ToddHoug/cadzilla/tools/altairsim/README.md

# tools/altairsim — CADzilla's 8080/CP/M build-and-run environment

Every `software/<toolchain>/<project>` in this repo is a program meant to run under CP/M
2.2. It is one of these:
- 8080 assembly built inside CP/M by `ASM.COM` or `M80`;
- 8080, 8085 or Z80 assembly or C, built on the host by z88dk
  (`tools/z88dk/README.md`).

 Before it ever touches real S100/Altair hardware,
it's built and exercised on [altairsim](https://github.com/) (installed
locally at `~/altairsim`), driven by an AI assistant through altairsim's
built-in MCP server. This directory holds everything that workflow needs.

## Naming convention

**Files that pass through the CP/M toolchain are UPPERCASE on both the
host and the CP/M side** — everything under `software/<toolchain>/<project>/src/` and
`software/<toolchain>/<project>/build/` (`HELLO.ASM`, `HELLO.COM`, `HELLO.HEX`,
`HELLO.PRN`, ...), and every `ASM`/`LOAD`/run/`W` argument typed at the
CP/M console. The same name is used consistently everywhere — no renaming
between host and CP/M. Directory names (`software/asm/hello/`, `src/`,
`build/`, `work/`) still follow this repo's normal lowercase convention
(`CLAUDE.md`); only the files themselves are uppercase.

This also sidesteps a real gotcha explained below: CP/M uppercases
everything you type at its console anyway, so a mixed-case CP/M-side name
could never be created from the command line in the first place.

## Layout

- `pristine/` — the read-only master copy of the CP/M machine definition
  (`cadzilla.toml`) and the disk image templates (`CPM22SYS.DSK`,
  `EMPTY.DSK` — see "Disk images" below). **Never edit or boot these directly** — always work
  against a copy in a project's own `work/` (below). CP/M writes to a
  mounted disk in place, so booting or `CONFIG LOAD`-ing
  `pristine/cadzilla.toml`, or `MOUNT`-ing a pristine `.DSK`, writes
  whatever you build straight into the master image (this has happened:
  HELLO project files ended up in the pristine CP/M disk). As a guard the
  pristine files are kept **read-only on the host** (`sync_pristine.sh`
  re-applies `chmod a-w` on every run, since git doesn't track write
  permission), and altairsim then mounts them `WRITE-PROTECTED`. If CP/M
  ever reports a write-protect error, the wrong disk is mounted — fix
  the path, never the permissions. `git status tools/altairsim/pristine`
  should always be clean after a session. `cadzilla.toml` is a
  delta on altairsim's own `machines/cadzilla.toml` — the real board with
  its console, front panel, flat-out CPU, host bridge, an empty disk
  controller and 56K of RAM — adding what CP/M needs to boot: 62K of
  RAM (0000-F7FF) and the DBL boot PROM at FF00, this project's disks in drives 0 and 1, the
  `RUN FF00` startup and the console's Backspace mapping — plus the
  monitor resolution (cad0 `mode = "1024x768"`), stated explicitly rather
  than inherited from the base (see "Display resolution"). See the comments
  in the file itself for the full reasoning. `CPM22SYS.DSK` (drive 0) is an 8MB virtual hard disk
  carrying CP/M 2.2 for 62K of RAM (0000-F7FF; see "62K CP/M" below) and its tools (`ASM.COM`,
  `LOAD.COM`, `DDT.COM`, Microsoft's `M80`/`L80`/`LIB80`/`CREF80.COM`,
  DRI's `RMAC`/`LINK`/`LIB`/`XREF.COM` (see "The DRI RMAC/LINK
  toolchain"), the
  host-bridge `R`/`W`/`HDIR.COM`, and more disk tools than the old 8"
  floppy image had room for); `EMPTY.DSK` is an empty 8MB volume, the
  template for a project's scratch disk and czgfx's build disk. `cadzilla-real.toml` is the
  real-time variant — a delta on the `cadzilla.toml` beside it that sets a
  2 MHz CPU and cad0 `draw_rate = "real"` (see "Running in real time").
- `scripts/sync_pristine.sh [--machine-only] <dest-dir>` — copies the
  pristine machine and the disks into any destination directory, creating
  it if needed: `CPM22SYS.DSK` as is, and `EMPTY.DSK` as `SCRATCH.DSK`. Used to set up a new project's own `work/`, and to recover a
  work directory that's ended up in a bad state. `--machine-only` copies
  just the machine files (`cadzilla.toml`, `cadzilla-real.toml`) and leaves the destination's disks alone — use it to
  pick up a change to the pristine machine definition in every existing
  `software/*/*/work/` without losing what's been built there. Either way,
  if the directory above `<dest-dir>` has a `machine.toml` (the project's
  tracked overlay, `software/<toolchain>/<project>/machine.toml`), it is appended to
  the copied `cadzilla.toml` — see "Display resolution". It makes the
  copies writable, keeps pristine read-only, and refuses to target
  `pristine/` itself.
- `scripts/attach_libdisk.sh [--writable] <work-dir>` — gives a work
  machine the czgfx library as drive 1 (CP/M `B:`), read-only:
  - it copies the czgfx release the project pins in
    `software/<toolchain>/<project>/czgfx.version` into `work/` as
    `CZGFXLIB-<version>.DSK`, and mounts it;
  - it removes copies of releases no longer pinned, and the now-unmounted
    `SCRATCH.DSK`, but only if they are unchanged.

  `--writable` is for czgfx's own `work/` alone: it mounts the build disk
  `software/m80/czgfx/libdisk/CZGFXLIB.DSK` writable, creating it from
  `pristine/EMPTY.DSK` if needed. See "The M80/L80 toolchain" below. Re-run
  it after
  `sync_pristine.sh --machine-only`, which puts the pristine drive 1 back.
- `upstream/` — a local, gitignored cache of the upstream archives and disk
  images that third-party tools on the pristine disk were taken from. Only
  its `README.md` (provenance, SHA-256s, licence) is tracked.
  `scripts/fetch_upstream.sh` (re)creates it:
  - it downloads `yazecpm3.zip` and z80pack's `Z80PACK-CPM3-2.DSK`;
  - it checks every download against a pinned SHA-256;
  - it extracts the DRI tools, uppercased, into `upstream/DRI/`, ready for
    `R`.
- `scripts/check_dsk.py <image.DSK>...` — checks every sector of a CP/M
  disk image for a valid stop byte and checksum; exit status 1 on any bad
  sector. Run it on a project's disks after a session. A bad sector means
  the disk was unmounted while the BIOS was still flushing (see "Ending a
  session").
- `scripts/crlf.sh <file>...` — gives text files CP/M's CR/LF line
  endings in place (idempotent). Run it on every `.ASM`/`.MAC`/`.INC`/`.SUB`
  before `R`: files written on this host are LF-only, and an LF-only
  source assembles to nothing without an error.
- `scripts/cpmsession.py build <project>` — the CP/M side of a build, run
  headlessly, with no assistant and no typing. It is what `tools/build.sh`
  runs; see "Building without an assistant" below.
- `DRIVING-WITH-AI.md` — altairsim's own guide for driving it via MCP
  (kept here for reference; canonical copy lives in `~/altairsim/docs/`).

**Every `software/<toolchain>/<project>/` also has its own `work/`** — a project's
private, gitignored copy of the pristine machine + disk(s), created once
(by the `new-cadzilla-project` skill, or by hand with `sync_pristine.sh`)
and then persisting across sessions for that project alone. Because each
project's disk is its own, switching between projects never means
resetting anything — you just point the server at a different project's
`work/cadzilla.toml`.

## Disk images

Disk images are named for what they hold, not where they came from. The
names are host-side only (CP/M never sees them) and UPPERCASE, as the
other files that pass through CP/M are.

| Image | Where | Holds | Mounted as |
|---|---|---|---|
| `CPM22SYS.DSK` | `pristine/` | the template: CP/M 2.2 (62K) and the dev tools | never — it is only copied |
| `EMPTY.DSK` | `pristine/` | the template: an empty 8MB volume | never — it is only copied |
| `CPM22SYS.DSK` | `software/<toolchain>/<project>/work/` | the project's own copy of the system disk: CP/M, the tools, and everything built there | drive 0, `A:` |
| `SCRATCH.DSK` | `software/<toolchain>/<project>/work/` | a copy of `EMPTY.DSK`, for scratch | drive 1, `B:`, in the DRI `ASM` projects |
| `CZGFXLIB.DSK` | `software/m80/czgfx/libdisk/` | the czgfx library as last built: `CZGFX.INC`, `CZGFX.REL`, `CZLINK.SUB` | drive 1, `B:`, writable, in czgfx's own `work/` only |
| `CZGFXLIB-<version>.DSK` | `software/m80/czgfx/releases/` | a czgfx release, snapshot of the build disk (tracked, never changed) | never — it is only copied |
| `CZGFXLIB-<version>.DSK` | `software/<toolchain>/<project>/work/` | the project's own copy of the czgfx release it pins in `czgfx.version` | drive 1, `B:`, read-only, in the M80 projects |
| `CZBDEMO.DSK` | `software/m80/czbasic/demodisk/` | the bootable CZBASIC demo disk | drive 0 of its own machine |
| `CADZILLA.DSK` | `demodisk/` | every program but the hello examples, on a copy of `CPM22SYS.DSK`; made by `tools/demodisk.py` (gitignored) | drive 0 of its own machine |

`sync_pristine.sh` makes the `work/` copies of the templates. `attach_libdisk.sh`
swaps an M80 project's `SCRATCH.DSK` for its own copy of its pinned czgfx
release. A `work/` is therefore self-contained: nothing it mounts lies
outside it.

### 62K CP/M

The pristine system disk was a 56K CP/M until 2026-10-08. It is now a **62K
CP/M 2.2**:
- **Memory map:** CCP at C600H, BDOS at CE06H, BIOS from DC00H to F7FFH.
  The TPA runs from 0100H to CDFFH, 6 KB more than before.
- **The reason:** GSX graphics. GDOS loads its device driver below itself,
  out of the program's TPA. With the CADzilla driver (`software/rmac/ddcz`, 11.5
  KB) that left too little for DR Graph or DEMOGRAF.
- **How it was built:** with the disk's own tools, on a copy, never in
  place:
  - `MOVCPM8M 62 *`, then `SYSGEN` (source: RETURN to skip, destination:
    `A`);
  - 60 sectors of the two system tracks changed, and nothing else;
  - booted on a 62K machine, it passed ASM/LOAD, RMAC/LINK, a warm boot,
    DEMOGRAF and DR Graph.
- **The machine:** pristine `cadzilla.toml` now gives mem0 62K of RAM
  (0000-F7FF), below the DBL boot PROM at FF00.

What it means for each disk:
- **Older disks still work:** a `work/` disk synced before 2026-10-08 is
  still the 56K system, and boots on either machine.
- **A 62K disk does not boot on a 56K machine.** A `work/` that holds a
  62K disk needs the 62K `cadzilla.toml`, which `sync_pristine.sh` gives
  it.
- **To move a project to 62K,** re-sync its `work/` with
  `sync_pristine.sh software/<toolchain>/<name>/work`. That discards what was built
  there.
- **Real hardware** needs 62K of RAM below the boot PROM for this disk.

## Building without an assistant

`tools/setup.sh` sets up a fresh clone: it checks the dependencies, then
builds every project. A project's own `build.sh`, e.g.
`software/asm/hello/build.sh`, rebuilds just that project. Both run
`tools/build.sh <project>`, which does three things:

1. **The machine and disks.**
   - If `work/` is missing, `sync_pristine.sh` creates it.
   - If `work/` exists, its disks are kept. Only the machine files are
     refreshed (`--machine-only`), and only when `machine.toml` or
     pristine's machine is newer.
   - `attach_libdisk.sh` gives a project that pins czgfx its release as
     `B:`, and gives czgfx itself its writable build disk.
   - `--clean` re-syncs `work/` from pristine first, discarding everything
     on its disks.
2. **The host build** (z88dk and zcc): `tools/z88dk/z88build.sh` or
   `zccbuild.sh`.
3. **The CP/M side**: `scripts/cpmsession.py` starts
   `altairsim work/cadzilla.toml --mcp` and talks to it over JSON-RPC on
   stdio, as a program rather than an assistant.
   - It runs the same steps as the skills: boot, `R *.*` from `src/`, then
     `ASM`/`LOAD`, `M80` + `SUBMIT B:CZLINK`, or `SUBMIT <NAME>`.
   - It `W`s the outputs into `build/`, waits for `idle`, unmounts both
     drives and runs `check_dsk.py`.
   - A z88dk/zcc `.COM` is only `R`'d onto `A:`.

Either way the program ends up on the project's `A:`. So
`cd software/<toolchain>/<name>/work && altairsim cadzilla.toml` boots
straight to `A0>` with it ready to run. Ctrl-E gives the monitor, `RUN`
resumes, and `QUIT` leaves. Wait at `A0>` a moment first, so the BIOS has
written its last track (see "Ending a session").

- **Outputs.** The binary outputs are:
  - asm: `<NAME>.COM`;
  - m80: `<NAME>.COM`;
  - rmac: whatever the `.SUB`'s `LINK` lines write (`.COM`, or `.PRL`
    with `[OP]`).

  The text outputs are `.HEX`/`.PRN`, or `*.PRN` and `*.SYM` for rmac.
- **`cpmbuild.conf`.** A project the default recipe doesn't fit has a
  tracked `cpmbuild.conf` beside `src/` (`name`, `submit`, `binary`, `text`,
  `put`; see `cpmsession.py`). czbasic (`SUBMIT CZBBLD`), czgfx
  (`SUBMIT CZBUILD`) and dxfview (its `dxf/` drawings go on `A:` too) have
  one.
- **Failure.** CP/M's tools return no exit status, so the transcript is
  scanned instead. A build fails on:
  - M80's `N Fatal error(s)`, L80's `?`/`%` lines and
    `Undefined Global(s)`;
  - ASM, M80 and RMAC error flags;
  - LINK's `UNDEFINED SYMBOLS`, `Unsatisfied external`, the CCP's `NAME?`,
    or a BDOS error;
  - a named output that never arrives.

  A failed build's program is `ERA`'d on `A:` and not pulled back; its
  listings are. The exit status is 1, the error lines are printed, and the
  whole session is in `build/<NAME>.LOG`. `--verbose` echoes it live.
- **One machine per disk.** `work/.lock` keeps two builds apart. Don't
  build a project whose `work/` is loaded in the MCP server at the same
  time: both would write the same image. `UNMOUNT` there first.
- **Reproducibility.** ASM, RMAC/LINK, z88dk and zcc outputs rebuild
  byte for byte. An L80 `.COM` doesn't quite: L80 writes whatever is in
  memory into `DS` (uninitialized) areas, so those bytes vary between
  builds. The code doesn't.

## One-time setup (per machine)

The `claude` CLI isn't always on `PATH` in every environment (e.g. inside
the VS Code extension's sandboxed shell, it's bundled as a native binary
instead, and the exact path changes as the extension updates versions). If
`claude --version` doesn't work, find the current bundled binary under
`~/.vscode/extensions/anthropic.claude-code-*/resources/native-binary/claude`
and symlink it onto `PATH` (re-run this if the extension updates and the
symlink goes stale):

```bash
ln -sf ~/.vscode/extensions/anthropic.claude-code-*/resources/native-binary/claude \
       ~/.local/bin/claude
```

## Starting a session

From the **repo root**:

```bash
cd /home/thoug/Projects/cadzilla
claude mcp add altairsim -- /home/thoug/altairsim/build/altairsim -m cadzilla --mcp
claude mcp list   # confirm "altairsim" is registered and reachable
```

(Migrating from an older registration that pointed at a
`tools/altairsim/work/cadzilla.toml` file? `claude mcp remove altairsim`
first, then add it as above.)

Registration uses local scope (the default) since it embeds an absolute,
machine-specific path to the altairsim binary — it's stored in your own
Claude config, not committed to the repo. A newly registered MCP server's
tools may not appear until the session/window is reloaded.

The server starts on altairsim's **built-in `cadzilla` machine** (`-m
cadzilla`): the real board with its console, front panel, host bridge and
an empty disk controller — **no disks mounted and no boot PROM**, so
nothing can be written anywhere until you choose a project. The first
real step of any session is always `CONFIG LOAD`-ing the project you're
about to work on (see "Working on a project" below). No repo file is
named in the registration, so nothing in the repo has to exist for the
server to start, and no project's disks are held open by a server that
outlives its session.

### Resuming a session — check the disk is actually mounted

Once registered, the `altairsim` MCP server is a long-lived process that
can easily outlive a single conversation — a later Claude Code session (or
even a later turn in the same one) may find the guest already booted and
sitting at a prompt from before. That's not the same as a fresh, working
machine: if the previous session ended cleanly with `UNMOUNT` (as it
should), the disk is gone from under a CP/M that's still technically
"running" and looks alive. Every disk access then fails with `Bdos Err On
A: Bad Sector`, which reads like corruption but isn't — there's simply
nothing mounted. It's also possible to find the guest sitting at PC 0 with
every register zeroed and nothing booted at all (a fresh server process
that was never driven through a boot yet) — `regs` tells the two apart.

Check first: `monitor {command: "SHOW MOUNTS"}`. On a freshly started
server every drive shows `(empty)` — that's the built-in machine, as
expected. Either way, if `dsk0:drive0` isn't your project's disk, don't
`MOUNT` a disk by hand: `CONFIG LOAD` the project's own
`work/cadzilla.toml` again (it mounts both of that project's disks,
resolved against its own `work/`) and do a clean boot, `run {from:
0xFF00, until: "A0>"}`, before touching the disk. The boot isn't
optional: a disk mounted out from under a CP/M that's already running
(rather than through its own boot-time disk detection) makes BDOS
defensively mark the drive read-only (`Bdos Err On A: R/O`) until the
next warm boot clears it.

## Working on a project — each one has its own disk

Every project's `work/` is its own persistent copy of the pristine
machine + disk(s) (see "Layout" above), so there's no shared state to
reset when switching between projects — just point the server at the
project you're working on:

```
monitor {command: "CONFIG LOAD <repo-root>/software/<toolchain>/<name>/work/cadzilla.toml"}
run {from: 0xFF00, until: "A0>"}
```

(`CONFIG LOAD` swaps the running server's machine definition without
restarting the MCP connection or needing a session reload — safe to use
any time you're at a clean prompt, between commands.) The mount-and-reboot
notes above still apply per project: `SHOW MOUNTS` before assuming a
`CONFIG LOAD` alone leaves you ready to go.

If a project doesn't have a `work/` yet (an existing project from before
per-project disks, or one someone set up by hand without it), create one
the same way the `new-cadzilla-project` skill does:

```bash
tools/altairsim/scripts/sync_pristine.sh software/<toolchain>/<name>/work
```

### Reference

Per-project machine settings and the toolchain details are in
[REFERENCE.md](REFERENCE.md); open only the section the task needs.

- Display resolution, choosing the CPU, running in real time, the `A0>` prompt
- The M80/L80 toolchain and the czgfx library
- The DRI RMAC/LINK toolchain
- GSX graphics

## The host bridge (`R`/`W`) and CP/M's automatic uppercasing

`R`/`W` genuinely do support subdirectory paths and a rename argument (e.g.
`R SUBDIR/FOO.TXT` works, and `W FOO.BIN RENAMED.BIN` really does create
`RENAMED.BIN`) — confirmed by testing directly against an **uppercase**
scratch subdirectory. The catch is CP/M itself: the CCP reads the command
line through BDOS function 10 (buffered console input), which **uppercases
every lowercase letter you type** before any program — including `R`/`W`
— ever sees it. Since this repo's directories and filenames are lowercase
by convention (per `CLAUDE.md`), any path or filename typed at the prompt
gets uppercased first and then fails a case-sensitive lookup against the
real lowercase host paths (`R software/asm/hello/src/hello.asm HELLO.ASM`
becomes `R SOFTWARE/HELLO/SRC/HELLO.ASM HELLO.ASM` internally, and
`software/` on the host doesn't match `SOFTWARE/`).

There's no way around the uppercasing from inside CP/M — instead, repoint
`hb0` at the exact directory you need with `SET hb0 HOSTDIR=<abs path>`
(a `monitor` command, entered outside CP/M's console and therefore not
subject to its uppercasing) before each `R`/`W`, and use bare filenames:

```
monitor {command: "CONFIG LOAD /home/thoug/Projects/cadzilla/software/<toolchain>/<proj>/work/cadzilla.toml"}
run {from: 0xFF00, until: "A0>"}                                  # boot CP/M

monitor {command: "SET hb0 HOSTDIR=/home/thoug/Projects/cadzilla/software/<toolchain>/<proj>/src"}
run {input: "R <NAME>.ASM\r", until: "A0>"}                       # host -> CP/M

run {input: "ASM <NAME>\r", until: "A0>", timeout_ms: 20000}      # assemble
run {input: "LOAD <NAME>\r", until: "A0>"}                        # -> .COM
run {input: "<NAME>\r", until: "A0>"}                              # run, capture output

monitor {command: "SET hb0 HOSTDIR=/home/thoug/Projects/cadzilla/software/<toolchain>/<proj>/build"}
run {input: "W <NAME>.COM\r", until: "A0>"}                       # CP/M -> host (binary)
run {input: "W <NAME>.HEX T\r", until: "A0>"}                     # (text)
run {input: "W <NAME>.PRN T\r", until: "A0>"}                     # (text)
```

Since source and build filenames are uppercase on both sides (per the
naming convention above), `R`/`W` need no rename argument at all — the
bare CP/M-side name already matches the desired host filename exactly.
(A rename argument, if you ever use one, is uppercased the same way as
everything else typed at the CP/M console — another reason to just name
things uppercase deliberately rather than fight it.)

**`W` matches an existing host file case-insensitively for overwrite.** If
a lowercase file already exists in the target directory, a `W` whose
(uppercased) name matches it case-insensitively overwrites *that* file in
place — it does not create a separate uppercase-named file alongside it.
Be aware of this if a target directory might already hold a same-named
file in a different case.

**Binary transfers are byte-exact**, verified by round-tripping a 512-byte
file covering the full `00`–`FF` byte range through `R` then `W` with no
`T` flag (identical SHA-256 before and after, including bytes `0D`, `0A`,
and `1A` that text mode treats specially). The only wrinkle is inherent to
CP/M itself, not the host bridge: files are stored in 128-byte records, so
a file whose length isn't a multiple of 128 gets padded with trailing `1A`
(`^Z`) bytes up to the next record boundary on the way in — `W`'d back out
in binary mode, it comes back padded to that same boundary, not its
original length. **Never use the `T` (text) flag on binary data** — it
trims at the *first* `1A` byte found anywhere in the file (not just
trailing padding), which will truncate genuine binary content that happens
to contain that byte value; only use `T` for real text (`.ASM`/`.HEX`/`.PRN`),
where it correctly trims the real trailing `^Z` padding.

Other notes (see `DRIVING-WITH-AI.md` for the full detail):
- Source files must use **CR/LF** line endings — `ASM.COM` silently
  produces an empty assembly on LF-only files.
- `ASM.COM` symbol names can't contain underscores (silently resolve to
  `0`) and are case-insensitive (watch for accidental collisions).
- `ASM.COM` has no `INCLUDE` directive — each `.asm` file is
  self-contained. Projects that need shared code use M80/L80 instead
  (next section).
- If output looks wrong, debug in place rather than guessing:
  `monitor {command: "BREAK <addr>"}`, `STEP`, `DISASM`, `HISTORY`,
  `regs`.

## Adding a new program

(The `new-cadzilla-project` skill automates all of this, including setting
up the project's own `work/` — this is the manual version if you're not
using it.)

1. `software/<toolchain>/<name>/{src,include,build}` — create the directory
   layout (`build/` needs a `.gitkeep`; it's gitignored otherwise), using
   this repo's normal lowercase directory-naming convention.
2. Write `software/<toolchain>/<name>/src/<NAME>.ASM` (CR/LF line endings, uppercase
   filename per the naming convention above).
3. If it draws, write `software/<toolchain>/<name>/machine.toml` pinning cad0's `mode`
   to the resolution the code programs (see "Display resolution").
4. Copy another project's `build.sh` into `software/<toolchain>/<name>/`. It
   is the same three lines everywhere.
5. Run `software/<toolchain>/<name>/build.sh`. It gives the project its own
   `work/` disk (with the overlay applied), builds the program, and pulls
   `<NAME>.COM`/`.HEX`/`.PRN` back into `build/`, already named correctly.
   To do a step by hand instead, `CONFIG LOAD` the project's
   `work/cadzilla.toml` through the MCP tools and drive the build/run/debug
   loop above, repointing `hb0` between the source directory (for `R`) and
   `build/` (for `W`).

## Ending a session

Let the guest go idle at the `A0>` prompt, then unmount, which flushes the
disk image to the host file:

```
run {}                                      # no input, no until: must say stopped: "idle"
monitor {command: "UNMOUNT dsk0:drive0"}
```

**Stopping on `A0>` is not the same as idle.** This CP/M BIOS keeps the
last track it wrote in a RAM buffer, and writes it to the disk only once
the CCP waits for console input, which happens *after* the `A0>` prompt is
printed. A `run` that stopped on `until: "A0>"` can therefore still have
that write outstanding. Unmounting then either loses it, or cuts it short
halfway through a sector, and the next boot says
`Bdos Err On A: Bad Sector`. This has happened to `software/m80/gfxdemo/work`.
So before any `UNMOUNT`, `CONFIG LOAD` or `reset`, run once with no input
and no `until`, and check that it reports `stopped: "idle"`.

Afterwards, `tools/altairsim/scripts/check_dsk.py software/<toolchain>/<name>/work/*.DSK`
should say `ok`.

(And `dsk0:drive1` too — `SCRATCH.DSK`, or an M80 project's own
`CZGFXLIB-<version>.DSK`, which is under the same `work/*.DSK`.)

**Don't force-interrupt a disk operation in flight.** `reset` or `CONFIG
LOAD` mid-`ASM`/`LOAD`/`R`/`W` (e.g. because a `run` call timed out) can
leave the in-memory disk in a half-written state — observed once as a
`.COM` file left with a directory entry showing 0 records despite `LOAD`
having reported a successful write moments earlier, which then made CCP
jump into stale leftover memory instead of the program. If a call times
out, let it keep running (call `run` again with no `input` to keep
draining) rather than resetting; if a project's working disk does end up
in a suspect state, the fix is the same sync used to set it up —
restore it from `pristine/` and rebuild rather than debugging the
corruption:

```bash
tools/altairsim/scripts/sync_pristine.sh software/<toolchain>/<name>/work
```

(This discards everything built on that project's disk since the last
sync, so treat it as a deliberate reset, not a reflex.)

Every project's `work/` is gitignored, so nothing needs to be cleaned up
in git — a fresh copy just needs `sync_pristine.sh` re-run against it.
