ToddHoug/cadzilla/docs/images/cz88gfx/cgfxdemo-05.png

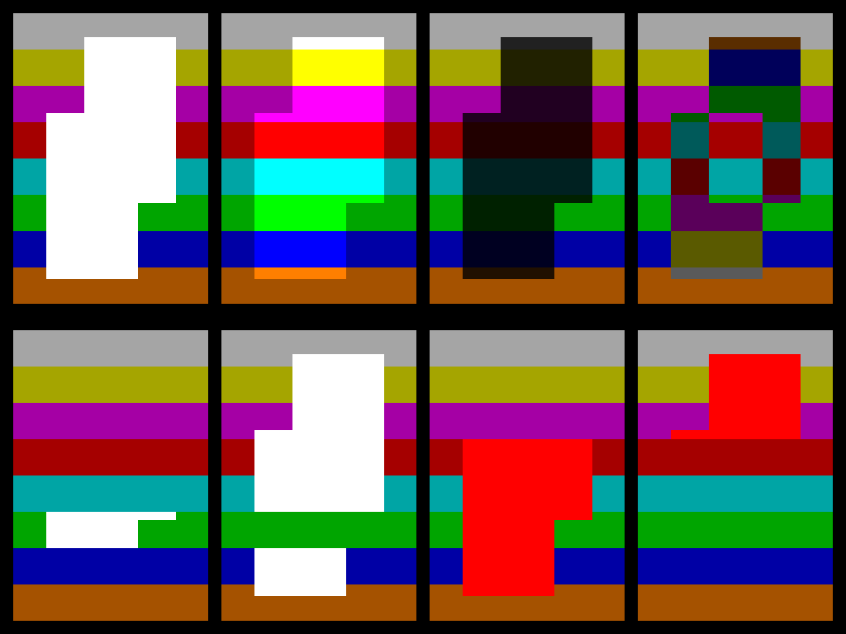
docs/images/cz88gfx/cgfxdemo-05.png
