ToddHoug/cadzilla/docs/images/cz88gfx/cgfxdemo-07.png

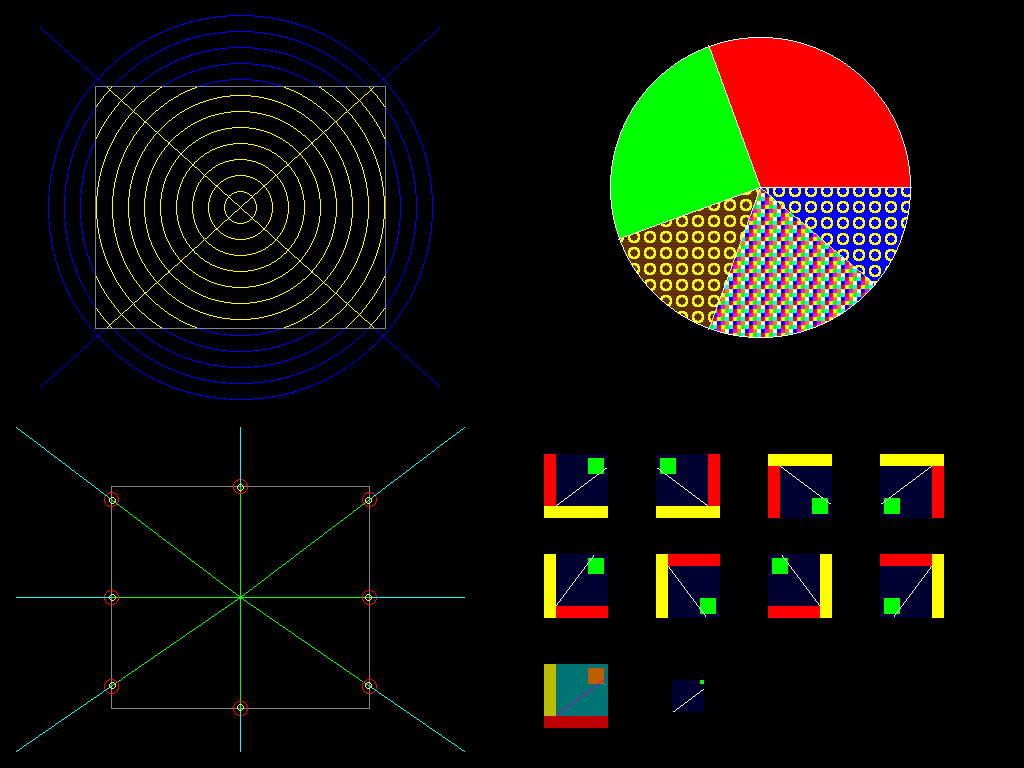
docs/images/cz88gfx/cgfxdemo-07.png
