ToddHoug/cadzilla/docs/images/cz88gfx/cgfxdemo-10.png

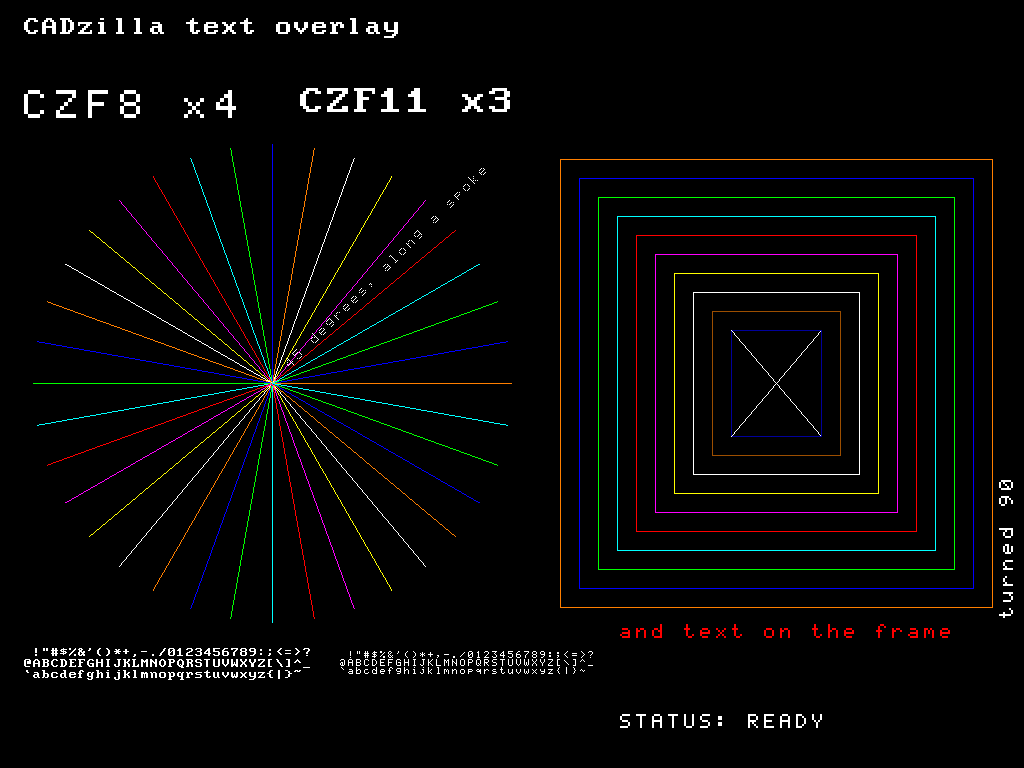
docs/images/cz88gfx/cgfxdemo-10.png
