ToddHoug/cadzilla/docs/images/czgfx/gfxdemo-01.png

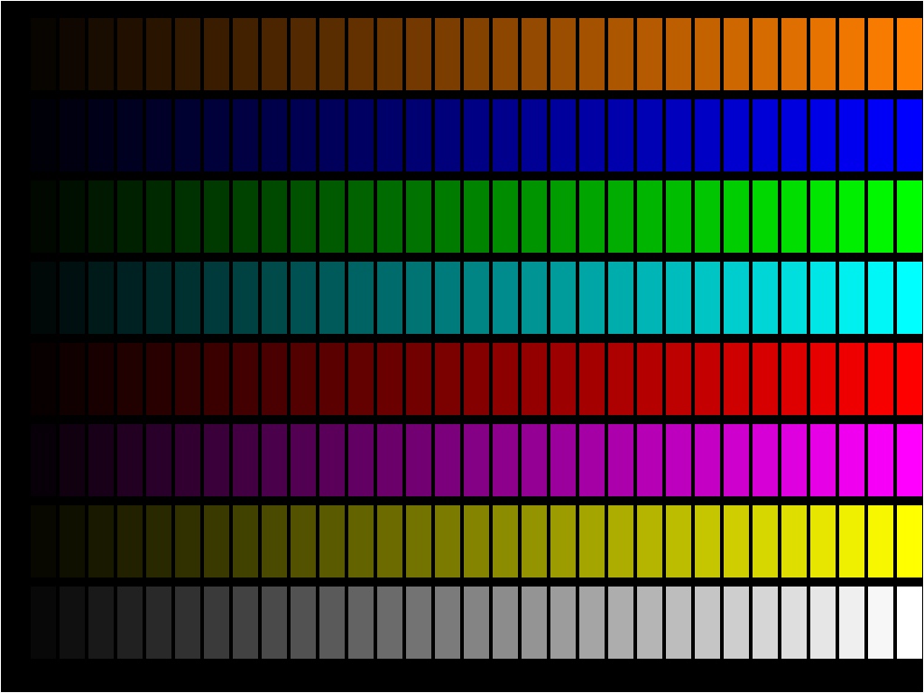
docs/images/czgfx/gfxdemo-01.png
