ToddHoug/cadzilla/docs/images/czgfx/gfxdemo-02.png

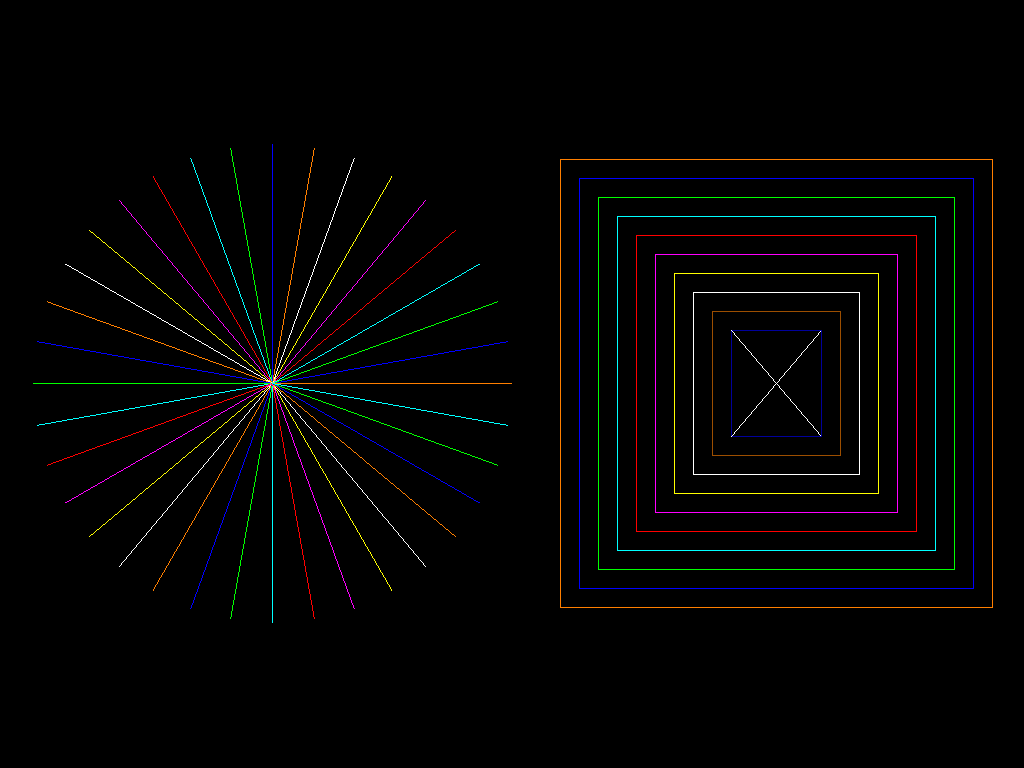
docs/images/czgfx/gfxdemo-02.png
