ToddHoug/cadzilla/docs/images/czgfx/gfxdemo-03.png

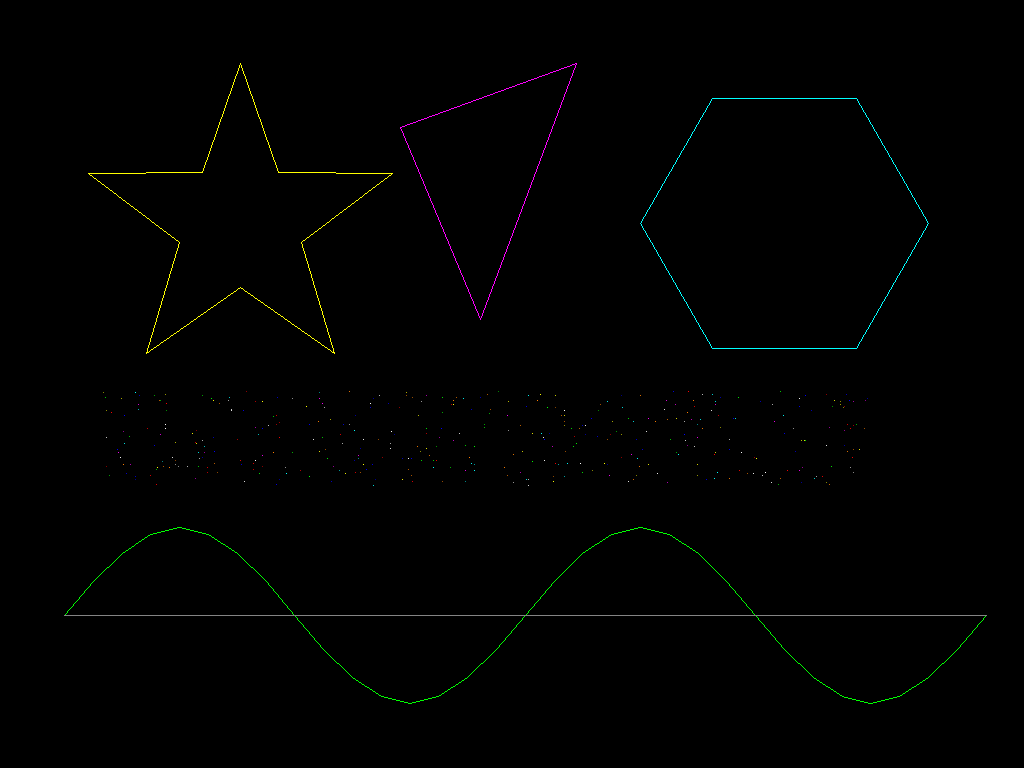
docs/images/czgfx/gfxdemo-03.png
