ToddHoug/cadzilla/docs/images/czgfx/gfxdemo-04.png

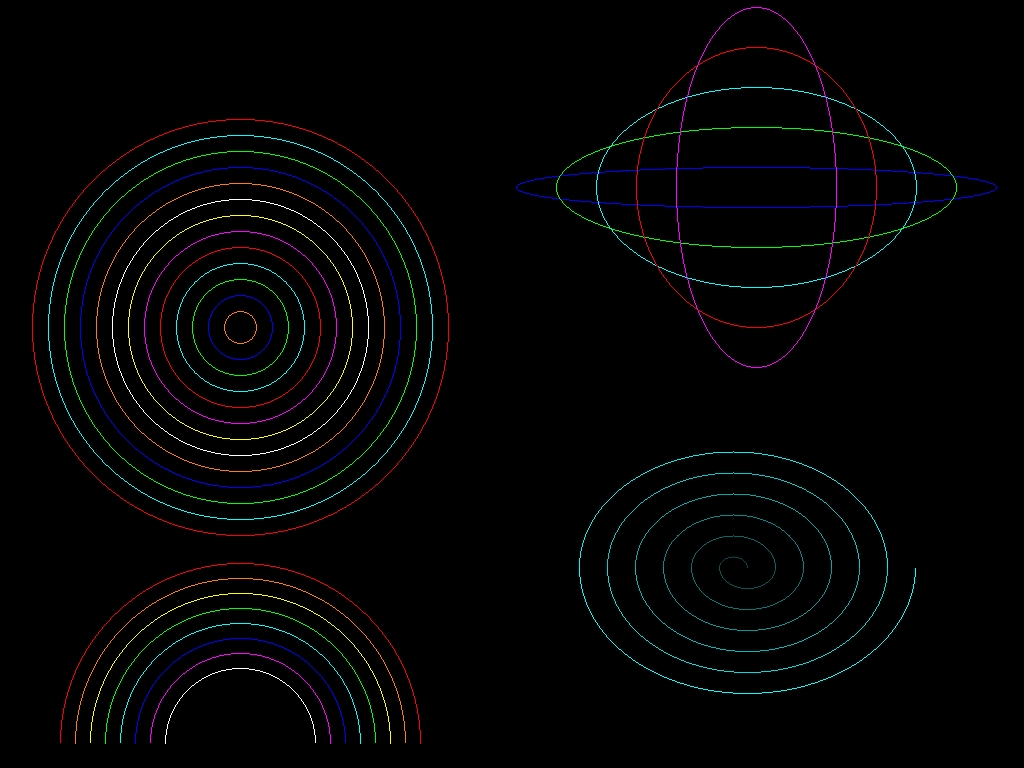
docs/images/czgfx/gfxdemo-04.png
