ToddHoug/cadzilla/docs/images/czgfx/gfxdemo-06.png

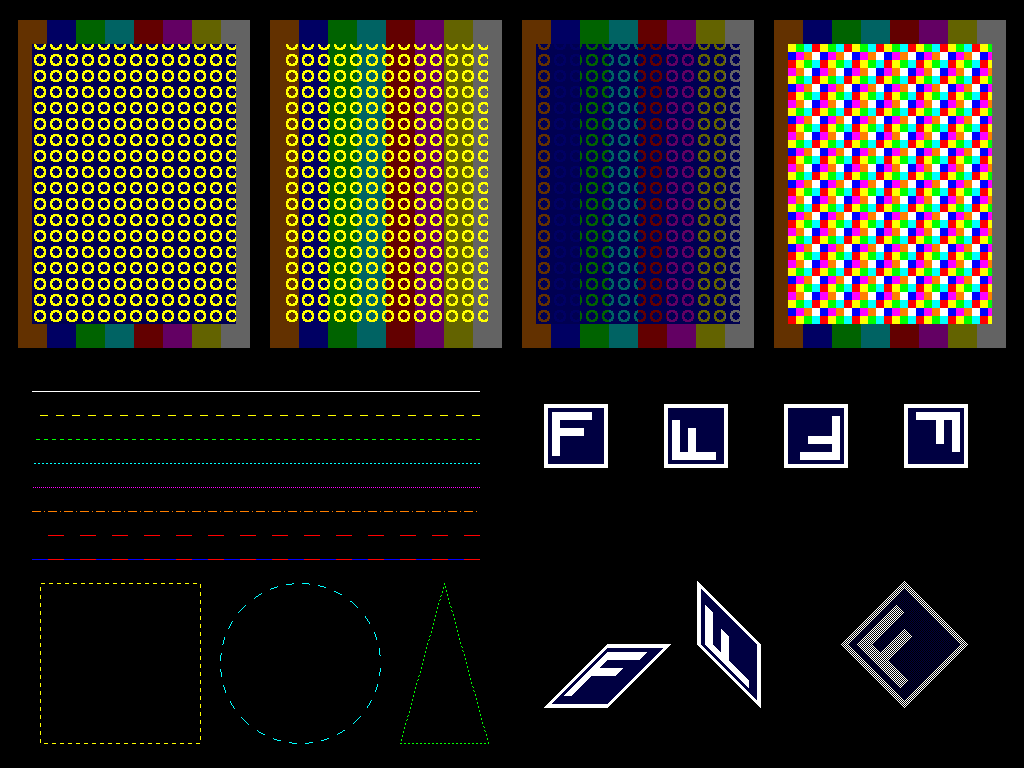
docs/images/czgfx/gfxdemo-06.png
