ToddHoug/cadzilla/docs/images/czgfx/gfxdemo-08.png

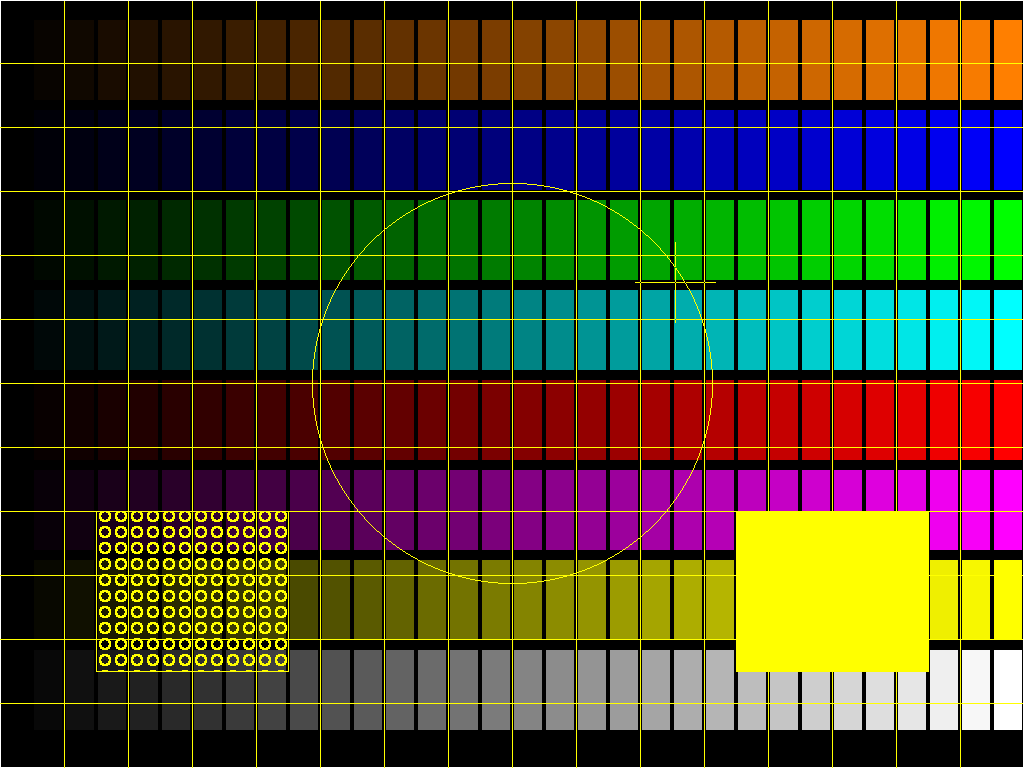
docs/images/czgfx/gfxdemo-08.png
