ToddHoug/cadzilla/schematics/cadzilla.csv

Id | Designator | Footprint | Quantity | Designation | Supplier and ref
1 | C1, C2, C3, C4, C5, C6, C7, C10, C11, C12, C13, C14, C17, C18, C19, C20, C21, C26, C27, C28, C29, C30, C33, C34, C35, C36, C37, C40, C41, C42, C43, C44, C46, C47, C48, C49, C50, C53, C54, C55, C56, C57, C59, C62, C63, C64, C65 | C_Rect_L9.1mm_W2.5mm_P7.62mm_MKT | 47 | 0.1uf
2 | C8, C9, C15, C16, C22, C23, C24, C25, C31, C32, C38, C39, C45, C51, C52, C58, C61 | C_Rect_L9.1mm_W2.5mm_P7.62mm_Small_Pads | 17 | 0.1uf
3 | C66, C67, C68 | C_0805_2012Metric_Pad1.18x1.45mm_HandSolder | 3 | 0.1uf
4 | C69, C88 | C_Rect_L9.1mm_W2.5mm_P7.62mm_MKT | 2 | 10uf
5 | C70, C71, C72, C73, C74, C75, C76, C77, C78, C79, C80, C81, C82, C83, C84, C85, C86, C87 | C_0603_1608Metric_Pad1.08x0.95mm_HandSolder | 18 | 0.1uf
6 | D1 | D_A-405_P7.62mm_Horizontal | 1 | 1.2V
7 | D2, D3, D4, D5, D6, D7, D8, D9, D10, D11 | D_0805_2012Metric_Pad1.15x1.40mm_HandSolder | 10 | 1N4148
8 | FB1 | C_Rect_L9.1mm_W2.5mm_P7.62mm_MKT | 1 | FerriteBead_Small
9 | J1 | DSUB-15-HD_Socket_Horizontal_P2.29x1.90mm_EdgePinOffset3.03mm_Housed_MountingHolesOffset4.94mm | 1 | DE15_Socket_HighDensity
10 | J2 | PinHeader_2x08_P2.54mm_Vertical | 1 | Conn_02x08_Odd_Even
11 | P1 | S100_MALE | 1 | S100_MALE
12 | R1 | R_Axial_DIN0204_L3.6mm_D1.6mm_P7.62mm_Horizontal | 1 | 10K
13 | R7 | R_Axial_DIN0204_L3.6mm_D1.6mm_P7.62mm_Horizontal | 1 | RSET
14 | R8, R9, R10 | R_Axial_DIN0204_L3.6mm_D1.6mm_P7.62mm_Horizontal | 3 | 75R
15 | R11, R12 | R_Axial_DIN0204_L3.6mm_D1.6mm_P7.62mm_Horizontal | 2 | 33R
16 | RN1 | R_Array_SIP8 | 1 | 4.7K
17 | SW1 | DIP-16_W7.62mm_Socket | 1 | SW_DIP_x08
18 | U1 | DIP-64_W22.86mm_Socket | 1 | HD63484P
19 | U2, U3, U4, U5, U6, U7, U8, U9, U10 | DIP-24_W7.62mm_Socket_Small_Pads | 9 | 74F676
20 | U11, U12, U13, U14, U15, U16, U17, U18, U19 | TSOP-II-44_10.16x18.41mm_P0.8mm | 9 | CY62136ESL
21 | U20, U21, U22, U23, U24, U25, U26, U27, U28, U29, U30, U31, U32, U33, U34, U35, U36, U37, U38, U39, U40 | DIP-20_W7.62mm_Socket | 21 | 74F245
22 | U41 | DIP-20_W7.62mm_Socket | 1 | 74LS273
23 | U42 | DIP-14_W7.62mm_Socket | 1 | 74LS04
24 | U43 | DIP-14_W7.62mm_Socket | 1 | 74LS86
25 | U44 | DIP-16_W7.62mm_Socket | 1 | 74LS85
26 | U45, U46, U48, U55, U56, U57, U58 | DIP-20_W7.62mm_Socket | 7 | GAL16V8
27 | U47 | DIP-40_W15.24mm_Socket | 1 | BT453_DIP40
28 | U49, U50 | DIP-20_W7.62mm_Socket | 2 | 74LS573
29 | U51 | DIP-20_W7.62mm_Socket | 1 | 74LS244
30 | U52, U53, U54 | DIP-24_W7.62mm_Socket | 3 | 74ALS857
31 | U59 | TO-220F-3_Horizontal_TabDown | 1 | LM1084-5.0
32 | U60 | DIP-20_W7.62mm_Socket_Small_Pads | 1 | GAL16V8
33 | Y1 | Oscillator_DIP-14 | 1 | ACO-xxxMHz
