ToddHoug/cadzilla/software/zcc/dxfview/dxf/TEST.DXF

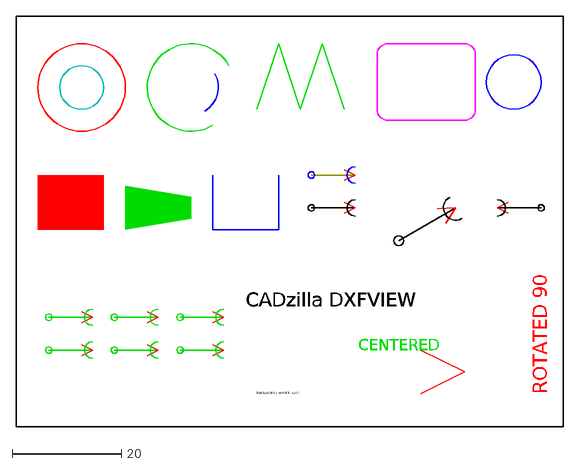
[picture p11: CAD file, 2026-10-23]
software/zcc/dxfview/dxf/TEST.DXF
CADzilla DXFVIEW
ROTATED 90
CENTERED
this text is too small to read
