ToddHoug/cadzilla/software/zcc/dxfview/dxf/COLUMBIA.DXF

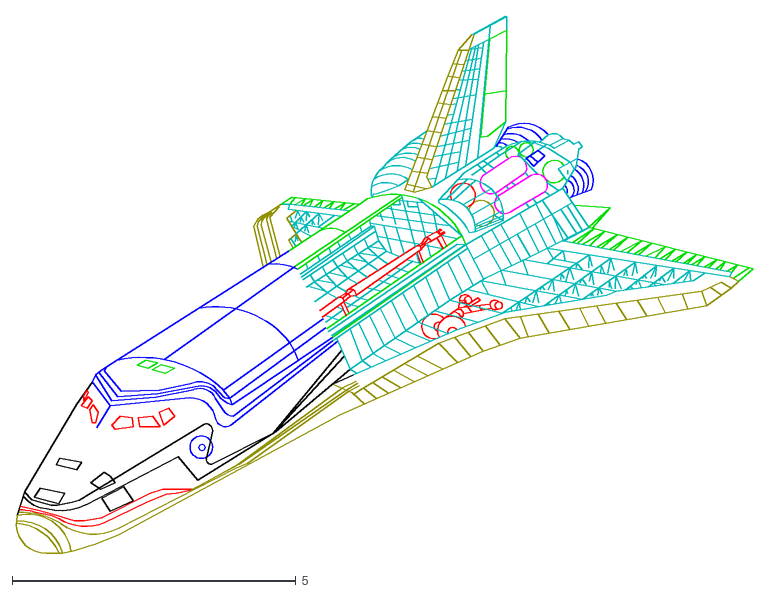
[picture p12: CAD file, 2026-10-23]
software/zcc/dxfview/dxf/COLUMBIA.DXF
13.0 x 9.47
