ToddHoug/cadzilla/software/zcc/dxfview/dxf/SHUTTLE.DXF

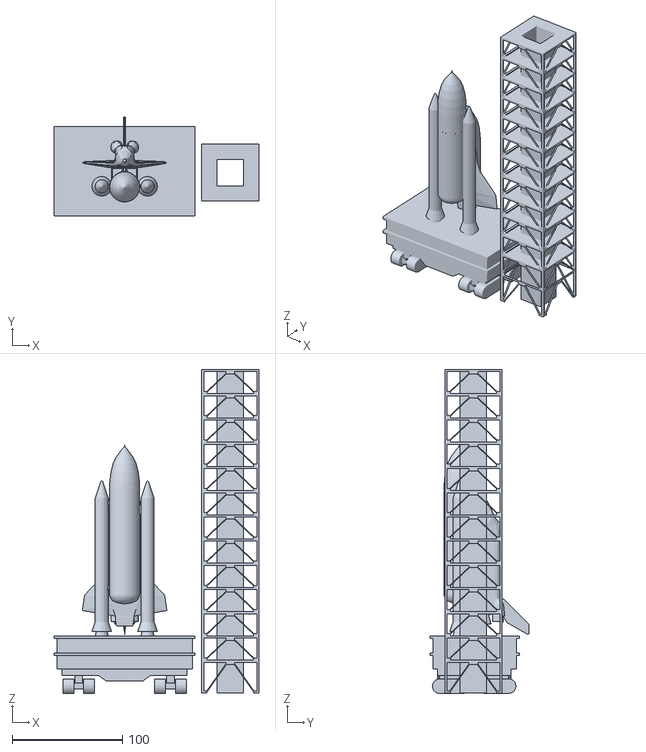
[picture p13: CAD file, 2026-10-23]
software/zcc/dxfview/dxf/SHUTTLE.DXF
186.2 x 90.0 x 294.3
