ToddHoug/cadzilla/schematics/cadzilla.kicad_pcb

## KiCad design schematics/cadzilla.kicad_pcb (2026-10-05)

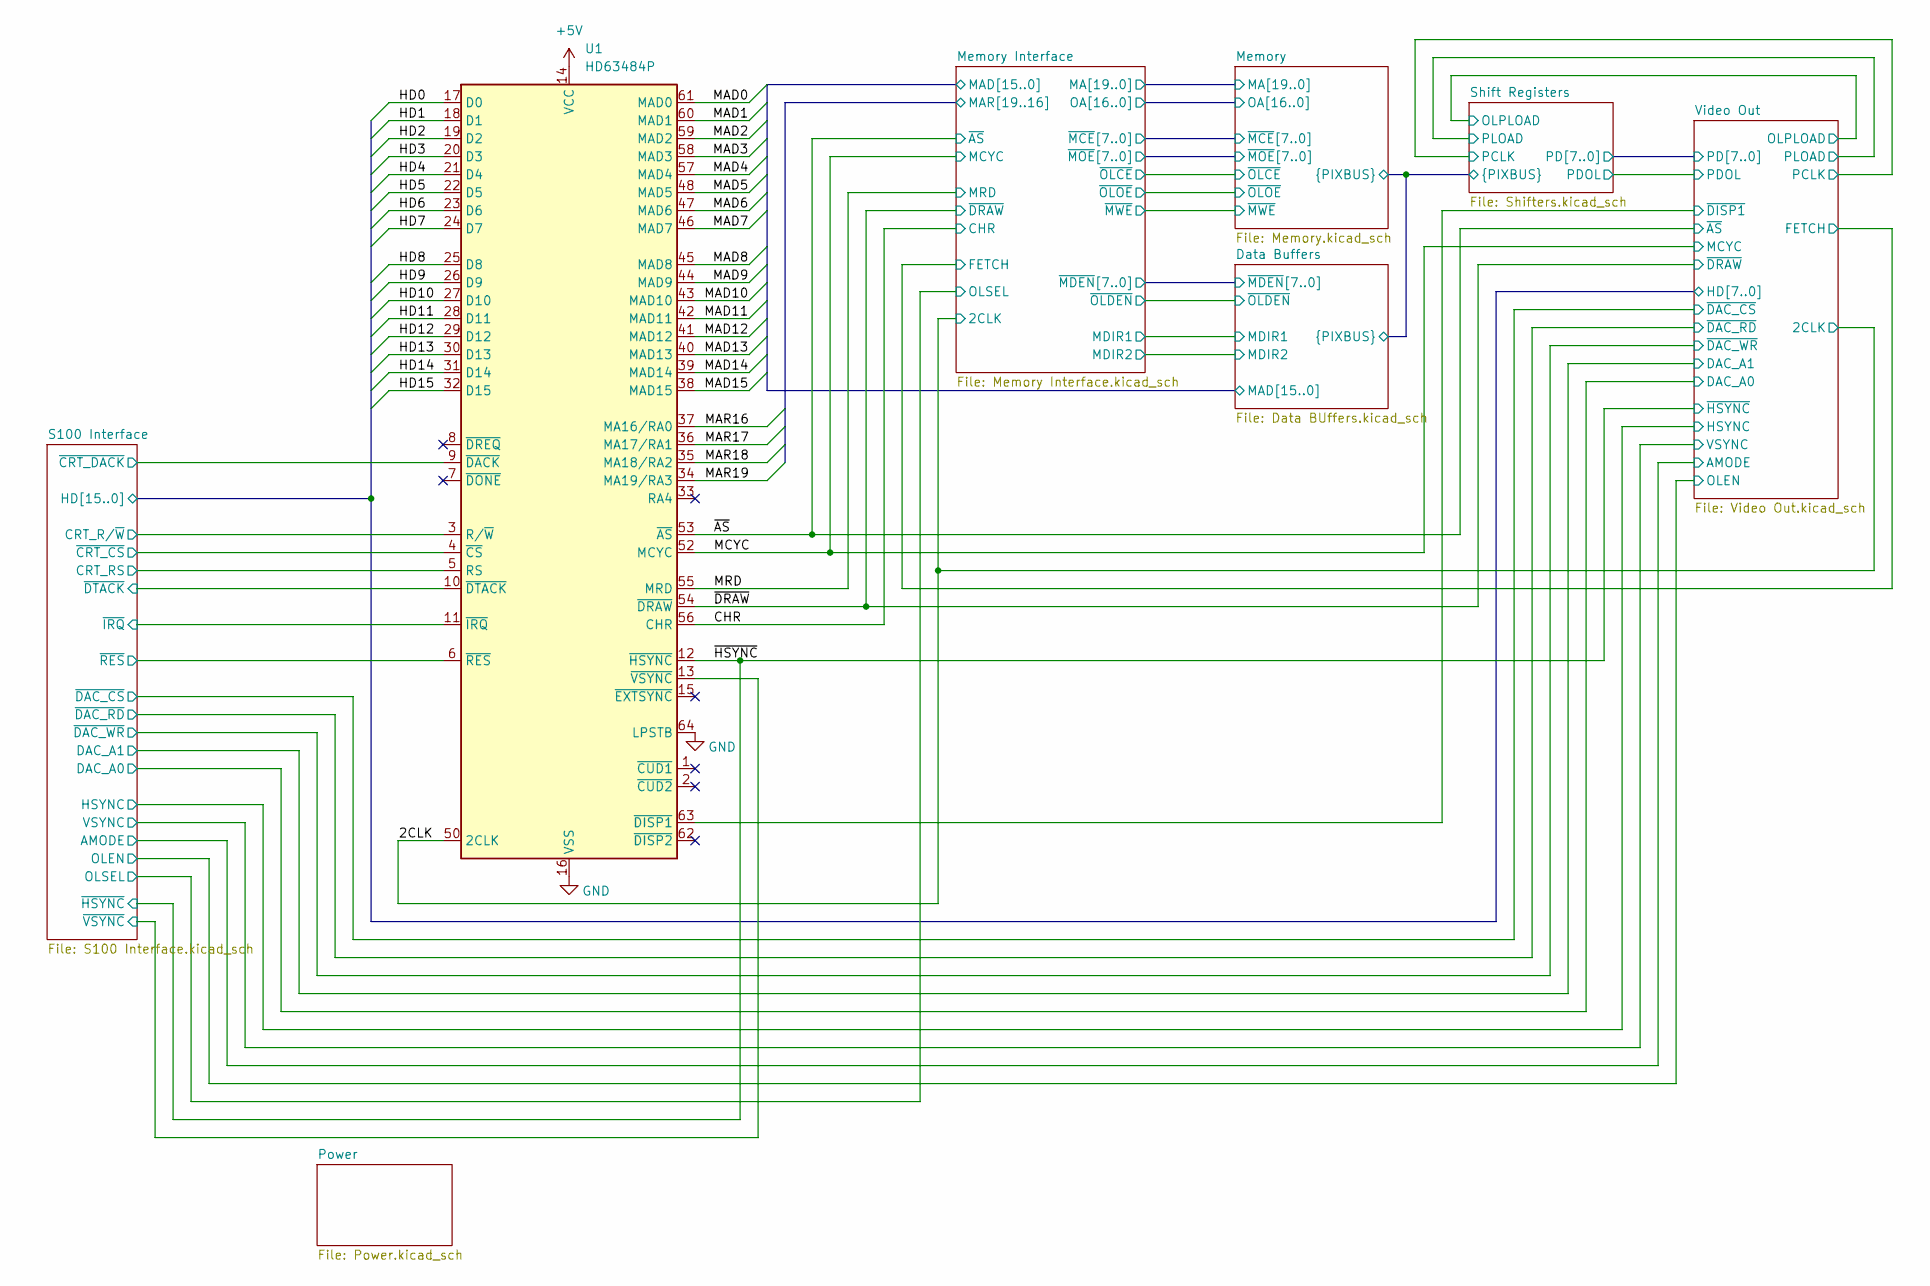
[picture p22: schematic cadzilla.kicad_sch]

Parts:
U1: HD63484P; DIP-64_W22.86mm_Socket

Connections:
+5V: U1.14 (VCC), U1.49 (VCC); also elsewhere on the board
/2CLK: U1.50 (2CLK); also elsewhere on the board
/CHR: U1.56 (CHR); also elsewhere on the board
/Data Buffers/MAD0: U1.61 (MAD0); also elsewhere on the board
/Data Buffers/MAD1: U1.60 (MAD1); also elsewhere on the board
/Data Buffers/MAD2: U1.59 (MAD2); also elsewhere on the board
/Data Buffers/MAD3: U1.58 (MAD3); also elsewhere on the board
/Data Buffers/MAD4: U1.57 (MAD4); also elsewhere on the board
/Data Buffers/MAD5: U1.48 (MAD5); also elsewhere on the board
/Data Buffers/MAD6: U1.47 (MAD6); also elsewhere on the board
/Data Buffers/MAD7: U1.46 (MAD7); also elsewhere on the board
/Data Buffers/MAD8: U1.45 (MAD8); also elsewhere on the board
/Data Buffers/MAD9: U1.44 (MAD9); also elsewhere on the board
/Data Buffers/MAD10: U1.43 (MAD10); also elsewhere on the board
/Data Buffers/MAD11: U1.42 (MAD11); also elsewhere on the board
/Data Buffers/MAD12: U1.41 (MAD12); also elsewhere on the board
/Data Buffers/MAD13: U1.40 (MAD13); also elsewhere on the board
/Data Buffers/MAD14: U1.39 (MAD14); also elsewhere on the board
/Data Buffers/MAD15: U1.38 (MAD15); also elsewhere on the board
/MCYC: U1.52 (MCYC); also elsewhere on the board
/MRD: U1.55 (MRD); also elsewhere on the board
/Memory Interface/MAR16: U1.37 (MA16/RA0); also elsewhere on the board
/Memory Interface/MAR17: U1.36 (MA17/RA1); also elsewhere on the board
/Memory Interface/MAR18: U1.35 (MA18/RA2); also elsewhere on the board
/Memory Interface/MAR19: U1.34 (MA19/RA3); also elsewhere on the board
/S100 Interface/CRT_RS: U1.5 (RS); also elsewhere on the board
/S100 Interface/CRT_R/~W: U1.3 (R/~W); also elsewhere on the board
/S100 Interface/HD0: U1.17 (D0); also elsewhere on the board
/S100 Interface/HD1: U1.18 (D1); also elsewhere on the board
/S100 Interface/HD2: U1.19 (D2); also elsewhere on the board
/S100 Interface/HD3: U1.20 (D3); also elsewhere on the board
/S100 Interface/HD4: U1.21 (D4); also elsewhere on the board
/S100 Interface/HD5: U1.22 (D5); also elsewhere on the board
/S100 Interface/HD6: U1.23 (D6); also elsewhere on the board
/S100 Interface/HD7: U1.24 (D7); also elsewhere on the board
/S100 Interface/HD8: U1.25 (D8); also elsewhere on the board
/S100 Interface/HD9: U1.26 (D9); also elsewhere on the board
/S100 Interface/HD10: U1.27 (D10); also elsewhere on the board
/S100 Interface/HD11: U1.28 (D11); also elsewhere on the board
/S100 Interface/HD12: U1.29 (D12); also elsewhere on the board
/S100 Interface/HD13: U1.30 (D13); also elsewhere on the board
/S100 Interface/HD14: U1.31 (D14); also elsewhere on the board
/S100 Interface/HD15: U1.32 (D15); also elsewhere on the board
/S100 Interface/~CRT_CS: U1.4 (~CS); also elsewhere on the board
/S100 Interface/~CRT_DACK: U1.9 (~DACK); also elsewhere on the board
/S100 Interface/~DTACK: U1.10 (~DTACK); also elsewhere on the board
/S100 Interface/~IRQ: U1.11 (~IRQ); also elsewhere on the board
/S100 Interface/~RES: U1.6 (~RES); also elsewhere on the board
/S100 Interface/~VSYNC: U1.13 (~VSYNC); also elsewhere on the board
/Video Out/~DISP1: U1.63 (~DISP1); also elsewhere on the board
/~AS: U1.53 (~AS); also elsewhere on the board
/~DRAW: U1.54 (~DRAW); also elsewhere on the board
/~HSYNC: U1.12 (~HSYNC); also elsewhere on the board
GND: U1.16 (VSS), U1.51 (VSS), U1.64 (LPSTB); also elsewhere on the board

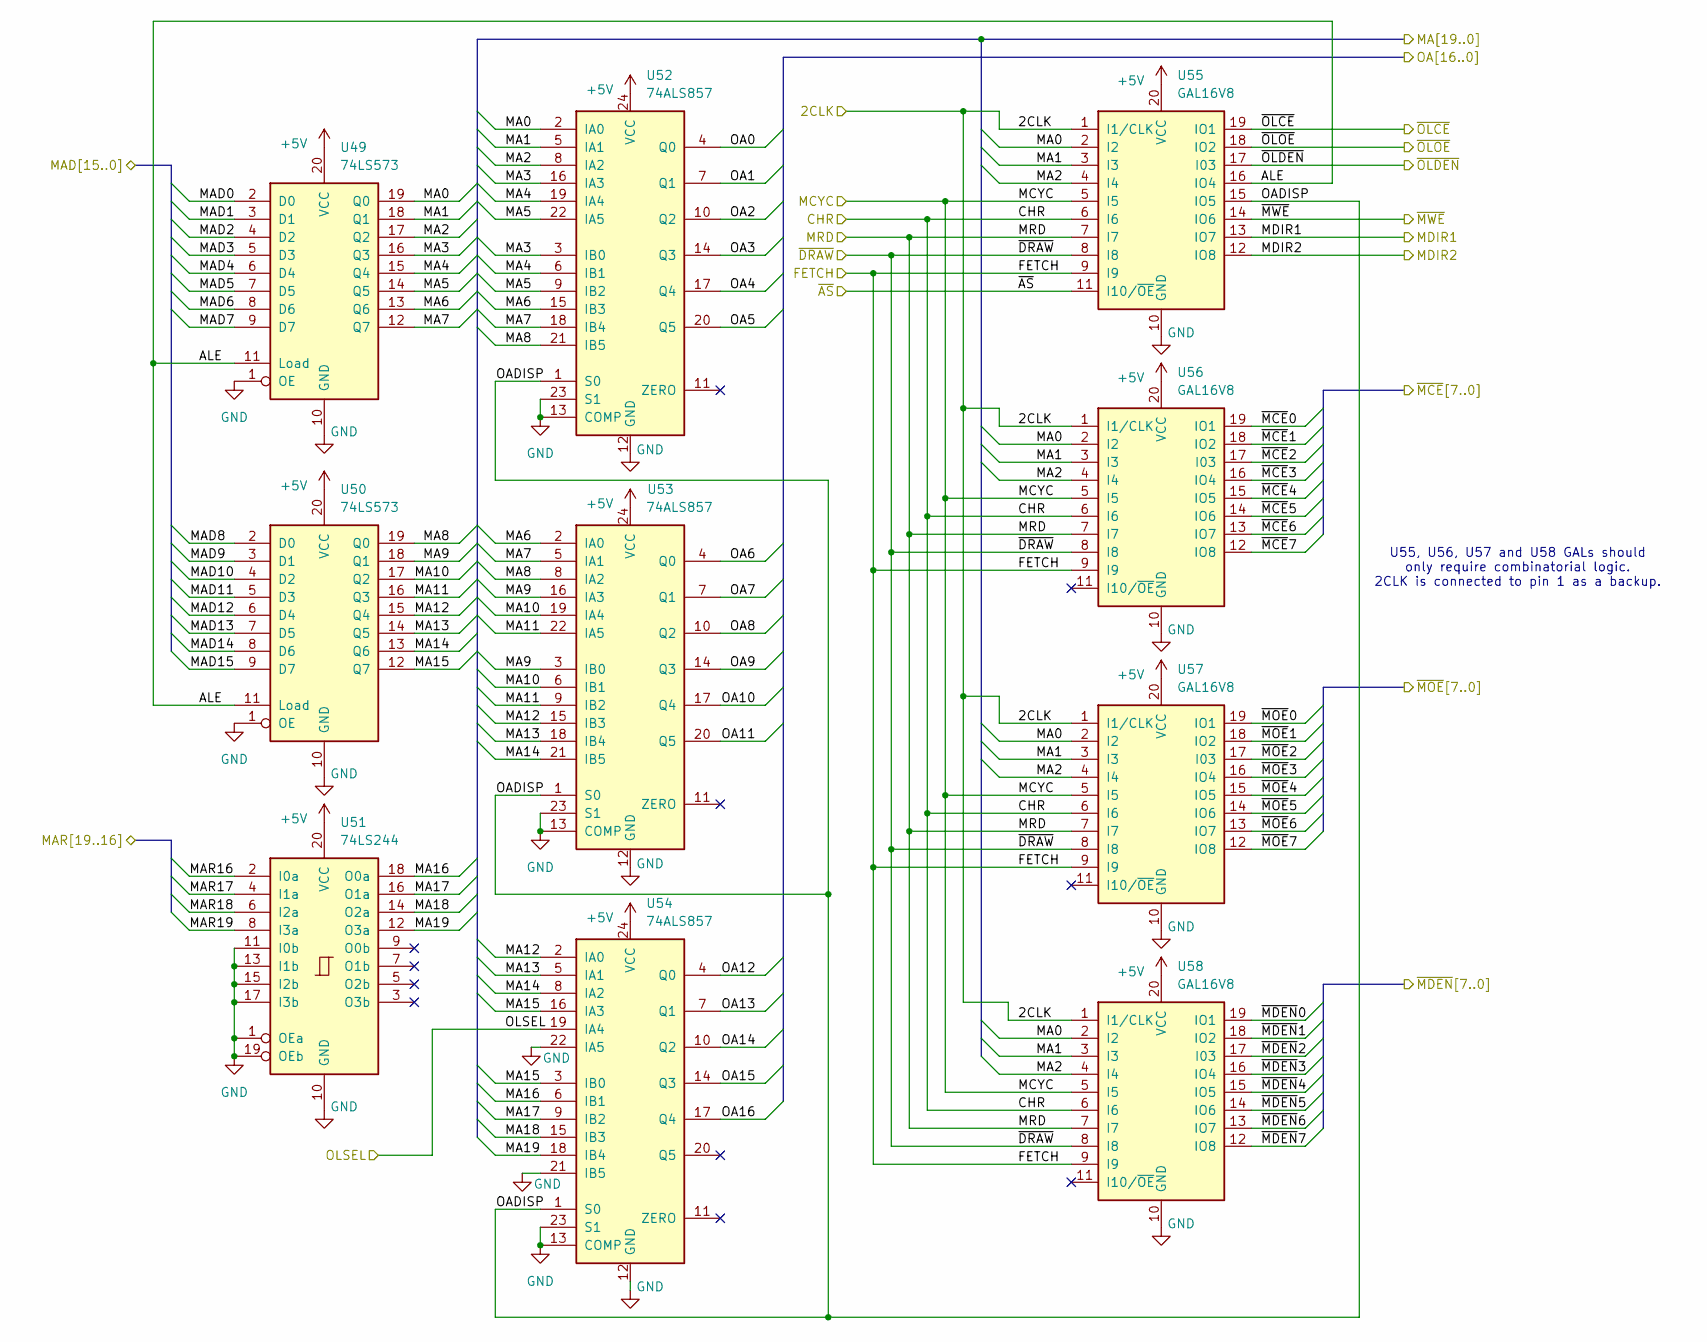
[picture p23: schematic Memory Interface.kicad_sch]

Parts:
U49, U50: 74LS573; DIP-20_W7.62mm_Socket
U51: 74LS244; DIP-20_W7.62mm_Socket
U52, U53, U54: 74ALS857; DIP-24_W7.62mm_Socket
U55, U56, U57, U58: GAL16V8; DIP-20_W7.62mm_Socket

Connections:
+5V: U49.20 (VCC), U50.20 (VCC), U51.20 (VCC), U52.24 (VCC), U53.24 (VCC), U54.24 (VCC), U55.20 (VCC), U56.20 (VCC), U57.20 (VCC), U58.20 (VCC); also elsewhere on the board
/2CLK: U55.1 (I1/CLK), U56.1 (I1/CLK), U57.1 (I1/CLK), U58.1 (I1/CLK); also elsewhere on the board
/CHR: U55.6 (I6), U56.6 (I6), U57.6 (I6), U58.6 (I6); also elsewhere on the board
/Data Buffers/MAD0: U49.2 (D0); also elsewhere on the board
/Data Buffers/MAD1: U49.3 (D1); also elsewhere on the board
/Data Buffers/MAD2: U49.4 (D2); also elsewhere on the board
/Data Buffers/MAD3: U49.5 (D3); also elsewhere on the board
/Data Buffers/MAD4: U49.6 (D4); also elsewhere on the board
/Data Buffers/MAD5: U49.7 (D5); also elsewhere on the board
/Data Buffers/MAD6: U49.8 (D6); also elsewhere on the board
/Data Buffers/MAD7: U49.9 (D7); also elsewhere on the board
/Data Buffers/MAD8: U50.2 (D0); also elsewhere on the board
/Data Buffers/MAD9: U50.3 (D1); also elsewhere on the board
/Data Buffers/MAD10: U50.4 (D2); also elsewhere on the board
/Data Buffers/MAD11: U50.5 (D3); also elsewhere on the board
/Data Buffers/MAD12: U50.6 (D4); also elsewhere on the board
/Data Buffers/MAD13: U50.7 (D5); also elsewhere on the board
/Data Buffers/MAD14: U50.8 (D6); also elsewhere on the board
/Data Buffers/MAD15: U50.9 (D7); also elsewhere on the board
/Data Buffers/~MDEN0: U58.19 (IO1); also elsewhere on the board
/Data Buffers/~MDEN1: U58.18 (IO2); also elsewhere on the board
/Data Buffers/~MDEN2: U58.17 (I03); also elsewhere on the board
/Data Buffers/~MDEN3: U58.16 (IO4); also elsewhere on the board
/Data Buffers/~MDEN4: U58.15 (IO5); also elsewhere on the board
/Data Buffers/~MDEN5: U58.14 (IO6); also elsewhere on the board
/Data Buffers/~MDEN6: U58.13 (IO7); also elsewhere on the board
/Data Buffers/~MDEN7: U58.12 (IO8); also elsewhere on the board
/MCYC: U55.5 (I5), U56.5 (I5), U57.5 (I5), U58.5 (I5); also elsewhere on the board
/MRD: U55.7 (I7), U56.7 (I7), U57.7 (I7), U58.7 (I7); also elsewhere on the board
/Memory Interface/ALE: U49.11 (Load), U50.11 (Load), U55.16 (IO4)
/Memory Interface/FETCH: U55.9 (I9), U56.9 (I9), U57.9 (I9), U58.9 (I9); also elsewhere on the board
/Memory Interface/MA0: U49.19 (Q0), U52.2 (IA0), U55.2 (I2), U56.2 (I2), U57.2 (I2), U58.2 (I2)
/Memory Interface/MA1: U49.18 (Q1), U52.5 (IA1), U55.3 (I3), U56.3 (I3), U57.3 (I3), U58.3 (I3)
/Memory Interface/MA2: U49.17 (Q2), U52.8 (IA2), U55.4 (I4), U56.4 (I4), U57.4 (I4), U58.4 (I4)
/Memory Interface/MA3: U49.16 (Q3), U52.3 (IB0), U52.16 (IA3); also elsewhere on the board
/Memory Interface/MA4: U49.15 (Q4), U52.6 (IB1), U52.19 (IA4); also elsewhere on the board
/Memory Interface/MA5: U49.14 (Q5), U52.9 (IB2), U52.22 (IA5); also elsewhere on the board
/Memory Interface/MA6: U49.13 (Q6), U52.15 (IB3), U53.2 (IA0); also elsewhere on the board
/Memory Interface/MA7: U49.12 (Q7), U52.18 (IB4), U53.5 (IA1); also elsewhere on the board
/Memory Interface/MA8: U50.19 (Q0), U52.21 (IB5), U53.8 (IA2); also elsewhere on the board
/Memory Interface/MA9: U50.18 (Q1), U53.3 (IB0), U53.16 (IA3); also elsewhere on the board
/Memory Interface/MA10: U50.17 (Q2), U53.6 (IB1), U53.19 (IA4); also elsewhere on the board
/Memory Interface/MA11: U50.16 (Q3), U53.9 (IB2), U53.22 (IA5); also elsewhere on the board
/Memory Interface/MA12: U50.15 (Q4), U53.15 (IB3), U54.2 (IA0); also elsewhere on the board
/Memory Interface/MA13: U50.14 (Q5), U53.18 (IB4), U54.5 (IA1); also elsewhere on the board
/Memory Interface/MA14: U50.13 (Q6), U53.21 (IB5), U54.8 (IA2); also elsewhere on the board
/Memory Interface/MA15: U50.12 (Q7), U54.3 (IB0), U54.16 (IA3); also elsewhere on the board
/Memory Interface/MA16: U51.18 (O0a), U54.6 (IB1); also elsewhere on the board
/Memory Interface/MA17: U51.16 (O1a), U54.9 (IB2); also elsewhere on the board
/Memory Interface/MA18: U51.14 (O2a), U54.15 (IB3); also elsewhere on the board
/Memory Interface/MA19: U51.12 (O3a), U54.18 (IB4); also elsewhere on the board
/Memory Interface/MAR16: U51.2 (I0a); also elsewhere on the board
/Memory Interface/MAR17: U51.4 (I1a); also elsewhere on the board
/Memory Interface/MAR18: U51.6 (I2a); also elsewhere on the board
/Memory Interface/MAR19: U51.8 (I3a); also elsewhere on the board
/Memory Interface/MDIR1: U55.13 (IO7); also elsewhere on the board
/Memory Interface/MDIR2: U55.12 (IO8); also elsewhere on the board
/Memory Interface/OA0: U52.4 (Q0); also elsewhere on the board
/Memory Interface/OA1: U52.7 (Q1); also elsewhere on the board
/Memory Interface/OA2: U52.10 (Q2); also elsewhere on the board
/Memory Interface/OA3: U52.14 (Q3); also elsewhere on the board
/Memory Interface/OA4: U52.17 (Q4); also elsewhere on the board
/Memory Interface/OA5: U52.20 (Q5); also elsewhere on the board
/Memory Interface/OA6: U53.4 (Q0); also elsewhere on the board
/Memory Interface/OA7: U53.7 (Q1); also elsewhere on the board
/Memory Interface/OA8: U53.10 (Q2); also elsewhere on the board
/Memory Interface/OA9: U53.14 (Q3); also elsewhere on the board
/Memory Interface/OA10: U53.17 (Q4); also elsewhere on the board
/Memory Interface/OA11: U53.20 (Q5); also elsewhere on the board
/Memory Interface/OA12: U54.4 (Q0); also elsewhere on the board
/Memory Interface/OA13: U54.7 (Q1); also elsewhere on the board
/Memory Interface/OA14: U54.10 (Q2); also elsewhere on the board
/Memory Interface/OA15: U54.14 (Q3); also elsewhere on the board
/Memory Interface/OA16: U54.17 (Q4); also elsewhere on the board
/Memory Interface/OADISP: U52.1 (S0), U53.1 (S0), U54.1 (S0), U55.15 (IO5)
/Memory Interface/OLSEL: U54.19 (IA4); also elsewhere on the board
/Memory Interface/~MCE0: U56.19 (IO1); also elsewhere on the board
/Memory Interface/~MCE1: U56.18 (IO2); also elsewhere on the board
/Memory Interface/~MCE2: U56.17 (I03); also elsewhere on the board
/Memory Interface/~MCE3: U56.16 (IO4); also elsewhere on the board
/Memory Interface/~MCE4: U56.15 (IO5); also elsewhere on the board
/Memory Interface/~MCE5: U56.14 (IO6); also elsewhere on the board
/Memory Interface/~MCE6: U56.13 (IO7); also elsewhere on the board
/Memory Interface/~MCE7: U56.12 (IO8); also elsewhere on the board
/Memory Interface/~MOE0: U57.19 (IO1); also elsewhere on the board
/Memory Interface/~MOE1: U57.18 (IO2); also elsewhere on the board
/Memory Interface/~MOE2: U57.17 (I03); also elsewhere on the board
/Memory Interface/~MOE3: U57.16 (IO4); also elsewhere on the board
/Memory Interface/~MOE4: U57.15 (IO5); also elsewhere on the board
/Memory Interface/~MOE5: U57.14 (IO6); also elsewhere on the board
/Memory Interface/~MOE6: U57.13 (IO7); also elsewhere on the board
/Memory Interface/~MOE7: U57.12 (IO8); also elsewhere on the board
/Memory Interface/~MWE: U55.14 (IO6); also elsewhere on the board
/Memory Interface/~OLCE: U55.19 (IO1); also elsewhere on the board
/Memory Interface/~OLDEN: U55.17 (I03); also elsewhere on the board
/Memory Interface/~OLOE: U55.18 (IO2); also elsewhere on the board
/~AS: U55.11 (I10/~OE); also elsewhere on the board
/~DRAW: U55.8 (I8), U56.8 (I8), U57.8 (I8), U58.8 (I8); also elsewhere on the board
GND: U49.1 (OE), U49.10 (GND), U50.1 (OE), U50.10 (GND), U51.1 (OEa), U51.10 (GND), U51.11 (I0b), U51.13 (I1b), U51.15 (I2b), U51.17 (I3b), U51.19 (OEb), U52.12 (GND), U52.13 (COMP), U52.23 (S1), U53.12 (GND), U53.13 (COMP), U53.23 (S1), U54.12 (GND), U54.13 (COMP), U54.21 (IB5), U54.22 (IA5), U54.23 (S1), U55.10 (GND), U56.10 (GND), U57.10 (GND), U58.10 (GND); also elsewhere on the board

Notes on the sheet:
U55, U56, U57 and U58 GALs should only require combinatorial logic. 2CLK is connected to pin 1 as a backup.

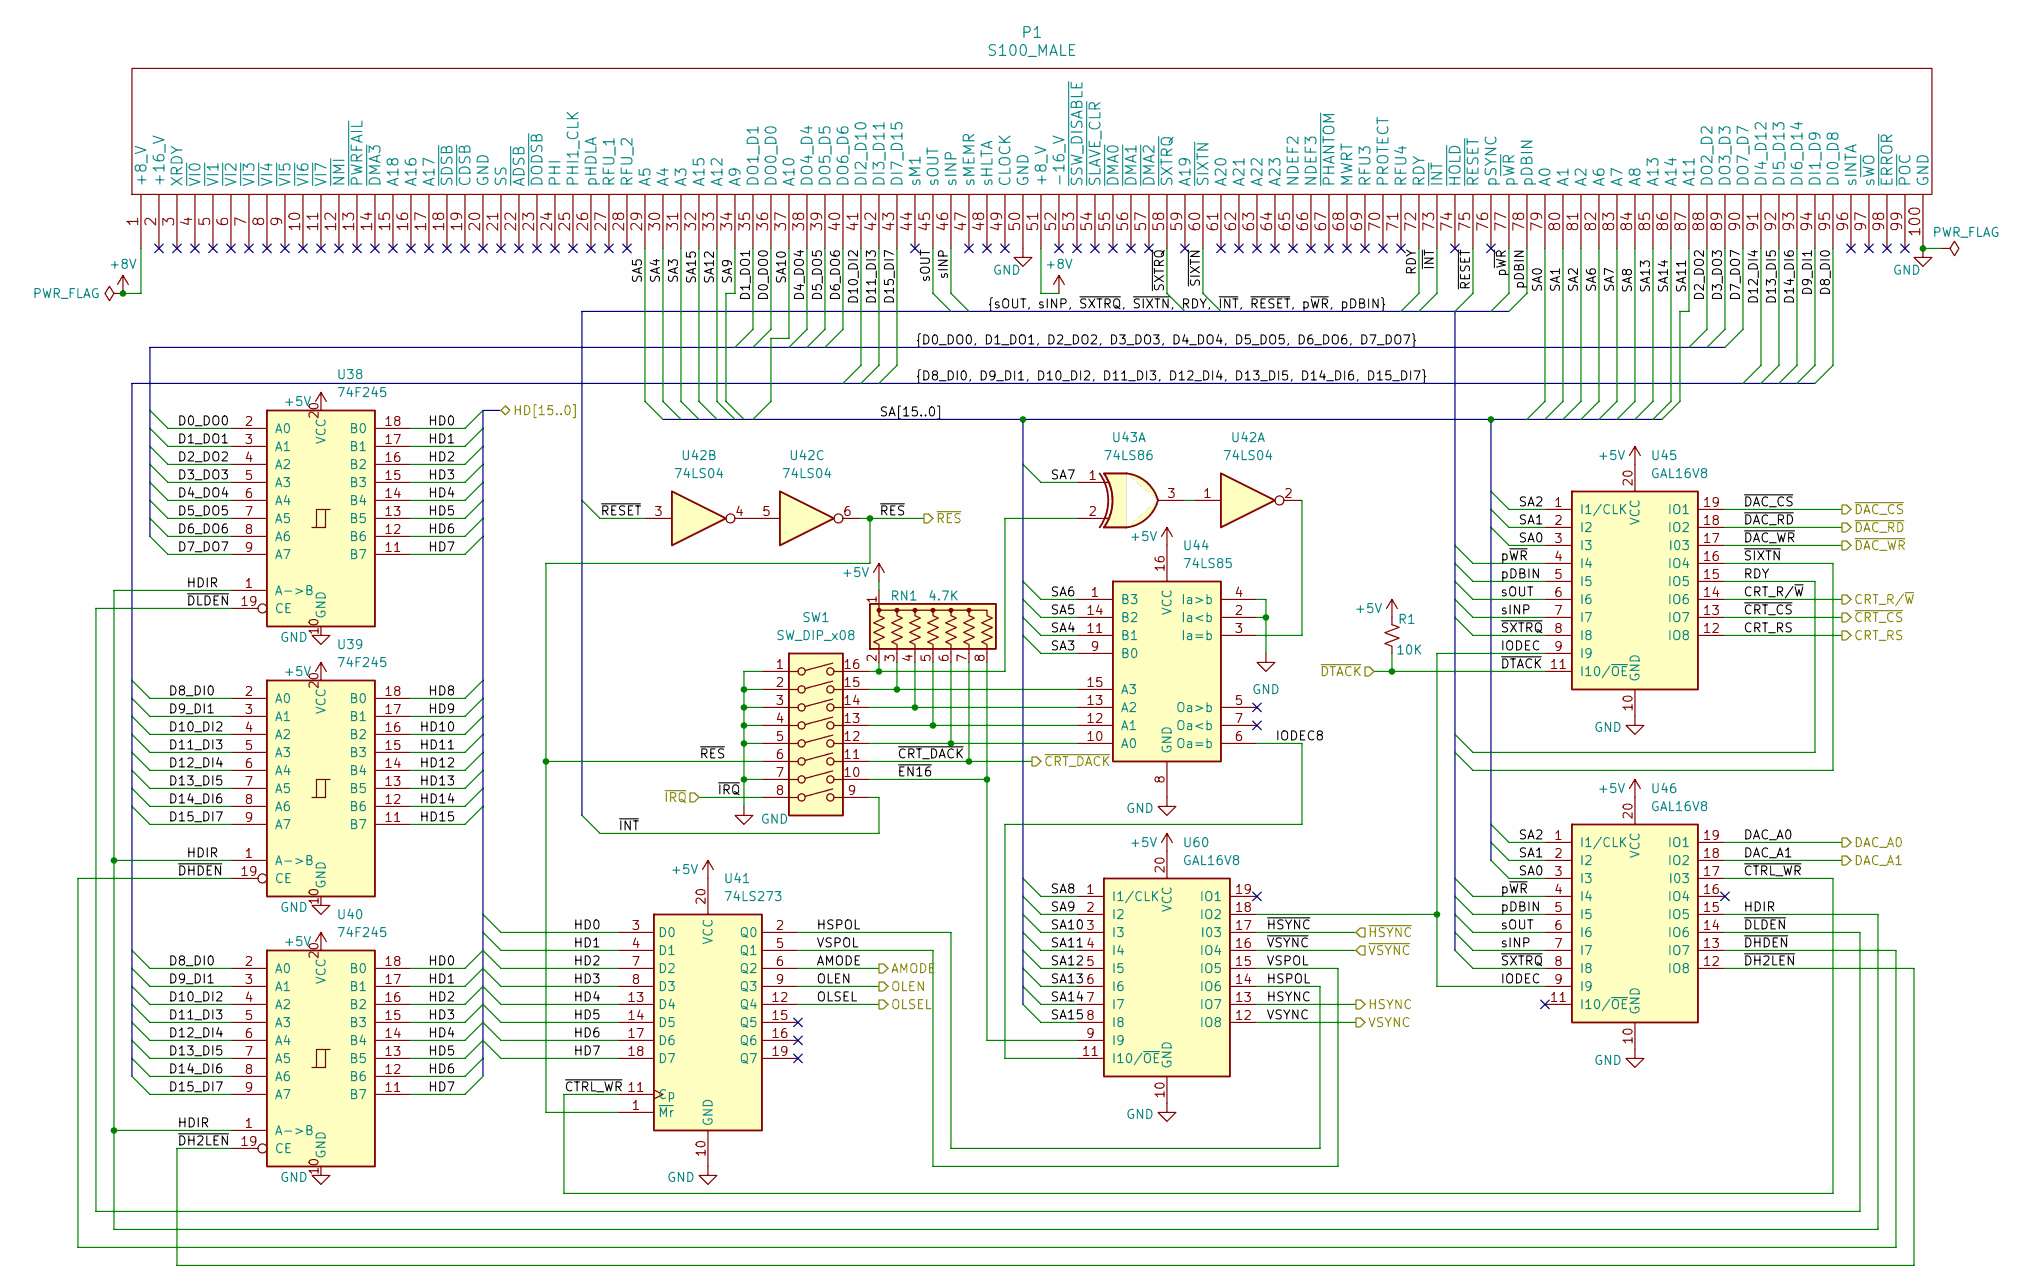
[picture p24: schematic S100 Interface.kicad_sch]

Parts:
P1: S100_MALE
R1: 10K; R_Axial_DIN0204_L3.6mm_D1.6mm_P7.62mm_Horizontal
RN1: 4.7K; R_Array_SIP8
SW1: SW_DIP_x08; DIP-16_W7.62mm_Socket
U38, U39, U40: 74F245; DIP-20_W7.62mm_Socket
U41: 74LS273; DIP-20_W7.62mm_Socket
U42: 74LS04; DIP-14_W7.62mm_Socket
U43: 74LS86; DIP-14_W7.62mm_Socket
U44: 74LS85; DIP-16_W7.62mm_Socket
U45, U46: GAL16V8; DIP-20_W7.62mm_Socket
U60: GAL16V8; DIP-20_W7.62mm_Socket_Small_Pads

Connections:
+5V: R1.1, RN1.1 (common), U38.20 (VCC), U39.20 (VCC), U40.20 (VCC), U41.20 (VCC), U44.16 (VCC), U45.20 (VCC), U46.20 (VCC), U60.20 (VCC); also elsewhere on the board
+8V: P1.1 (+8_V), P1.51 (+8_V); also elsewhere on the board
/Memory Interface/OLSEL: U41.12 (Q4); also elsewhere on the board
/S100 Interface/AMODE: U41.6 (Q2); also elsewhere on the board
/S100 Interface/CRT_RS: U45.12 (IO8); also elsewhere on the board
/S100 Interface/CRT_R/~W: U45.14 (IO6); also elsewhere on the board
/S100 Interface/D0_DO0: P1.36 (DO0_D0), U38.2 (A0)
/S100 Interface/D1_DO1: P1.35 (DO1_D1), U38.3 (A1)
/S100 Interface/D2_DO2: P1.88 (DO2_D2), U38.4 (A2)
/S100 Interface/D3_DO3: P1.89 (DO3_D3), U38.5 (A3)
/S100 Interface/D4_DO4: P1.38 (DO4_D4), U38.6 (A4)
/S100 Interface/D5_DO5: P1.39 (DO5_D5), U38.7 (A5)
/S100 Interface/D6_DO6: P1.40 (DO6_D6), U38.8 (A6)
/S100 Interface/D7_DO7: P1.90 (DO7_D7), U38.9 (A7)
/S100 Interface/D8_DI0: P1.95 (DI0_D8), U39.2 (A0), U40.2 (A0)
/S100 Interface/D9_DI1: P1.94 (DI1_D9), U39.3 (A1), U40.3 (A1)
/S100 Interface/D10_DI2: P1.41 (DI2_D10), U39.4 (A2), U40.4 (A2)
/S100 Interface/D11_DI3: P1.42 (DI3_D11), U39.5 (A3), U40.5 (A3)
/S100 Interface/D12_DI4: P1.91 (DI4_D12), U39.6 (A4), U40.6 (A4)
/S100 Interface/D13_DI5: P1.92 (DI5_D13), U39.7 (A5), U40.7 (A5)
/S100 Interface/D14_DI6: P1.93 (DI6_D14), U39.8 (A6), U40.8 (A6)
/S100 Interface/D15_DI7: P1.43 (DI7_D15), U39.9 (A7), U40.9 (A7)
/S100 Interface/DAC_A0: U46.19 (IO1); also elsewhere on the board
/S100 Interface/DAC_A1: U46.18 (IO2); also elsewhere on the board
/S100 Interface/HD0: U38.18 (B0), U40.18 (B0), U41.3 (D0); also elsewhere on the board
/S100 Interface/HD1: U38.17 (B1), U40.17 (B1), U41.4 (D1); also elsewhere on the board
/S100 Interface/HD2: U38.16 (B2), U40.16 (B2), U41.7 (D2); also elsewhere on the board
/S100 Interface/HD3: U38.15 (B3), U40.15 (B3), U41.8 (D3); also elsewhere on the board
/S100 Interface/HD4: U38.14 (B4), U40.14 (B4), U41.13 (D4); also elsewhere on the board
/S100 Interface/HD5: U38.13 (B5), U40.13 (B5), U41.14 (D5); also elsewhere on the board
/S100 Interface/HD6: U38.12 (B6), U40.12 (B6), U41.17 (D6); also elsewhere on the board
/S100 Interface/HD7: U38.11 (B7), U40.11 (B7), U41.18 (D7); also elsewhere on the board
/S100 Interface/HD8: U39.18 (B0); also elsewhere on the board
/S100 Interface/HD9: U39.17 (B1); also elsewhere on the board
/S100 Interface/HD10: U39.16 (B2); also elsewhere on the board
/S100 Interface/HD11: U39.15 (B3); also elsewhere on the board
/S100 Interface/HD12: U39.14 (B4); also elsewhere on the board
/S100 Interface/HD13: U39.13 (B5); also elsewhere on the board
/S100 Interface/HD14: U39.12 (B6); also elsewhere on the board
/S100 Interface/HD15: U39.11 (B7); also elsewhere on the board
/S100 Interface/HDIR: U38.1 (A->B), U39.1 (A->B), U40.1 (A->B), U46.15 (IO5)
/S100 Interface/HSPOL: U41.2 (Q0), U60.14 (IO6)
/S100 Interface/HSYNC: U60.13 (IO7); also elsewhere on the board
/S100 Interface/IODEC: U45.9 (I9), U46.9 (I9), U60.18 (IO2)
/S100 Interface/IODEC8: U44.6 (Oa=b), U60.11 (I10/~OE)
/S100 Interface/OLEN: U41.9 (Q3); also elsewhere on the board
/S100 Interface/RDY: P1.72 (RDY), U45.15 (IO5)
/S100 Interface/SA0: P1.79 (A0), U45.3 (I3), U46.3 (I3)
/S100 Interface/SA1: P1.80 (A1), U45.2 (I2), U46.2 (I2)
/S100 Interface/SA2: P1.81 (A2), U45.1 (I1/CLK), U46.1 (I1/CLK)
/S100 Interface/SA3: P1.31 (A3), U44.9 (B0)
/S100 Interface/SA4: P1.30 (A4), U44.11 (B1)
/S100 Interface/SA5: P1.29 (A5), U44.14 (B2)
/S100 Interface/SA6: P1.82 (A6), U44.1 (B3)
/S100 Interface/SA7: P1.83 (A7), U43.1
/S100 Interface/SA8: P1.84 (A8), U60.1 (I1/CLK)
/S100 Interface/SA9: P1.34 (A9), U60.2 (I2)
/S100 Interface/SA10: P1.37 (A10), U60.3 (I3)
/S100 Interface/SA11: P1.87 (A11), U60.4 (I4)
/S100 Interface/SA12: P1.33 (A12), U60.5 (I5)
/S100 Interface/SA13: P1.85 (A13), U60.6 (I6)
/S100 Interface/SA14: P1.86 (A14), U60.7 (I7)
/S100 Interface/SA15: P1.32 (A15), U60.8 (I8)
/S100 Interface/VSPOL: U41.5 (Q1), U60.15 (IO5)
/S100 Interface/VSYNC: U60.12 (IO8); also elsewhere on the board
/S100 Interface/pDBIN: P1.78 (pDBIN), U45.5 (I5), U46.5 (I5)
/S100 Interface/p~WR: P1.77 (p~WR), U45.4 (I4), U46.4 (I4)
/S100 Interface/sINP: P1.46 (sINP), U45.7 (I7), U46.7 (I7)
/S100 Interface/sOUT: P1.45 (sOUT), U45.6 (I6), U46.6 (I6)
/S100 Interface/~CRT_CS: U45.13 (IO7); also elsewhere on the board
/S100 Interface/~CRT_DACK: RN1.7 (R6), SW1.11; also elsewhere on the board
/S100 Interface/~CTRL_WR: U41.11 (Cp), U46.17 (I03)
/S100 Interface/~DAC_CS: U45.19 (IO1); also elsewhere on the board
/S100 Interface/~DAC_RD: U45.18 (IO2); also elsewhere on the board
/S100 Interface/~DAC_WR: U45.17 (I03); also elsewhere on the board
/S100 Interface/~DH2LEN: U40.19 (CE), U46.12 (IO8)
/S100 Interface/~DHDEN: U39.19 (CE), U46.13 (IO7)
/S100 Interface/~DLDEN: U38.19 (CE), U46.14 (IO6)
/S100 Interface/~DTACK: R1.2, U45.11 (I10/~OE); also elsewhere on the board
/S100 Interface/~EN16: RN1.8 (R7), SW1.10, U60.9 (I9)
/S100 Interface/~INT: P1.73 (~INT), SW1.9
/S100 Interface/~IRQ: SW1.8; also elsewhere on the board
/S100 Interface/~RESET: P1.75 (~RESET), U42.3
/S100 Interface/~RES: SW1.6, U41.1 (~Mr), U42.6; also elsewhere on the board
/S100 Interface/~SIXTN: P1.60 (~SIXTN), U45.16 (IO4)
/S100 Interface/~SXTRQ: P1.58 (~SXTRQ), U45.8 (I8), U46.8 (I8)
/S100 Interface/~VSYNC: U60.16 (IO4); also elsewhere on the board
/~HSYNC: U60.17 (I03); also elsewhere on the board
GND: P1.50 (GND), P1.100 (GND), SW1.1, SW1.2, SW1.3, SW1.4, SW1.5, SW1.7, U38.10 (GND), U39.10 (GND), U40.10 (GND), U41.10 (GND), U44.2 (Ia<b), U44.4 (Ia>b), U44.8 (GND), U45.10 (GND), U46.10 (GND), U60.10 (GND); also elsewhere on the board
unnamed: RN1.2 (R1), SW1.16, U43.2
unnamed: RN1.3 (R2), SW1.15, U44.15 (A3)
unnamed: RN1.4 (R3), SW1.14, U44.13 (A2)
unnamed: RN1.5 (R4), SW1.13, U44.12 (A1)
unnamed: RN1.6 (R5), SW1.12, U44.10 (A0)
unnamed: U42.1, U43.3
unnamed: U42.4, U42.5
unnamed: U42.2, U44.3 (Ia=b)
