ToddHoug/cadzilla/schematics/cadzilla.kicad_pcb

## KiCad design schematics/cadzilla.kicad_pcb (continued)

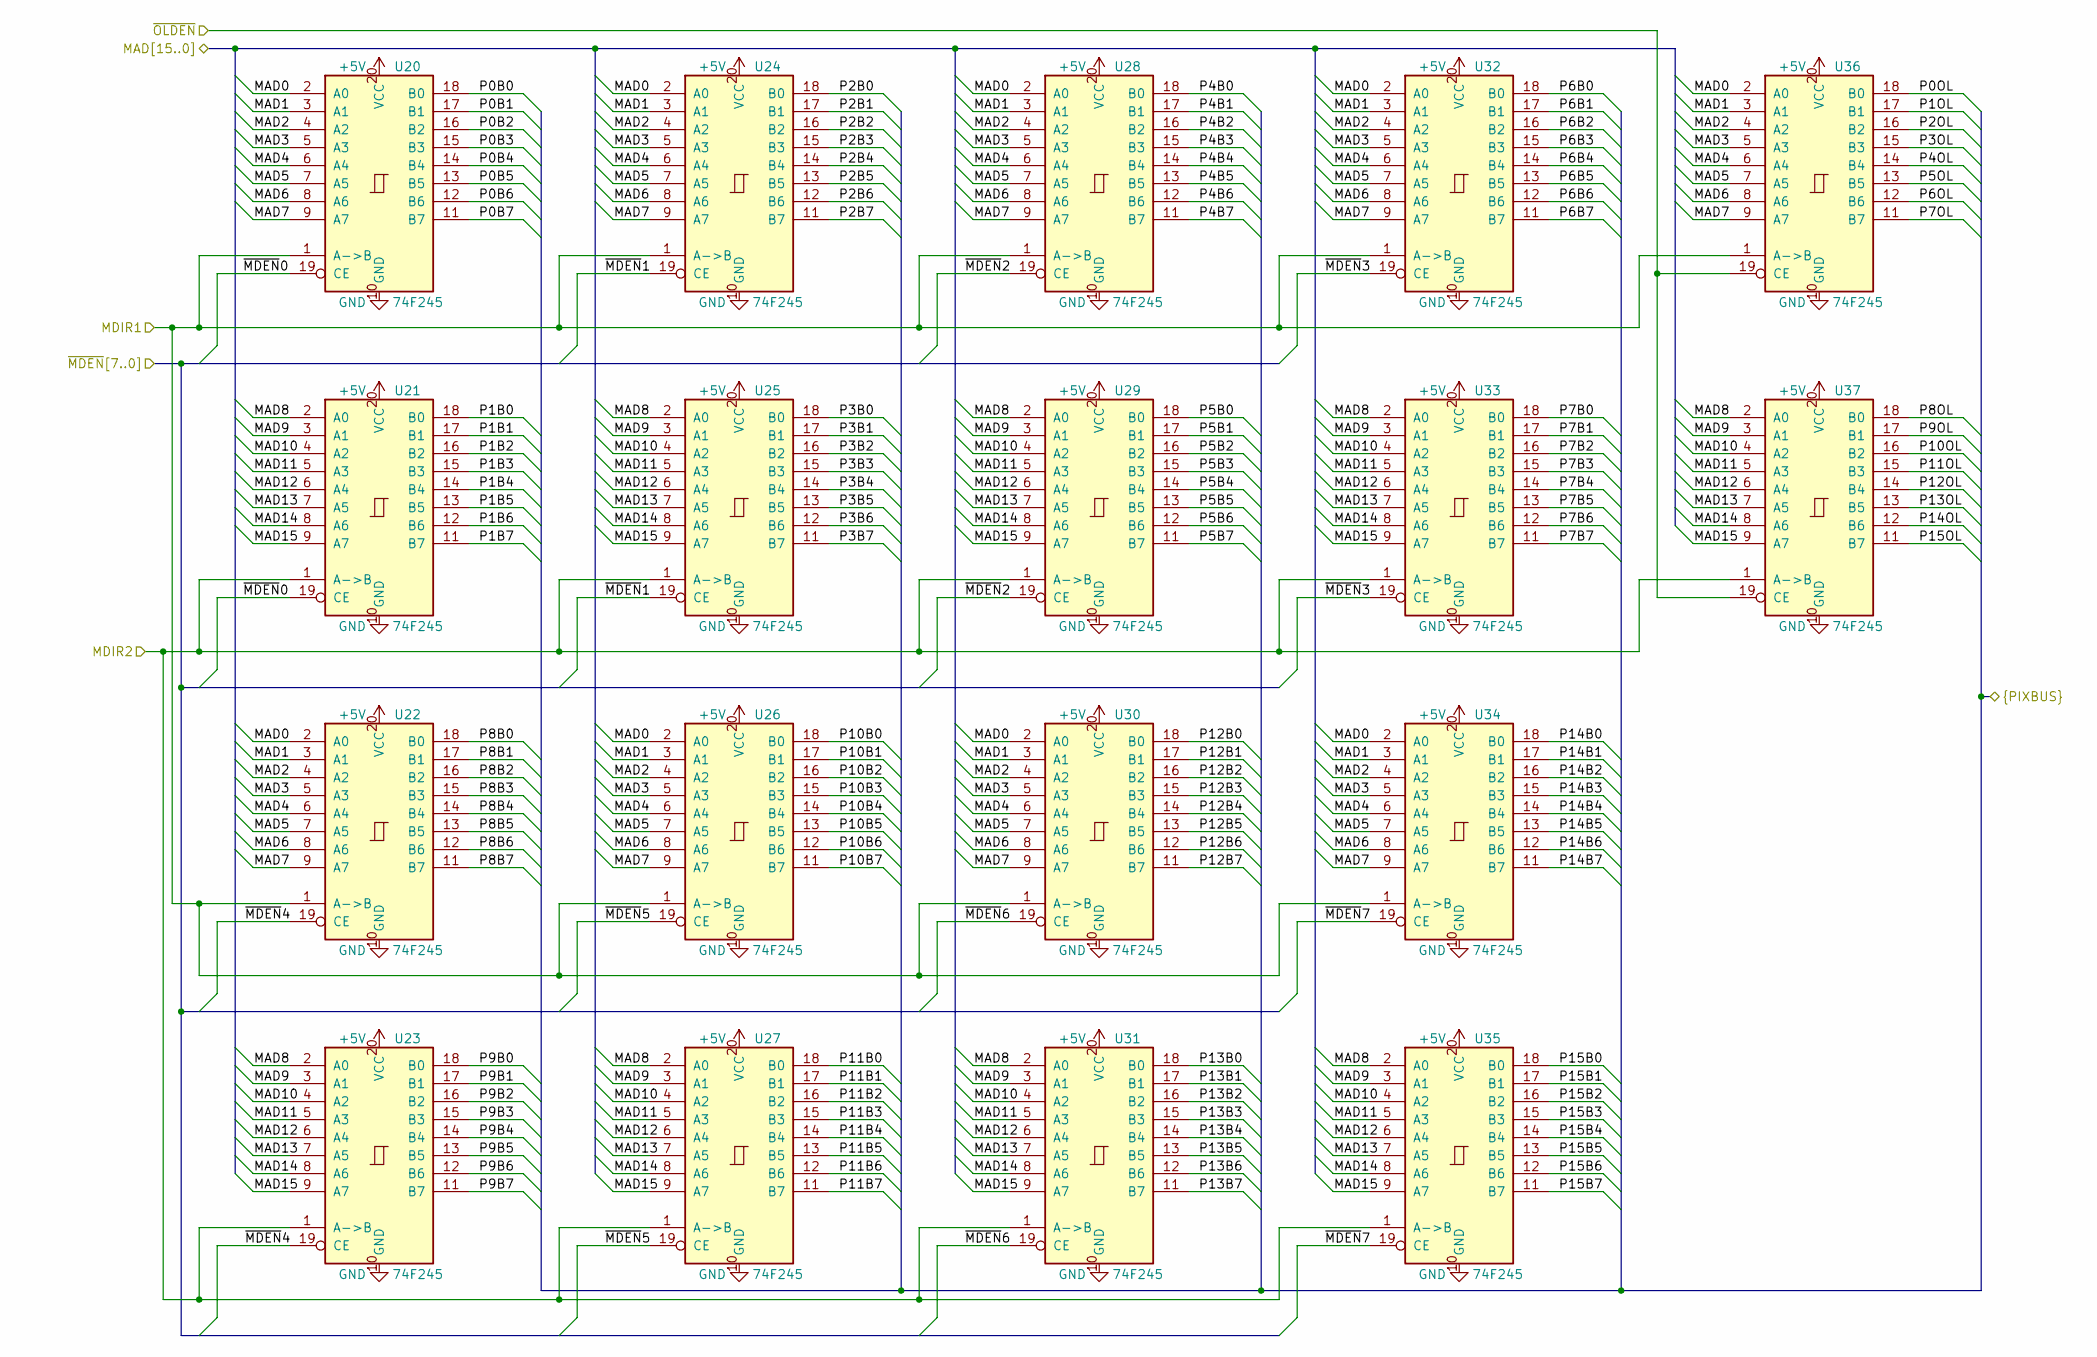
[picture p25: schematic Data BUffers.kicad_sch]

Parts:
U20, U21, U22, U23, U24, U25, U26, U27, U28, U29, U30, U31, U32, U33, U34, U35, U36, U37: 74F245; DIP-20_W7.62mm_Socket

Connections:
+5V: U20.20 (VCC), U21.20 (VCC), U22.20 (VCC), U23.20 (VCC), U24.20 (VCC), U25.20 (VCC), U26.20 (VCC), U27.20 (VCC), U28.20 (VCC), U29.20 (VCC), U30.20 (VCC), U31.20 (VCC), U32.20 (VCC), U33.20 (VCC), U34.20 (VCC), U35.20 (VCC), U36.20 (VCC), U37.20 (VCC); also elsewhere on the board
/Data Buffers/MAD0: U20.2 (A0), U22.2 (A0), U24.2 (A0), U26.2 (A0), U28.2 (A0), U30.2 (A0), U32.2 (A0), U34.2 (A0), U36.2 (A0); also elsewhere on the board
/Data Buffers/MAD1: U20.3 (A1), U22.3 (A1), U24.3 (A1), U26.3 (A1), U28.3 (A1), U30.3 (A1), U32.3 (A1), U34.3 (A1), U36.3 (A1); also elsewhere on the board
/Data Buffers/MAD2: U20.4 (A2), U22.4 (A2), U24.4 (A2), U26.4 (A2), U28.4 (A2), U30.4 (A2), U32.4 (A2), U34.4 (A2), U36.4 (A2); also elsewhere on the board
/Data Buffers/MAD3: U20.5 (A3), U22.5 (A3), U24.5 (A3), U26.5 (A3), U28.5 (A3), U30.5 (A3), U32.5 (A3), U34.5 (A3), U36.5 (A3); also elsewhere on the board
/Data Buffers/MAD4: U20.6 (A4), U22.6 (A4), U24.6 (A4), U26.6 (A4), U28.6 (A4), U30.6 (A4), U32.6 (A4), U34.6 (A4), U36.6 (A4); also elsewhere on the board
/Data Buffers/MAD5: U20.7 (A5), U22.7 (A5), U24.7 (A5), U26.7 (A5), U28.7 (A5), U30.7 (A5), U32.7 (A5), U34.7 (A5), U36.7 (A5); also elsewhere on the board
/Data Buffers/MAD6: U20.8 (A6), U22.8 (A6), U24.8 (A6), U26.8 (A6), U28.8 (A6), U30.8 (A6), U32.8 (A6), U34.8 (A6), U36.8 (A6); also elsewhere on the board
/Data Buffers/MAD7: U20.9 (A7), U22.9 (A7), U24.9 (A7), U26.9 (A7), U28.9 (A7), U30.9 (A7), U32.9 (A7), U34.9 (A7), U36.9 (A7); also elsewhere on the board
/Data Buffers/MAD8: U21.2 (A0), U23.2 (A0), U25.2 (A0), U27.2 (A0), U29.2 (A0), U31.2 (A0), U33.2 (A0), U35.2 (A0), U37.2 (A0); also elsewhere on the board
/Data Buffers/MAD9: U21.3 (A1), U23.3 (A1), U25.3 (A1), U27.3 (A1), U29.3 (A1), U31.3 (A1), U33.3 (A1), U35.3 (A1), U37.3 (A1); also elsewhere on the board
/Data Buffers/MAD10: U21.4 (A2), U23.4 (A2), U25.4 (A2), U27.4 (A2), U29.4 (A2), U31.4 (A2), U33.4 (A2), U35.4 (A2), U37.4 (A2); also elsewhere on the board
/Data Buffers/MAD11: U21.5 (A3), U23.5 (A3), U25.5 (A3), U27.5 (A3), U29.5 (A3), U31.5 (A3), U33.5 (A3), U35.5 (A3), U37.5 (A3); also elsewhere on the board
/Data Buffers/MAD12: U21.6 (A4), U23.6 (A4), U25.6 (A4), U27.6 (A4), U29.6 (A4), U31.6 (A4), U33.6 (A4), U35.6 (A4), U37.6 (A4); also elsewhere on the board
/Data Buffers/MAD13: U21.7 (A5), U23.7 (A5), U25.7 (A5), U27.7 (A5), U29.7 (A5), U31.7 (A5), U33.7 (A5), U35.7 (A5), U37.7 (A5); also elsewhere on the board
/Data Buffers/MAD14: U21.8 (A6), U23.8 (A6), U25.8 (A6), U27.8 (A6), U29.8 (A6), U31.8 (A6), U33.8 (A6), U35.8 (A6), U37.8 (A6); also elsewhere on the board
/Data Buffers/MAD15: U21.9 (A7), U23.9 (A7), U25.9 (A7), U27.9 (A7), U29.9 (A7), U31.9 (A7), U33.9 (A7), U35.9 (A7), U37.9 (A7); also elsewhere on the board
/Data Buffers/P0B0: U20.18 (B0); also elsewhere on the board
/Data Buffers/P0B1: U20.17 (B1); also elsewhere on the board
/Data Buffers/P0B2: U20.16 (B2); also elsewhere on the board
/Data Buffers/P0B3: U20.15 (B3); also elsewhere on the board
/Data Buffers/P0B4: U20.14 (B4); also elsewhere on the board
/Data Buffers/P0B5: U20.13 (B5); also elsewhere on the board
/Data Buffers/P0B6: U20.12 (B6); also elsewhere on the board
/Data Buffers/P0B7: U20.11 (B7); also elsewhere on the board
/Data Buffers/P0OL: U36.18 (B0); also elsewhere on the board
/Data Buffers/P1B0: U21.18 (B0); also elsewhere on the board
/Data Buffers/P1B1: U21.17 (B1); also elsewhere on the board
/Data Buffers/P1B2: U21.16 (B2); also elsewhere on the board
/Data Buffers/P1B3: U21.15 (B3); also elsewhere on the board
/Data Buffers/P1B4: U21.14 (B4); also elsewhere on the board
/Data Buffers/P1B5: U21.13 (B5); also elsewhere on the board
/Data Buffers/P1B6: U21.12 (B6); also elsewhere on the board
/Data Buffers/P1B7: U21.11 (B7); also elsewhere on the board
/Data Buffers/P1OL: U36.17 (B1); also elsewhere on the board
/Data Buffers/P2B0: U24.18 (B0); also elsewhere on the board
/Data Buffers/P2B1: U24.17 (B1); also elsewhere on the board
/Data Buffers/P2B2: U24.16 (B2); also elsewhere on the board
/Data Buffers/P2B3: U24.15 (B3); also elsewhere on the board
/Data Buffers/P2B4: U24.14 (B4); also elsewhere on the board
/Data Buffers/P2B5: U24.13 (B5); also elsewhere on the board
/Data Buffers/P2B6: U24.12 (B6); also elsewhere on the board
/Data Buffers/P2B7: U24.11 (B7); also elsewhere on the board
/Data Buffers/P2OL: U36.16 (B2); also elsewhere on the board
/Data Buffers/P3B0: U25.18 (B0); also elsewhere on the board
/Data Buffers/P3B1: U25.17 (B1); also elsewhere on the board
/Data Buffers/P3B2: U25.16 (B2); also elsewhere on the board
/Data Buffers/P3B3: U25.15 (B3); also elsewhere on the board
/Data Buffers/P3B4: U25.14 (B4); also elsewhere on the board
/Data Buffers/P3B5: U25.13 (B5); also elsewhere on the board
/Data Buffers/P3B6: U25.12 (B6); also elsewhere on the board
/Data Buffers/P3B7: U25.11 (B7); also elsewhere on the board
/Data Buffers/P3OL: U36.15 (B3); also elsewhere on the board
/Data Buffers/P4B0: U28.18 (B0); also elsewhere on the board
/Data Buffers/P4B1: U28.17 (B1); also elsewhere on the board
/Data Buffers/P4B2: U28.16 (B2); also elsewhere on the board
/Data Buffers/P4B3: U28.15 (B3); also elsewhere on the board
/Data Buffers/P4B4: U28.14 (B4); also elsewhere on the board
/Data Buffers/P4B5: U28.13 (B5); also elsewhere on the board
/Data Buffers/P4B6: U28.12 (B6); also elsewhere on the board
/Data Buffers/P4B7: U28.11 (B7); also elsewhere on the board
/Data Buffers/P4OL: U36.14 (B4); also elsewhere on the board
/Data Buffers/P5B0: U29.18 (B0); also elsewhere on the board
/Data Buffers/P5B1: U29.17 (B1); also elsewhere on the board
/Data Buffers/P5B2: U29.16 (B2); also elsewhere on the board
/Data Buffers/P5B3: U29.15 (B3); also elsewhere on the board
/Data Buffers/P5B4: U29.14 (B4); also elsewhere on the board
/Data Buffers/P5B5: U29.13 (B5); also elsewhere on the board
/Data Buffers/P5B6: U29.12 (B6); also elsewhere on the board
/Data Buffers/P5B7: U29.11 (B7); also elsewhere on the board
/Data Buffers/P5OL: U36.13 (B5); also elsewhere on the board
/Data Buffers/P6B0: U32.18 (B0); also elsewhere on the board
/Data Buffers/P6B1: U32.17 (B1); also elsewhere on the board
/Data Buffers/P6B2: U32.16 (B2); also elsewhere on the board
/Data Buffers/P6B3: U32.15 (B3); also elsewhere on the board
/Data Buffers/P6B4: U32.14 (B4); also elsewhere on the board
/Data Buffers/P6B5: U32.13 (B5); also elsewhere on the board
/Data Buffers/P6B6: U32.12 (B6); also elsewhere on the board
/Data Buffers/P6B7: U32.11 (B7); also elsewhere on the board
/Data Buffers/P6OL: U36.12 (B6); also elsewhere on the board
/Data Buffers/P7B0: U33.18 (B0); also elsewhere on the board
/Data Buffers/P7B1: U33.17 (B1); also elsewhere on the board
/Data Buffers/P7B2: U33.16 (B2); also elsewhere on the board
/Data Buffers/P7B3: U33.15 (B3); also elsewhere on the board
/Data Buffers/P7B4: U33.14 (B4); also elsewhere on the board
/Data Buffers/P7B5: U33.13 (B5); also elsewhere on the board
/Data Buffers/P7B6: U33.12 (B6); also elsewhere on the board
/Data Buffers/P7B7: U33.11 (B7); also elsewhere on the board
/Data Buffers/P7OL: U36.11 (B7); also elsewhere on the board
/Data Buffers/P8B0: U22.18 (B0); also elsewhere on the board
/Data Buffers/P8B1: U22.17 (B1); also elsewhere on the board
/Data Buffers/P8B2: U22.16 (B2); also elsewhere on the board
/Data Buffers/P8B3: U22.15 (B3); also elsewhere on the board
/Data Buffers/P8B4: U22.14 (B4); also elsewhere on the board
/Data Buffers/P8B5: U22.13 (B5); also elsewhere on the board
/Data Buffers/P8B6: U22.12 (B6); also elsewhere on the board
/Data Buffers/P8B7: U22.11 (B7); also elsewhere on the board
/Data Buffers/P8OL: U37.18 (B0); also elsewhere on the board
/Data Buffers/P9B0: U23.18 (B0); also elsewhere on the board
/Data Buffers/P9B1: U23.17 (B1); also elsewhere on the board
/Data Buffers/P9B2: U23.16 (B2); also elsewhere on the board
/Data Buffers/P9B3: U23.15 (B3); also elsewhere on the board
/Data Buffers/P9B4: U23.14 (B4); also elsewhere on the board
/Data Buffers/P9B5: U23.13 (B5); also elsewhere on the board
/Data Buffers/P9B6: U23.12 (B6); also elsewhere on the board
/Data Buffers/P9B7: U23.11 (B7); also elsewhere on the board
/Data Buffers/P9OL: U37.17 (B1); also elsewhere on the board
/Data Buffers/P10B0: U26.18 (B0); also elsewhere on the board
/Data Buffers/P10B1: U26.17 (B1); also elsewhere on the board
/Data Buffers/P10B2: U26.16 (B2); also elsewhere on the board
/Data Buffers/P10B3: U26.15 (B3); also elsewhere on the board
/Data Buffers/P10B4: U26.14 (B4); also elsewhere on the board
/Data Buffers/P10B5: U26.13 (B5); also elsewhere on the board
/Data Buffers/P10B6: U26.12 (B6); also elsewhere on the board
/Data Buffers/P10B7: U26.11 (B7); also elsewhere on the board
/Data Buffers/P10OL: U37.16 (B2); also elsewhere on the board
/Data Buffers/P11B0: U27.18 (B0); also elsewhere on the board
/Data Buffers/P11B1: U27.17 (B1); also elsewhere on the board
/Data Buffers/P11B2: U27.16 (B2); also elsewhere on the board
/Data Buffers/P11B3: U27.15 (B3); also elsewhere on the board
/Data Buffers/P11B4: U27.14 (B4); also elsewhere on the board
/Data Buffers/P11B5: U27.13 (B5); also elsewhere on the board
/Data Buffers/P11B6: U27.12 (B6); also elsewhere on the board
/Data Buffers/P11B7: U27.11 (B7); also elsewhere on the board
/Data Buffers/P11OL: U37.15 (B3); also elsewhere on the board
/Data Buffers/P12B0: U30.18 (B0); also elsewhere on the board
/Data Buffers/P12B1: U30.17 (B1); also elsewhere on the board
/Data Buffers/P12B2: U30.16 (B2); also elsewhere on the board
/Data Buffers/P12B3: U30.15 (B3); also elsewhere on the board
/Data Buffers/P12B4: U30.14 (B4); also elsewhere on the board
/Data Buffers/P12B5: U30.13 (B5); also elsewhere on the board
/Data Buffers/P12B6: U30.12 (B6); also elsewhere on the board
/Data Buffers/P12B7: U30.11 (B7); also elsewhere on the board
/Data Buffers/P12OL: U37.14 (B4); also elsewhere on the board
/Data Buffers/P13B0: U31.18 (B0); also elsewhere on the board
/Data Buffers/P13B1: U31.17 (B1); also elsewhere on the board
/Data Buffers/P13B2: U31.16 (B2); also elsewhere on the board
/Data Buffers/P13B3: U31.15 (B3); also elsewhere on the board
/Data Buffers/P13B4: U31.14 (B4); also elsewhere on the board
/Data Buffers/P13B5: U31.13 (B5); also elsewhere on the board
/Data Buffers/P13B6: U31.12 (B6); also elsewhere on the board
/Data Buffers/P13B7: U31.11 (B7); also elsewhere on the board
/Data Buffers/P13OL: U37.13 (B5); also elsewhere on the board
/Data Buffers/P14B0: U34.18 (B0); also elsewhere on the board
/Data Buffers/P14B1: U34.17 (B1); also elsewhere on the board
/Data Buffers/P14B2: U34.16 (B2); also elsewhere on the board
/Data Buffers/P14B3: U34.15 (B3); also elsewhere on the board
/Data Buffers/P14B4: U34.14 (B4); also elsewhere on the board
/Data Buffers/P14B5: U34.13 (B5); also elsewhere on the board
/Data Buffers/P14B6: U34.12 (B6); also elsewhere on the board
/Data Buffers/P14B7: U34.11 (B7); also elsewhere on the board
/Data Buffers/P14OL: U37.12 (B6); also elsewhere on the board
/Data Buffers/P15B0: U35.18 (B0); also elsewhere on the board
/Data Buffers/P15B1: U35.17 (B1); also elsewhere on the board
/Data Buffers/P15B2: U35.16 (B2); also elsewhere on the board
/Data Buffers/P15B3: U35.15 (B3); also elsewhere on the board
/Data Buffers/P15B4: U35.14 (B4); also elsewhere on the board
/Data Buffers/P15B5: U35.13 (B5); also elsewhere on the board
/Data Buffers/P15B6: U35.12 (B6); also elsewhere on the board
/Data Buffers/P15B7: U35.11 (B7); also elsewhere on the board
/Data Buffers/P15OL: U37.11 (B7); also elsewhere on the board
/Data Buffers/~MDEN0: U20.19 (CE), U21.19 (CE); also elsewhere on the board
/Data Buffers/~MDEN1: U24.19 (CE), U25.19 (CE); also elsewhere on the board
/Data Buffers/~MDEN2: U28.19 (CE), U29.19 (CE); also elsewhere on the board
/Data Buffers/~MDEN3: U32.19 (CE), U33.19 (CE); also elsewhere on the board
/Data Buffers/~MDEN4: U22.19 (CE), U23.19 (CE); also elsewhere on the board
/Data Buffers/~MDEN5: U26.19 (CE), U27.19 (CE); also elsewhere on the board
/Data Buffers/~MDEN6: U30.19 (CE), U31.19 (CE); also elsewhere on the board
/Data Buffers/~MDEN7: U34.19 (CE), U35.19 (CE); also elsewhere on the board
/Memory Interface/MDIR1: U20.1 (A->B), U22.1 (A->B), U24.1 (A->B), U26.1 (A->B), U28.1 (A->B), U30.1 (A->B), U32.1 (A->B), U34.1 (A->B), U36.1 (A->B); also elsewhere on the board
/Memory Interface/MDIR2: U21.1 (A->B), U23.1 (A->B), U25.1 (A->B), U27.1 (A->B), U29.1 (A->B), U31.1 (A->B), U33.1 (A->B), U35.1 (A->B), U37.1 (A->B); also elsewhere on the board
/Memory Interface/~OLDEN: U36.19 (CE), U37.19 (CE); also elsewhere on the board
GND: U20.10 (GND), U21.10 (GND), U22.10 (GND), U23.10 (GND), U24.10 (GND), U25.10 (GND), U26.10 (GND), U27.10 (GND), U28.10 (GND), U29.10 (GND), U30.10 (GND), U31.10 (GND), U32.10 (GND), U33.10 (GND), U34.10 (GND), U35.10 (GND), U36.10 (GND), U37.10 (GND); also elsewhere on the board

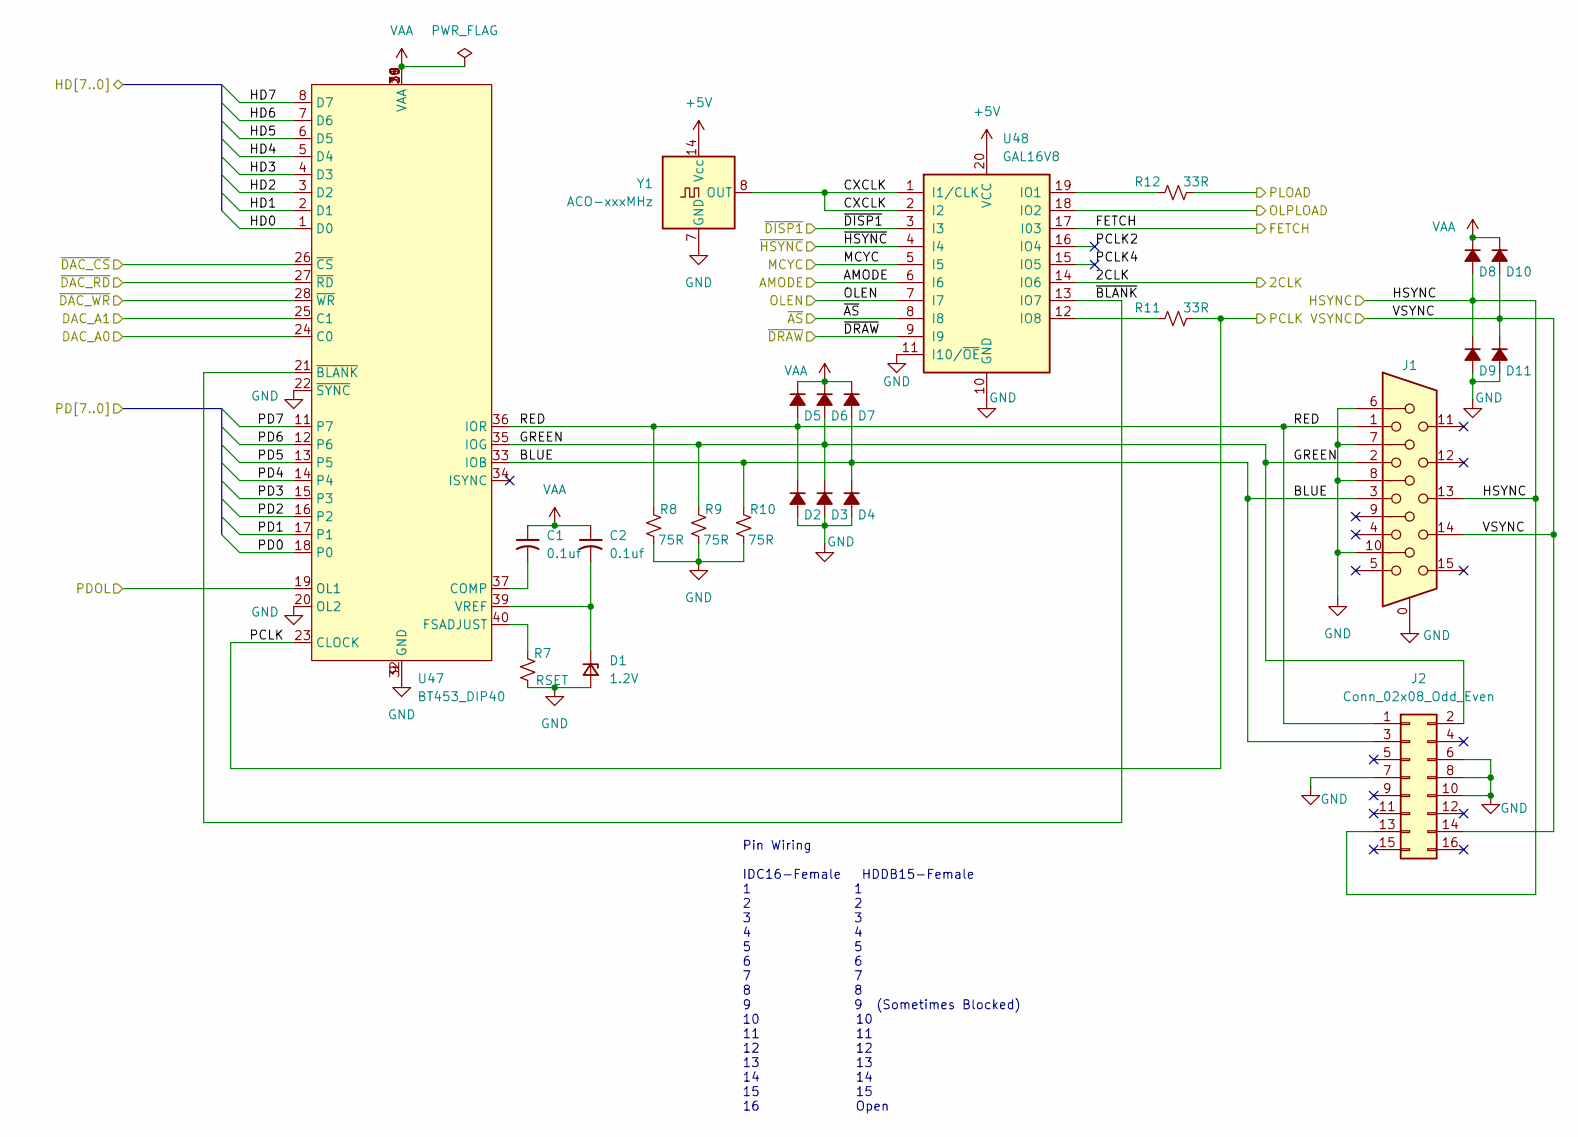
[picture p26: schematic Video Out.kicad_sch]

Parts:
C1, C2: 0.1uf; C_Rect_L9.1mm_W2.5mm_P7.62mm_MKT
D1: 1.2V; D_A-405_P7.62mm_Horizontal
D2, D3, D4, D5, D6, D7, D8, D9, D10, D11: 1N4148; D_0805_2012Metric_Pad1.15x1.40mm_HandSolder
J1: DE15_Socket_HighDensity; DSUB-15-HD_Socket_Horizontal_P2.29x1.90mm_EdgePinOffset3.03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
J2: Conn_02x08_Odd_Even; PinHeader_2x08_P2.54mm_Vertical
R7: RSET; R_Axial_DIN0204_L3.6mm_D1.6mm_P7.62mm_Horizontal
R8, R9, R10: 75R; R_Axial_DIN0204_L3.6mm_D1.6mm_P7.62mm_Horizontal
R11, R12: 33R; R_Axial_DIN0204_L3.6mm_D1.6mm_P7.62mm_Horizontal
U47: BT453_DIP40; DIP-40_W15.24mm_Socket
U48: GAL16V8; DIP-20_W7.62mm_Socket
Y1: ACO-xxxMHz; Oscillator_DIP-14

Connections:
+5V: U48.20 (VCC), Y1.14 (Vcc); also elsewhere on the board
/2CLK: U48.14 (IO6); also elsewhere on the board
/MCYC: U48.5 (I5); also elsewhere on the board
/Memory Interface/FETCH: U48.17 (I03); also elsewhere on the board
/S100 Interface/AMODE: U48.6 (I6); also elsewhere on the board
/S100 Interface/DAC_A0: U47.24 (C0); also elsewhere on the board
/S100 Interface/DAC_A1: U47.25 (C1); also elsewhere on the board
/S100 Interface/HD0: U47.1 (D0); also elsewhere on the board
/S100 Interface/HD1: U47.2 (D1); also elsewhere on the board
/S100 Interface/HD2: U47.3 (D2); also elsewhere on the board
/S100 Interface/HD3: U47.4 (D3); also elsewhere on the board
/S100 Interface/HD4: U47.5 (D4); also elsewhere on the board
/S100 Interface/HD5: U47.6 (D5); also elsewhere on the board
/S100 Interface/HD6: U47.7 (D6); also elsewhere on the board
/S100 Interface/HD7: U47.8 (D7); also elsewhere on the board
/S100 Interface/HSYNC: D8.2 (A), D9.1 (K), J1.13, J2.13; also elsewhere on the board
/S100 Interface/OLEN: U48.7 (I7); also elsewhere on the board
/S100 Interface/VSYNC: D10.2 (A), D11.1 (K), J1.14, J2.14; also elsewhere on the board
/S100 Interface/~DAC_CS: U47.26 (~CS); also elsewhere on the board
/S100 Interface/~DAC_RD: U47.27 (~RD); also elsewhere on the board
/S100 Interface/~DAC_WR: U47.28 (~WR); also elsewhere on the board
/Shift Registers/OLPLOAD: U48.18 (IO2); also elsewhere on the board
/Shift Registers/PCLK: R11.2, U47.23 (CLOCK); also elsewhere on the board
/Shift Registers/PD0: U47.18 (P0); also elsewhere on the board
/Shift Registers/PD1: U47.17 (P1); also elsewhere on the board
/Shift Registers/PD2: U47.16 (P2); also elsewhere on the board
/Shift Registers/PD3: U47.15 (P3); also elsewhere on the board
/Shift Registers/PD4: U47.14 (P4); also elsewhere on the board
/Shift Registers/PD5: U47.13 (P5); also elsewhere on the board
/Shift Registers/PD6: U47.12 (P6); also elsewhere on the board
/Shift Registers/PD7: U47.11 (P7); also elsewhere on the board
/Shift Registers/PDOL: U47.19 (OL1); also elsewhere on the board
/Shift Registers/PLOAD: R12.2; also elsewhere on the board
/Video Out/BLUE: D4.1 (K), D7.2 (A), J1.3, J2.3, R10.1, U47.33 (IOB)
/Video Out/CXCLK: U48.1 (I1/CLK), U48.2 (I2), Y1.8 (OUT)
/Video Out/GREEN: D3.1 (K), D6.2 (A), J1.2, J2.2, R9.1, U47.35 (IOG)
/Video Out/PCLK2: U48.16 (IO4)
/Video Out/PCLK4: U48.15 (IO5)
/Video Out/RED: D2.1 (K), D5.2 (A), J1.1, J2.1, R8.1, U47.36 (IOR)
/Video Out/~BLANK: U47.21 (~BLANK), U48.13 (IO7)
/Video Out/~DISP1: U48.3 (I3); also elsewhere on the board
/~AS: U48.8 (I8); also elsewhere on the board
/~DRAW: U48.9 (I9); also elsewhere on the board
/~HSYNC: U48.4 (I4); also elsewhere on the board
GND: D1.2 (A), D2.2 (A), D3.2 (A), D4.2 (A), D9.2 (A), D11.2 (A), J1.0, J1.6, J1.7, J1.8, J1.10, J2.6, J2.7, J2.8, J2.10, R7.2, R8.2, R9.2, R10.2, U47.9 (GND), U47.20 (OL2), U47.22 (~SYNC), U47.32 (GND), U48.10 (GND), U48.11 (I10/~OE), Y1.7 (GND); also elsewhere on the board
unnamed: C2.2, D1.1 (K), U47.39 (VREF)
unnamed: C1.2, U47.37 (COMP)
unnamed: R7.1, U47.40 (FSADJUST)
unnamed: R12.1, U48.19 (IO1)
unnamed: R11.1, U48.12 (IO8)
VAA: C1.1, C2.1, D5.1 (K), D6.1 (K), D7.1 (K), D8.1 (K), D10.1 (K), U47.10 (VAA), U47.29 (VAA), U47.30 (VAA), U47.31 (VAA), U47.38 (VAA); also elsewhere on the board

Notes on the sheet:
Pin Wiring IDC16-Female HDDB15-Female 1 1 2 2 3 3 4 4 5 5 6 6 7 7 8 8 9 9 (Sometimes Blocked) 10 10 11 11 12 12 13 13 14 14 15 15 16 Open
