ToddHoug/cadzilla/schematics/cadzilla.kicad_pcb

## KiCad design schematics/cadzilla.kicad_pcb (continued)

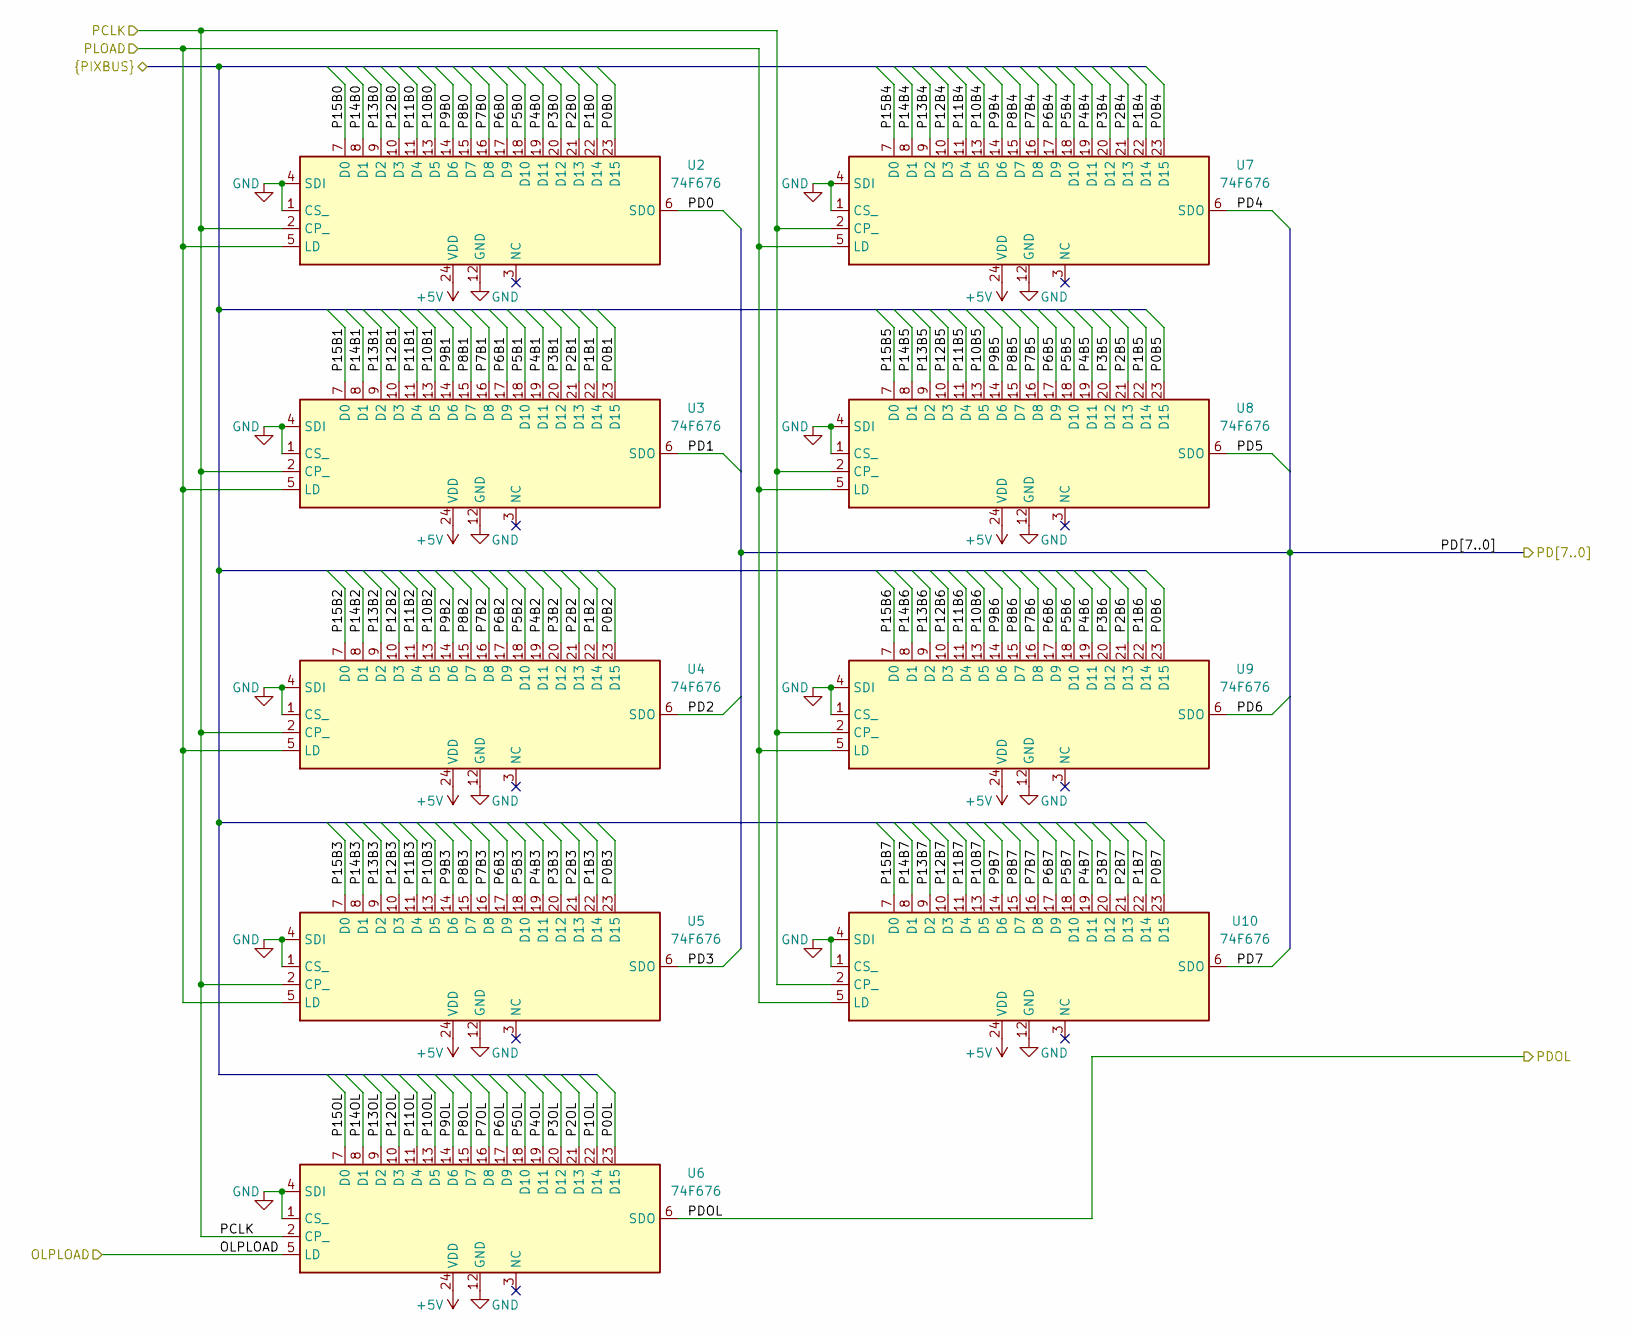
[picture p27: schematic Shifters.kicad_sch]

Parts:
U2, U3, U4, U5, U6, U7, U8, U9, U10: 74F676; DIP-24_W7.62mm_Socket_Small_Pads

Connections:
+5V: U2.24 (VDD), U3.24 (VDD), U4.24 (VDD), U5.24 (VDD), U6.24 (VDD), U7.24 (VDD), U8.24 (VDD), U9.24 (VDD), U10.24 (VDD); also elsewhere on the board
/Data Buffers/P0B0: U2.23 (D15); also elsewhere on the board
/Data Buffers/P0B1: U3.23 (D15); also elsewhere on the board
/Data Buffers/P0B2: U4.23 (D15); also elsewhere on the board
/Data Buffers/P0B3: U5.23 (D15); also elsewhere on the board
/Data Buffers/P0B4: U7.23 (D15); also elsewhere on the board
/Data Buffers/P0B5: U8.23 (D15); also elsewhere on the board
/Data Buffers/P0B6: U9.23 (D15); also elsewhere on the board
/Data Buffers/P0B7: U10.23 (D15); also elsewhere on the board
/Data Buffers/P0OL: U6.23 (D15); also elsewhere on the board
/Data Buffers/P1B0: U2.22 (D14); also elsewhere on the board
/Data Buffers/P1B1: U3.22 (D14); also elsewhere on the board
/Data Buffers/P1B2: U4.22 (D14); also elsewhere on the board
/Data Buffers/P1B3: U5.22 (D14); also elsewhere on the board
/Data Buffers/P1B4: U7.22 (D14); also elsewhere on the board
/Data Buffers/P1B5: U8.22 (D14); also elsewhere on the board
/Data Buffers/P1B6: U9.22 (D14); also elsewhere on the board
/Data Buffers/P1B7: U10.22 (D14); also elsewhere on the board
/Data Buffers/P1OL: U6.22 (D14); also elsewhere on the board
/Data Buffers/P2B0: U2.21 (D13); also elsewhere on the board
/Data Buffers/P2B1: U3.21 (D13); also elsewhere on the board
/Data Buffers/P2B2: U4.21 (D13); also elsewhere on the board
/Data Buffers/P2B3: U5.21 (D13); also elsewhere on the board
/Data Buffers/P2B4: U7.21 (D13); also elsewhere on the board
/Data Buffers/P2B5: U8.21 (D13); also elsewhere on the board
/Data Buffers/P2B6: U9.21 (D13); also elsewhere on the board
/Data Buffers/P2B7: U10.21 (D13); also elsewhere on the board
/Data Buffers/P2OL: U6.21 (D13); also elsewhere on the board
/Data Buffers/P3B0: U2.20 (D12); also elsewhere on the board
/Data Buffers/P3B1: U3.20 (D12); also elsewhere on the board
/Data Buffers/P3B2: U4.20 (D12); also elsewhere on the board
/Data Buffers/P3B3: U5.20 (D12); also elsewhere on the board
/Data Buffers/P3B4: U7.20 (D12); also elsewhere on the board
/Data Buffers/P3B5: U8.20 (D12); also elsewhere on the board
/Data Buffers/P3B6: U9.20 (D12); also elsewhere on the board
/Data Buffers/P3B7: U10.20 (D12); also elsewhere on the board
/Data Buffers/P3OL: U6.20 (D12); also elsewhere on the board
/Data Buffers/P4B0: U2.19 (D11); also elsewhere on the board
/Data Buffers/P4B1: U3.19 (D11); also elsewhere on the board
/Data Buffers/P4B2: U4.19 (D11); also elsewhere on the board
/Data Buffers/P4B3: U5.19 (D11); also elsewhere on the board
/Data Buffers/P4B4: U7.19 (D11); also elsewhere on the board
/Data Buffers/P4B5: U8.19 (D11); also elsewhere on the board
/Data Buffers/P4B6: U9.19 (D11); also elsewhere on the board
/Data Buffers/P4B7: U10.19 (D11); also elsewhere on the board
/Data Buffers/P4OL: U6.19 (D11); also elsewhere on the board
/Data Buffers/P5B0: U2.18 (D10); also elsewhere on the board
/Data Buffers/P5B1: U3.18 (D10); also elsewhere on the board
/Data Buffers/P5B2: U4.18 (D10); also elsewhere on the board
/Data Buffers/P5B3: U5.18 (D10); also elsewhere on the board
/Data Buffers/P5B4: U7.18 (D10); also elsewhere on the board
/Data Buffers/P5B5: U8.18 (D10); also elsewhere on the board
/Data Buffers/P5B6: U9.18 (D10); also elsewhere on the board
/Data Buffers/P5B7: U10.18 (D10); also elsewhere on the board
/Data Buffers/P5OL: U6.18 (D10); also elsewhere on the board
/Data Buffers/P6B0: U2.17 (D9); also elsewhere on the board
/Data Buffers/P6B1: U3.17 (D9); also elsewhere on the board
/Data Buffers/P6B2: U4.17 (D9); also elsewhere on the board
/Data Buffers/P6B3: U5.17 (D9); also elsewhere on the board
/Data Buffers/P6B4: U7.17 (D9); also elsewhere on the board
/Data Buffers/P6B5: U8.17 (D9); also elsewhere on the board
/Data Buffers/P6B6: U9.17 (D9); also elsewhere on the board
/Data Buffers/P6B7: U10.17 (D9); also elsewhere on the board
/Data Buffers/P6OL: U6.17 (D9); also elsewhere on the board
/Data Buffers/P7B0: U2.16 (D8); also elsewhere on the board
/Data Buffers/P7B1: U3.16 (D8); also elsewhere on the board
/Data Buffers/P7B2: U4.16 (D8); also elsewhere on the board
/Data Buffers/P7B3: U5.16 (D8); also elsewhere on the board
/Data Buffers/P7B4: U7.16 (D8); also elsewhere on the board
/Data Buffers/P7B5: U8.16 (D8); also elsewhere on the board
/Data Buffers/P7B6: U9.16 (D8); also elsewhere on the board
/Data Buffers/P7B7: U10.16 (D8); also elsewhere on the board
/Data Buffers/P7OL: U6.16 (D8); also elsewhere on the board
/Data Buffers/P8B0: U2.15 (D7); also elsewhere on the board
/Data Buffers/P8B1: U3.15 (D7); also elsewhere on the board
/Data Buffers/P8B2: U4.15 (D7); also elsewhere on the board
/Data Buffers/P8B3: U5.15 (D7); also elsewhere on the board
/Data Buffers/P8B4: U7.15 (D7); also elsewhere on the board
/Data Buffers/P8B5: U8.15 (D7); also elsewhere on the board
/Data Buffers/P8B6: U9.15 (D7); also elsewhere on the board
/Data Buffers/P8B7: U10.15 (D7); also elsewhere on the board
/Data Buffers/P8OL: U6.15 (D7); also elsewhere on the board
/Data Buffers/P9B0: U2.14 (D6); also elsewhere on the board
/Data Buffers/P9B1: U3.14 (D6); also elsewhere on the board
/Data Buffers/P9B2: U4.14 (D6); also elsewhere on the board
/Data Buffers/P9B3: U5.14 (D6); also elsewhere on the board
/Data Buffers/P9B4: U7.14 (D6); also elsewhere on the board
/Data Buffers/P9B5: U8.14 (D6); also elsewhere on the board
/Data Buffers/P9B6: U9.14 (D6); also elsewhere on the board
/Data Buffers/P9B7: U10.14 (D6); also elsewhere on the board
/Data Buffers/P9OL: U6.14 (D6); also elsewhere on the board
/Data Buffers/P10B0: U2.13 (D5); also elsewhere on the board
/Data Buffers/P10B1: U3.13 (D5); also elsewhere on the board
/Data Buffers/P10B2: U4.13 (D5); also elsewhere on the board
/Data Buffers/P10B3: U5.13 (D5); also elsewhere on the board
/Data Buffers/P10B4: U7.13 (D5); also elsewhere on the board
/Data Buffers/P10B5: U8.13 (D5); also elsewhere on the board
/Data Buffers/P10B6: U9.13 (D5); also elsewhere on the board
/Data Buffers/P10B7: U10.13 (D5); also elsewhere on the board
/Data Buffers/P10OL: U6.13 (D5); also elsewhere on the board
/Data Buffers/P11B0: U2.11 (D4); also elsewhere on the board
/Data Buffers/P11B1: U3.11 (D4); also elsewhere on the board
/Data Buffers/P11B2: U4.11 (D4); also elsewhere on the board
/Data Buffers/P11B3: U5.11 (D4); also elsewhere on the board
/Data Buffers/P11B4: U7.11 (D4); also elsewhere on the board
/Data Buffers/P11B5: U8.11 (D4); also elsewhere on the board
/Data Buffers/P11B6: U9.11 (D4); also elsewhere on the board
/Data Buffers/P11B7: U10.11 (D4); also elsewhere on the board
/Data Buffers/P11OL: U6.11 (D4); also elsewhere on the board
/Data Buffers/P12B0: U2.10 (D3); also elsewhere on the board
/Data Buffers/P12B1: U3.10 (D3); also elsewhere on the board
/Data Buffers/P12B2: U4.10 (D3); also elsewhere on the board
/Data Buffers/P12B3: U5.10 (D3); also elsewhere on the board
/Data Buffers/P12B4: U7.10 (D3); also elsewhere on the board
/Data Buffers/P12B5: U8.10 (D3); also elsewhere on the board
/Data Buffers/P12B6: U9.10 (D3); also elsewhere on the board
/Data Buffers/P12B7: U10.10 (D3); also elsewhere on the board
/Data Buffers/P12OL: U6.10 (D3); also elsewhere on the board
/Data Buffers/P13B0: U2.9 (D2); also elsewhere on the board
/Data Buffers/P13B1: U3.9 (D2); also elsewhere on the board
/Data Buffers/P13B2: U4.9 (D2); also elsewhere on the board
/Data Buffers/P13B3: U5.9 (D2); also elsewhere on the board
/Data Buffers/P13B4: U7.9 (D2); also elsewhere on the board
/Data Buffers/P13B5: U8.9 (D2); also elsewhere on the board
/Data Buffers/P13B6: U9.9 (D2); also elsewhere on the board
/Data Buffers/P13B7: U10.9 (D2); also elsewhere on the board
/Data Buffers/P13OL: U6.9 (D2); also elsewhere on the board
/Data Buffers/P14B0: U2.8 (D1); also elsewhere on the board
/Data Buffers/P14B1: U3.8 (D1); also elsewhere on the board
/Data Buffers/P14B2: U4.8 (D1); also elsewhere on the board
/Data Buffers/P14B3: U5.8 (D1); also elsewhere on the board
/Data Buffers/P14B4: U7.8 (D1); also elsewhere on the board
/Data Buffers/P14B5: U8.8 (D1); also elsewhere on the board
/Data Buffers/P14B6: U9.8 (D1); also elsewhere on the board
/Data Buffers/P14B7: U10.8 (D1); also elsewhere on the board
/Data Buffers/P14OL: U6.8 (D1); also elsewhere on the board
/Data Buffers/P15B0: U2.7 (D0); also elsewhere on the board
/Data Buffers/P15B1: U3.7 (D0); also elsewhere on the board
/Data Buffers/P15B2: U4.7 (D0); also elsewhere on the board
/Data Buffers/P15B3: U5.7 (D0); also elsewhere on the board
/Data Buffers/P15B4: U7.7 (D0); also elsewhere on the board
/Data Buffers/P15B5: U8.7 (D0); also elsewhere on the board
/Data Buffers/P15B6: U9.7 (D0); also elsewhere on the board
/Data Buffers/P15B7: U10.7 (D0); also elsewhere on the board
/Data Buffers/P15OL: U6.7 (D0); also elsewhere on the board
/Shift Registers/OLPLOAD: U6.5 (LD); also elsewhere on the board
/Shift Registers/PCLK: U2.2 (CP_), U3.2 (CP_), U4.2 (CP_), U5.2 (CP_), U6.2 (CP_), U7.2 (CP_), U8.2 (CP_), U9.2 (CP_), U10.2 (CP_); also elsewhere on the board
/Shift Registers/PD0: U2.6 (SDO); also elsewhere on the board
/Shift Registers/PD1: U3.6 (SDO); also elsewhere on the board
/Shift Registers/PD2: U4.6 (SDO); also elsewhere on the board
/Shift Registers/PD3: U5.6 (SDO); also elsewhere on the board
/Shift Registers/PD4: U7.6 (SDO); also elsewhere on the board
/Shift Registers/PD5: U8.6 (SDO); also elsewhere on the board
/Shift Registers/PD6: U9.6 (SDO); also elsewhere on the board
/Shift Registers/PD7: U10.6 (SDO); also elsewhere on the board
/Shift Registers/PDOL: U6.6 (SDO); also elsewhere on the board
/Shift Registers/PLOAD: U2.5 (LD), U3.5 (LD), U4.5 (LD), U5.5 (LD), U7.5 (LD), U8.5 (LD), U9.5 (LD), U10.5 (LD); also elsewhere on the board
GND: U2.1 (CS_), U2.4 (SDI), U2.12 (GND), U3.1 (CS_), U3.4 (SDI), U3.12 (GND), U4.1 (CS_), U4.4 (SDI), U4.12 (GND), U5.1 (CS_), U5.4 (SDI), U5.12 (GND), U6.1 (CS_), U6.4 (SDI), U6.12 (GND), U7.1 (CS_), U7.4 (SDI), U7.12 (GND), U8.1 (CS_), U8.4 (SDI), U8.12 (GND), U9.1 (CS_), U9.4 (SDI), U9.12 (GND), U10.1 (CS_), U10.4 (SDI), U10.12 (GND); also elsewhere on the board

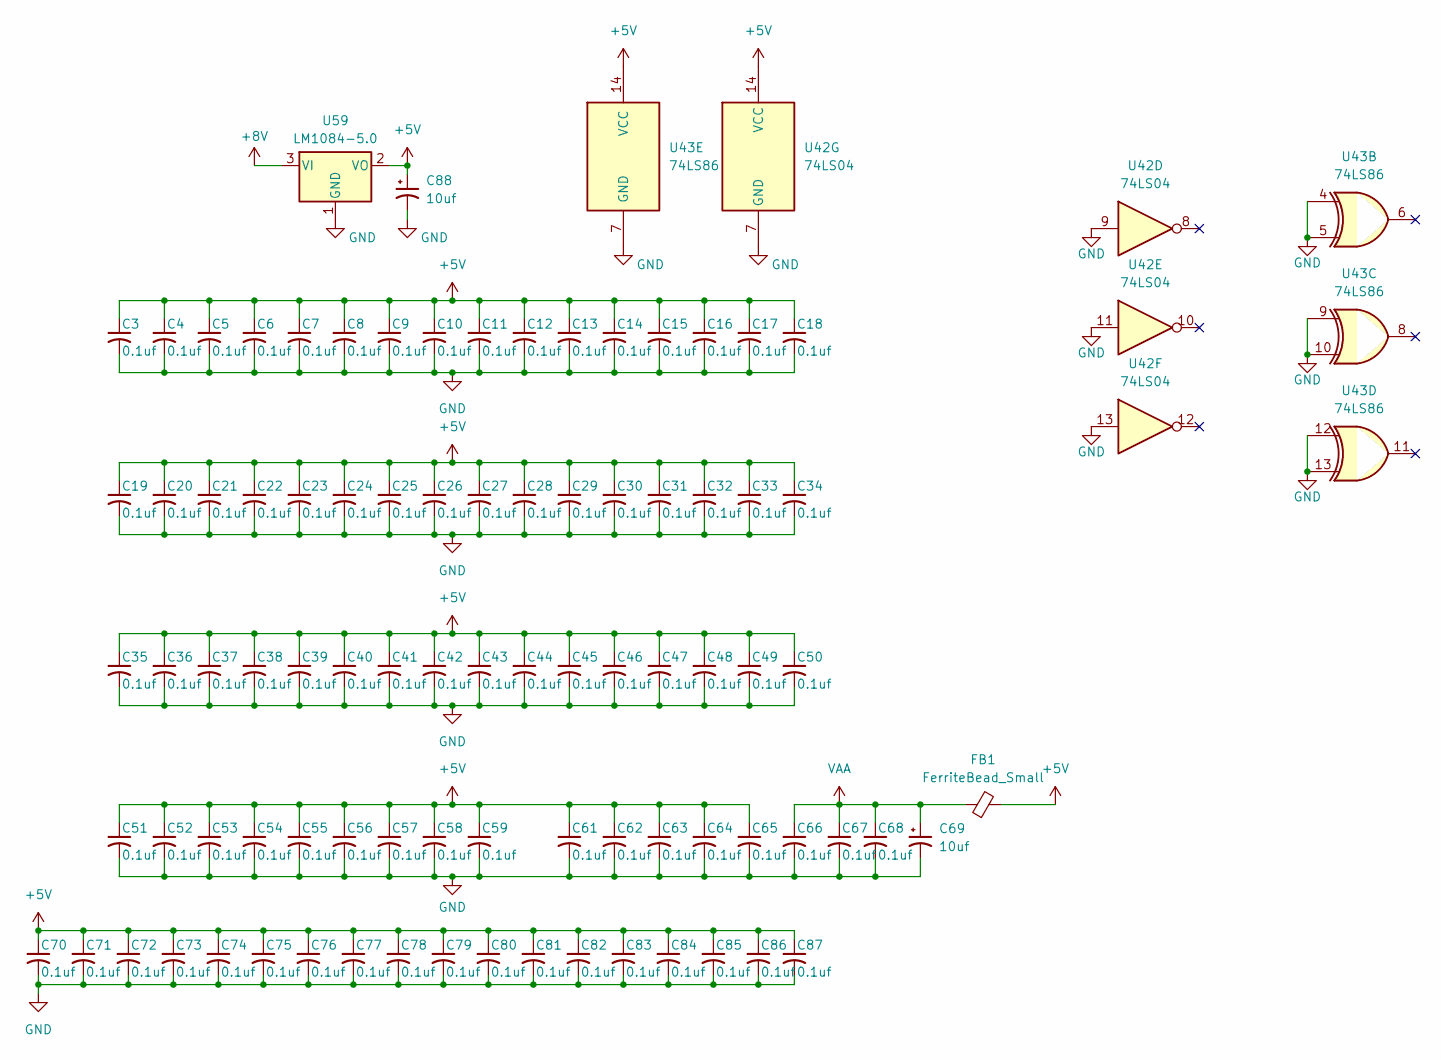
[picture p28: schematic Power.kicad_sch]

Parts:
C3, C4, C5, C6, C7, C10, C11, C12, C13, C14, C17, C18, C19, C20, C21, C26, C27, C28, C29, C30, C33, C34, C35, C36, C37, C40, C41, C42, C43, C44, C46, C47, C48, C49, C50, C53, C54, C55, C56, C57, C59, C62, C63, C64, C65: 0.1uf; C_Rect_L9.1mm_W2.5mm_P7.62mm_MKT
C8, C9, C15, C16, C22, C23, C24, C25, C31, C32, C38, C39, C45, C51, C52, C58, C61: 0.1uf; C_Rect_L9.1mm_W2.5mm_P7.62mm_Small_Pads
C66, C67, C68: 0.1uf; C_0805_2012Metric_Pad1.18x1.45mm_HandSolder
C69, C88: 10uf; C_Rect_L9.1mm_W2.5mm_P7.62mm_MKT
C70, C71, C72, C73, C74, C75, C76, C77, C78, C79, C80, C81, C82, C83, C84, C85, C86, C87: 0.1uf; C_0603_1608Metric_Pad1.08x0.95mm_HandSolder
FB1: FerriteBead_Small; C_Rect_L9.1mm_W2.5mm_P7.62mm_MKT
U42: 74LS04; DIP-14_W7.62mm_Socket
U43: 74LS86; DIP-14_W7.62mm_Socket
U59: LM1084-5.0; TO-220F-3_Horizontal_TabDown

Connections:
+5V: C3.1, C4.1, C5.1, C6.1, C7.1, C8.1, C9.1, C10.1, C11.1, C12.1, C13.1, C14.1, C15.1, C16.1, C17.1, C18.1, C19.1, C20.1, C21.1, C22.1, C23.1, C24.1, C25.1, C26.1, C27.1, C28.1, C29.1, C30.1, C31.1, C32.1, C33.1, C34.1, C35.1, C36.1, C37.1, C38.1, C39.1, C40.1, C41.1, C42.1, C43.1, C44.1, C45.1, C46.1, C47.1, C48.1, C49.1, C50.1, C51.1, C52.1, C53.1, C54.1, C55.1, C56.1, C57.1, C58.1, C59.1, C61.1, C62.1, C63.1, C64.1, C65.1, C70.1, C71.1, C72.1, C73.1, C74.1, C75.1, C76.1, C77.1, C78.1, C79.1, C80.1, C81.1, C82.1, C83.1, C84.1, C85.1, C86.1, C87.1, C88.1, FB1.2, U42.14 (VCC), U43.14 (VCC), U59.2 (VO); also elsewhere on the board
+8V: U59.3 (VI); also elsewhere on the board
GND: C3.2, C4.2, C5.2, C6.2, C7.2, C8.2, C9.2, C10.2, C11.2, C12.2, C13.2, C14.2, C15.2, C16.2, C17.2, C18.2, C19.2, C20.2, C21.2, C22.2, C23.2, C24.2, C25.2, C26.2, C27.2, C28.2, C29.2, C30.2, C31.2, C32.2, C33.2, C34.2, C35.2, C36.2, C37.2, C38.2, C39.2, C40.2, C41.2, C42.2, C43.2, C44.2, C45.2, C46.2, C47.2, C48.2, C49.2, C50.2, C51.2, C52.2, C53.2, C54.2, C55.2, C56.2, C57.2, C58.2, C59.2, C61.2, C62.2, C63.2, C64.2, C65.2, C66.2, C67.2, C68.2, C69.2, C70.2, C71.2, C72.2, C73.2, C74.2, C75.2, C76.2, C77.2, C78.2, C79.2, C80.2, C81.2, C82.2, C83.2, C84.2, C85.2, C86.2, C87.2, C88.2, U42.7 (GND), U42.9, U42.11, U42.13, U43.4, U43.5, U43.7 (GND), U43.9, U43.10, U43.12, U43.13, U59.1 (GND); also elsewhere on the board
VAA: C66.1, C67.1, C68.1, C69.1, FB1.1; also elsewhere on the board
