ToddHoug/cadzilla/schematics/cadzilla.kicad_pcb

## KiCad design schematics/cadzilla.kicad_pcb (continued)

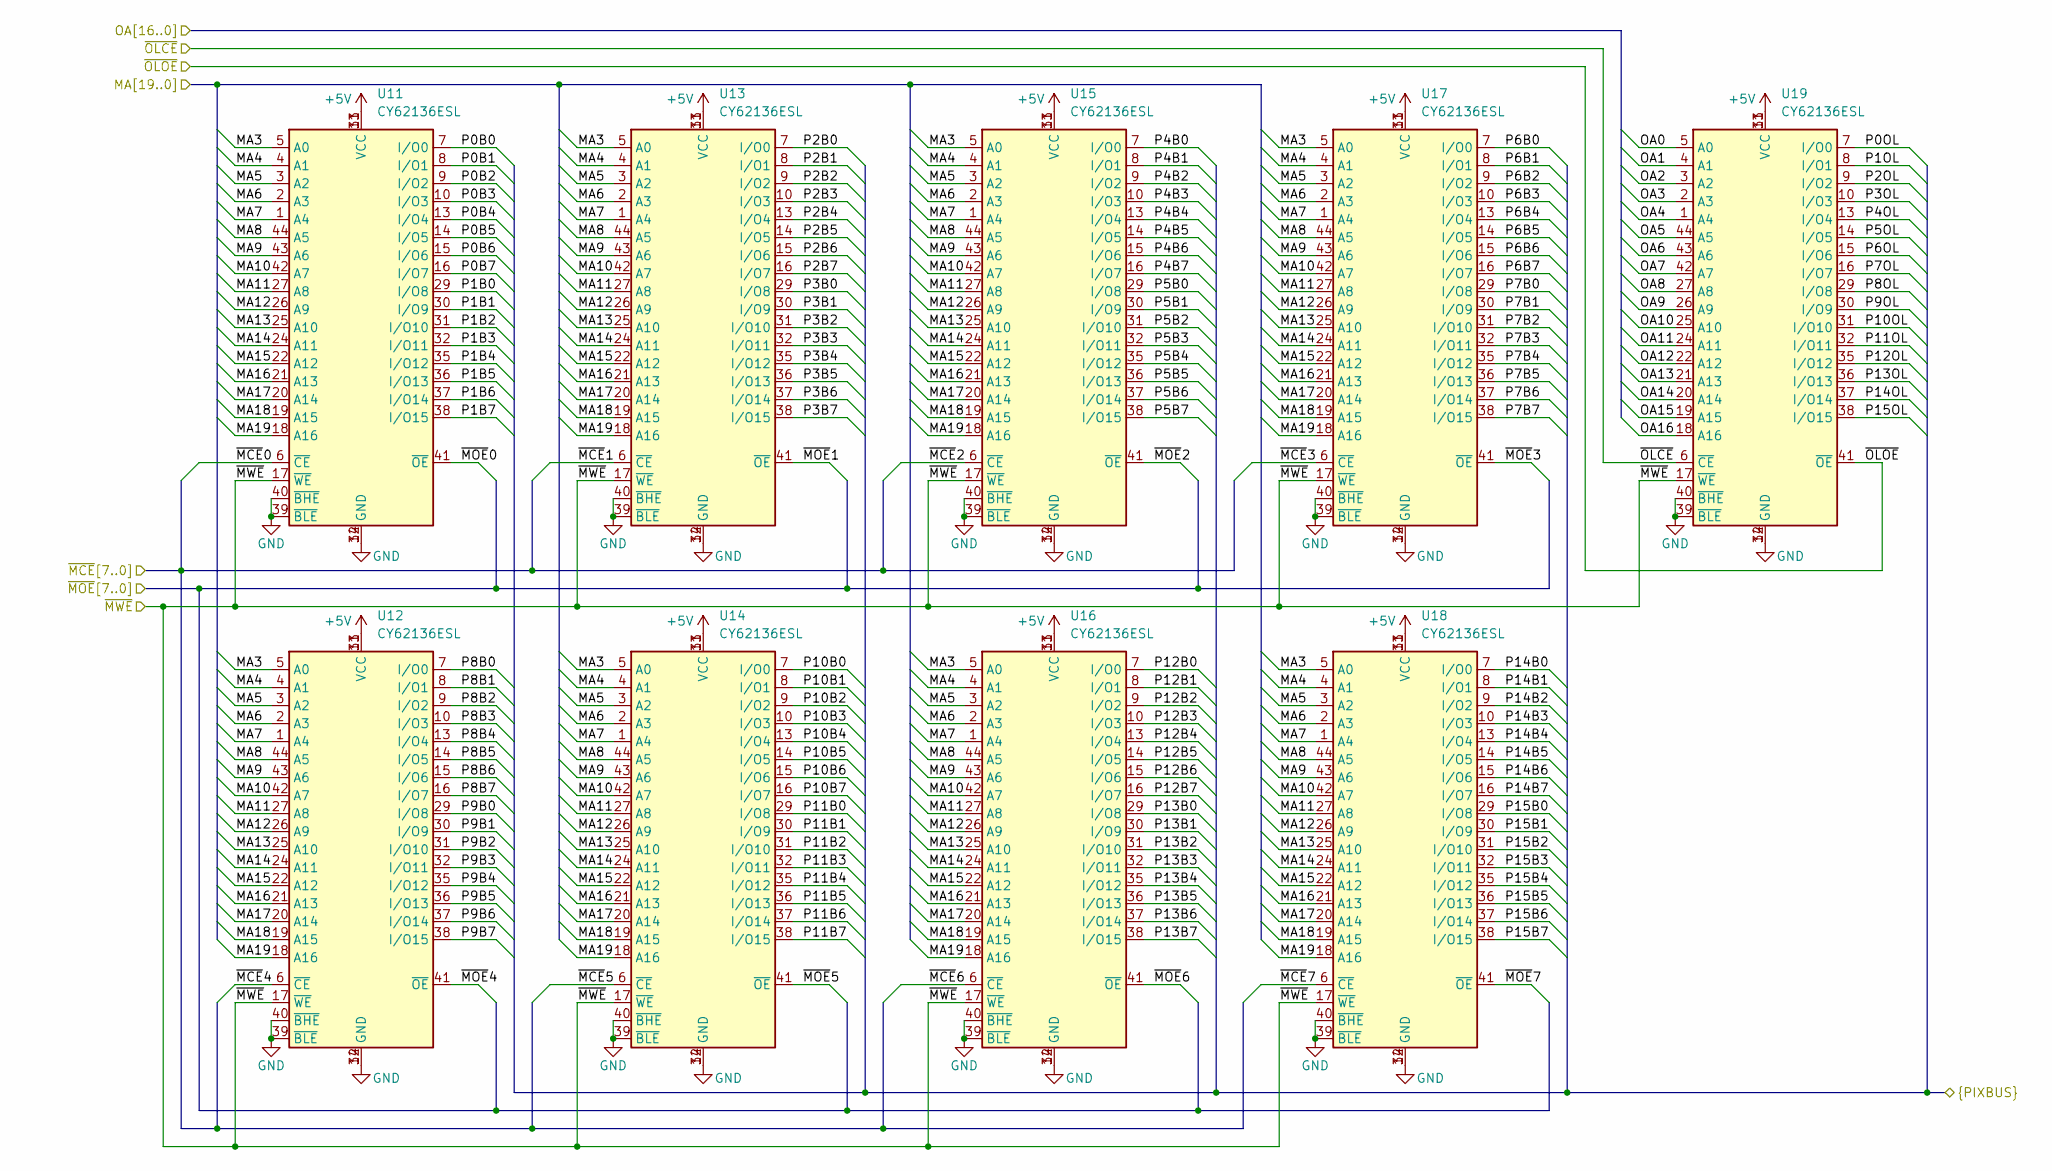
[picture p29: schematic Memory.kicad_sch]

Parts:
U11, U12, U13, U14, U15, U16, U17, U18, U19: CY62136ESL; TSOP-II-44_10.16x18.41mm_P0.8mm

Connections:
+5V: U11.11 (VCC), U11.33 (VCC), U12.11 (VCC), U12.33 (VCC), U13.11 (VCC), U13.33 (VCC), U14.11 (VCC), U14.33 (VCC), U15.11 (VCC), U15.33 (VCC), U16.11 (VCC), U16.33 (VCC), U17.11 (VCC), U17.33 (VCC), U18.11 (VCC), U18.33 (VCC), U19.11 (VCC), U19.33 (VCC); also elsewhere on the board
/Data Buffers/P0B0: U11.7 (I/O0); also elsewhere on the board
/Data Buffers/P0B1: U11.8 (I/O1); also elsewhere on the board
/Data Buffers/P0B2: U11.9 (I/O2); also elsewhere on the board
/Data Buffers/P0B3: U11.10 (I/O3); also elsewhere on the board
/Data Buffers/P0B4: U11.13 (I/O4); also elsewhere on the board
/Data Buffers/P0B5: U11.14 (I/O5); also elsewhere on the board
/Data Buffers/P0B6: U11.15 (I/O6); also elsewhere on the board
/Data Buffers/P0B7: U11.16 (I/O7); also elsewhere on the board
/Data Buffers/P0OL: U19.7 (I/O0); also elsewhere on the board
/Data Buffers/P1B0: U11.29 (I/O8); also elsewhere on the board
/Data Buffers/P1B1: U11.30 (I/O9); also elsewhere on the board
/Data Buffers/P1B2: U11.31 (I/O10); also elsewhere on the board
/Data Buffers/P1B3: U11.32 (I/O11); also elsewhere on the board
/Data Buffers/P1B4: U11.35 (I/O12); also elsewhere on the board
/Data Buffers/P1B5: U11.36 (I/O13); also elsewhere on the board
/Data Buffers/P1B6: U11.37 (I/O14); also elsewhere on the board
/Data Buffers/P1B7: U11.38 (I/O15); also elsewhere on the board
/Data Buffers/P1OL: U19.8 (I/O1); also elsewhere on the board
/Data Buffers/P2B0: U13.7 (I/O0); also elsewhere on the board
/Data Buffers/P2B1: U13.8 (I/O1); also elsewhere on the board
/Data Buffers/P2B2: U13.9 (I/O2); also elsewhere on the board
/Data Buffers/P2B3: U13.10 (I/O3); also elsewhere on the board
/Data Buffers/P2B4: U13.13 (I/O4); also elsewhere on the board
/Data Buffers/P2B5: U13.14 (I/O5); also elsewhere on the board
/Data Buffers/P2B6: U13.15 (I/O6); also elsewhere on the board
/Data Buffers/P2B7: U13.16 (I/O7); also elsewhere on the board
/Data Buffers/P2OL: U19.9 (I/O2); also elsewhere on the board
/Data Buffers/P3B0: U13.29 (I/O8); also elsewhere on the board
/Data Buffers/P3B1: U13.30 (I/O9); also elsewhere on the board
/Data Buffers/P3B2: U13.31 (I/O10); also elsewhere on the board
/Data Buffers/P3B3: U13.32 (I/O11); also elsewhere on the board
/Data Buffers/P3B4: U13.35 (I/O12); also elsewhere on the board
/Data Buffers/P3B5: U13.36 (I/O13); also elsewhere on the board
/Data Buffers/P3B6: U13.37 (I/O14); also elsewhere on the board
/Data Buffers/P3B7: U13.38 (I/O15); also elsewhere on the board
/Data Buffers/P3OL: U19.10 (I/O3); also elsewhere on the board
/Data Buffers/P4B0: U15.7 (I/O0); also elsewhere on the board
/Data Buffers/P4B1: U15.8 (I/O1); also elsewhere on the board
/Data Buffers/P4B2: U15.9 (I/O2); also elsewhere on the board
/Data Buffers/P4B3: U15.10 (I/O3); also elsewhere on the board
/Data Buffers/P4B4: U15.13 (I/O4); also elsewhere on the board
/Data Buffers/P4B5: U15.14 (I/O5); also elsewhere on the board
/Data Buffers/P4B6: U15.15 (I/O6); also elsewhere on the board
/Data Buffers/P4B7: U15.16 (I/O7); also elsewhere on the board
/Data Buffers/P4OL: U19.13 (I/O4); also elsewhere on the board
/Data Buffers/P5B0: U15.29 (I/O8); also elsewhere on the board
/Data Buffers/P5B1: U15.30 (I/O9); also elsewhere on the board
/Data Buffers/P5B2: U15.31 (I/O10); also elsewhere on the board
/Data Buffers/P5B3: U15.32 (I/O11); also elsewhere on the board
/Data Buffers/P5B4: U15.35 (I/O12); also elsewhere on the board
/Data Buffers/P5B5: U15.36 (I/O13); also elsewhere on the board
/Data Buffers/P5B6: U15.37 (I/O14); also elsewhere on the board
/Data Buffers/P5B7: U15.38 (I/O15); also elsewhere on the board
/Data Buffers/P5OL: U19.14 (I/O5); also elsewhere on the board
/Data Buffers/P6B0: U17.7 (I/O0); also elsewhere on the board
/Data Buffers/P6B1: U17.8 (I/O1); also elsewhere on the board
/Data Buffers/P6B2: U17.9 (I/O2); also elsewhere on the board
/Data Buffers/P6B3: U17.10 (I/O3); also elsewhere on the board
/Data Buffers/P6B4: U17.13 (I/O4); also elsewhere on the board
/Data Buffers/P6B5: U17.14 (I/O5); also elsewhere on the board
/Data Buffers/P6B6: U17.15 (I/O6); also elsewhere on the board
/Data Buffers/P6B7: U17.16 (I/O7); also elsewhere on the board
/Data Buffers/P6OL: U19.15 (I/O6); also elsewhere on the board
/Data Buffers/P7B0: U17.29 (I/O8); also elsewhere on the board
/Data Buffers/P7B1: U17.30 (I/O9); also elsewhere on the board
/Data Buffers/P7B2: U17.31 (I/O10); also elsewhere on the board
/Data Buffers/P7B3: U17.32 (I/O11); also elsewhere on the board
/Data Buffers/P7B4: U17.35 (I/O12); also elsewhere on the board
/Data Buffers/P7B5: U17.36 (I/O13); also elsewhere on the board
/Data Buffers/P7B6: U17.37 (I/O14); also elsewhere on the board
/Data Buffers/P7B7: U17.38 (I/O15); also elsewhere on the board
/Data Buffers/P7OL: U19.16 (I/O7); also elsewhere on the board
/Data Buffers/P8B0: U12.7 (I/O0); also elsewhere on the board
/Data Buffers/P8B1: U12.8 (I/O1); also elsewhere on the board
/Data Buffers/P8B2: U12.9 (I/O2); also elsewhere on the board
/Data Buffers/P8B3: U12.10 (I/O3); also elsewhere on the board
/Data Buffers/P8B4: U12.13 (I/O4); also elsewhere on the board
/Data Buffers/P8B5: U12.14 (I/O5); also elsewhere on the board
/Data Buffers/P8B6: U12.15 (I/O6); also elsewhere on the board
/Data Buffers/P8B7: U12.16 (I/O7); also elsewhere on the board
/Data Buffers/P8OL: U19.29 (I/O8); also elsewhere on the board
/Data Buffers/P9B0: U12.29 (I/O8); also elsewhere on the board
/Data Buffers/P9B1: U12.30 (I/O9); also elsewhere on the board
/Data Buffers/P9B2: U12.31 (I/O10); also elsewhere on the board
/Data Buffers/P9B3: U12.32 (I/O11); also elsewhere on the board
/Data Buffers/P9B4: U12.35 (I/O12); also elsewhere on the board
/Data Buffers/P9B5: U12.36 (I/O13); also elsewhere on the board
/Data Buffers/P9B6: U12.37 (I/O14); also elsewhere on the board
/Data Buffers/P9B7: U12.38 (I/O15); also elsewhere on the board
/Data Buffers/P9OL: U19.30 (I/O9); also elsewhere on the board
/Data Buffers/P10B0: U14.7 (I/O0); also elsewhere on the board
/Data Buffers/P10B1: U14.8 (I/O1); also elsewhere on the board
/Data Buffers/P10B2: U14.9 (I/O2); also elsewhere on the board
/Data Buffers/P10B3: U14.10 (I/O3); also elsewhere on the board
/Data Buffers/P10B4: U14.13 (I/O4); also elsewhere on the board
/Data Buffers/P10B5: U14.14 (I/O5); also elsewhere on the board
/Data Buffers/P10B6: U14.15 (I/O6); also elsewhere on the board
/Data Buffers/P10B7: U14.16 (I/O7); also elsewhere on the board
/Data Buffers/P10OL: U19.31 (I/O10); also elsewhere on the board
/Data Buffers/P11B0: U14.29 (I/O8); also elsewhere on the board
/Data Buffers/P11B1: U14.30 (I/O9); also elsewhere on the board
/Data Buffers/P11B2: U14.31 (I/O10); also elsewhere on the board
/Data Buffers/P11B3: U14.32 (I/O11); also elsewhere on the board
/Data Buffers/P11B4: U14.35 (I/O12); also elsewhere on the board
/Data Buffers/P11B5: U14.36 (I/O13); also elsewhere on the board
/Data Buffers/P11B6: U14.37 (I/O14); also elsewhere on the board
/Data Buffers/P11B7: U14.38 (I/O15); also elsewhere on the board
/Data Buffers/P11OL: U19.32 (I/O11); also elsewhere on the board
/Data Buffers/P12B0: U16.7 (I/O0); also elsewhere on the board
/Data Buffers/P12B1: U16.8 (I/O1); also elsewhere on the board
/Data Buffers/P12B2: U16.9 (I/O2); also elsewhere on the board
/Data Buffers/P12B3: U16.10 (I/O3); also elsewhere on the board
/Data Buffers/P12B4: U16.13 (I/O4); also elsewhere on the board
/Data Buffers/P12B5: U16.14 (I/O5); also elsewhere on the board
/Data Buffers/P12B6: U16.15 (I/O6); also elsewhere on the board
/Data Buffers/P12B7: U16.16 (I/O7); also elsewhere on the board
/Data Buffers/P12OL: U19.35 (I/O12); also elsewhere on the board
/Data Buffers/P13B0: U16.29 (I/O8); also elsewhere on the board
/Data Buffers/P13B1: U16.30 (I/O9); also elsewhere on the board
/Data Buffers/P13B2: U16.31 (I/O10); also elsewhere on the board
/Data Buffers/P13B3: U16.32 (I/O11); also elsewhere on the board
/Data Buffers/P13B4: U16.35 (I/O12); also elsewhere on the board
/Data Buffers/P13B5: U16.36 (I/O13); also elsewhere on the board
/Data Buffers/P13B6: U16.37 (I/O14); also elsewhere on the board
/Data Buffers/P13B7: U16.38 (I/O15); also elsewhere on the board
/Data Buffers/P13OL: U19.36 (I/O13); also elsewhere on the board
/Data Buffers/P14B0: U18.7 (I/O0); also elsewhere on the board
/Data Buffers/P14B1: U18.8 (I/O1); also elsewhere on the board
/Data Buffers/P14B2: U18.9 (I/O2); also elsewhere on the board
/Data Buffers/P14B3: U18.10 (I/O3); also elsewhere on the board
/Data Buffers/P14B4: U18.13 (I/O4); also elsewhere on the board
/Data Buffers/P14B5: U18.14 (I/O5); also elsewhere on the board
/Data Buffers/P14B6: U18.15 (I/O6); also elsewhere on the board
/Data Buffers/P14B7: U18.16 (I/O7); also elsewhere on the board
/Data Buffers/P14OL: U19.37 (I/O14); also elsewhere on the board
/Data Buffers/P15B0: U18.29 (I/O8); also elsewhere on the board
/Data Buffers/P15B1: U18.30 (I/O9); also elsewhere on the board
/Data Buffers/P15B2: U18.31 (I/O10); also elsewhere on the board
/Data Buffers/P15B3: U18.32 (I/O11); also elsewhere on the board
/Data Buffers/P15B4: U18.35 (I/O12); also elsewhere on the board
/Data Buffers/P15B5: U18.36 (I/O13); also elsewhere on the board
/Data Buffers/P15B6: U18.37 (I/O14); also elsewhere on the board
/Data Buffers/P15B7: U18.38 (I/O15); also elsewhere on the board
/Data Buffers/P15OL: U19.38 (I/O15); also elsewhere on the board
/Memory Interface/MA3: U11.5 (A0), U12.5 (A0), U13.5 (A0), U14.5 (A0), U15.5 (A0), U16.5 (A0), U17.5 (A0), U18.5 (A0); also elsewhere on the board
/Memory Interface/MA4: U11.4 (A1), U12.4 (A1), U13.4 (A1), U14.4 (A1), U15.4 (A1), U16.4 (A1), U17.4 (A1), U18.4 (A1); also elsewhere on the board
/Memory Interface/MA5: U11.3 (A2), U12.3 (A2), U13.3 (A2), U14.3 (A2), U15.3 (A2), U16.3 (A2), U17.3 (A2), U18.3 (A2); also elsewhere on the board
/Memory Interface/MA6: U11.2 (A3), U12.2 (A3), U13.2 (A3), U14.2 (A3), U15.2 (A3), U16.2 (A3), U17.2 (A3), U18.2 (A3); also elsewhere on the board
/Memory Interface/MA7: U11.1 (A4), U12.1 (A4), U13.1 (A4), U14.1 (A4), U15.1 (A4), U16.1 (A4), U17.1 (A4), U18.1 (A4); also elsewhere on the board
/Memory Interface/MA8: U11.44 (A5), U12.44 (A5), U13.44 (A5), U14.44 (A5), U15.44 (A5), U16.44 (A5), U17.44 (A5), U18.44 (A5); also elsewhere on the board
/Memory Interface/MA9: U11.43 (A6), U12.43 (A6), U13.43 (A6), U14.43 (A6), U15.43 (A6), U16.43 (A6), U17.43 (A6), U18.43 (A6); also elsewhere on the board
/Memory Interface/MA10: U11.42 (A7), U12.42 (A7), U13.42 (A7), U14.42 (A7), U15.42 (A7), U16.42 (A7), U17.42 (A7), U18.42 (A7); also elsewhere on the board
/Memory Interface/MA11: U11.27 (A8), U12.27 (A8), U13.27 (A8), U14.27 (A8), U15.27 (A8), U16.27 (A8), U17.27 (A8), U18.27 (A8); also elsewhere on the board
/Memory Interface/MA12: U11.26 (A9), U12.26 (A9), U13.26 (A9), U14.26 (A9), U15.26 (A9), U16.26 (A9), U17.26 (A9), U18.26 (A9); also elsewhere on the board
/Memory Interface/MA13: U11.25 (A10), U12.25 (A10), U13.25 (A10), U14.25 (A10), U15.25 (A10), U16.25 (A10), U17.25 (A10), U18.25 (A10); also elsewhere on the board
/Memory Interface/MA14: U11.24 (A11), U12.24 (A11), U13.24 (A11), U14.24 (A11), U15.24 (A11), U16.24 (A11), U17.24 (A11), U18.24 (A11); also elsewhere on the board
/Memory Interface/MA15: U11.22 (A12), U12.22 (A12), U13.22 (A12), U14.22 (A12), U15.22 (A12), U16.22 (A12), U17.22 (A12), U18.22 (A12); also elsewhere on the board
/Memory Interface/MA16: U11.21 (A13), U12.21 (A13), U13.21 (A13), U14.21 (A13), U15.21 (A13), U16.21 (A13), U17.21 (A13), U18.21 (A13); also elsewhere on the board
/Memory Interface/MA17: U11.20 (A14), U12.20 (A14), U13.20 (A14), U14.20 (A14), U15.20 (A14), U16.20 (A14), U17.20 (A14), U18.20 (A14); also elsewhere on the board
/Memory Interface/MA18: U11.19 (A15), U12.19 (A15), U13.19 (A15), U14.19 (A15), U15.19 (A15), U16.19 (A15), U17.19 (A15), U18.19 (A15); also elsewhere on the board
/Memory Interface/MA19: U11.18 (A16), U12.18 (A16), U13.18 (A16), U14.18 (A16), U15.18 (A16), U16.18 (A16), U17.18 (A16), U18.18 (A16); also elsewhere on the board
/Memory Interface/OA0: U19.5 (A0); also elsewhere on the board
/Memory Interface/OA1: U19.4 (A1); also elsewhere on the board
/Memory Interface/OA2: U19.3 (A2); also elsewhere on the board
/Memory Interface/OA3: U19.2 (A3); also elsewhere on the board
/Memory Interface/OA4: U19.1 (A4); also elsewhere on the board
/Memory Interface/OA5: U19.44 (A5); also elsewhere on the board
/Memory Interface/OA6: U19.43 (A6); also elsewhere on the board
/Memory Interface/OA7: U19.42 (A7); also elsewhere on the board
/Memory Interface/OA8: U19.27 (A8); also elsewhere on the board
/Memory Interface/OA9: U19.26 (A9); also elsewhere on the board
/Memory Interface/OA10: U19.25 (A10); also elsewhere on the board
/Memory Interface/OA11: U19.24 (A11); also elsewhere on the board
/Memory Interface/OA12: U19.22 (A12); also elsewhere on the board
/Memory Interface/OA13: U19.21 (A13); also elsewhere on the board
/Memory Interface/OA14: U19.20 (A14); also elsewhere on the board
/Memory Interface/OA15: U19.19 (A15); also elsewhere on the board
/Memory Interface/OA16: U19.18 (A16); also elsewhere on the board
/Memory Interface/~MCE0: U11.6 (~CE); also elsewhere on the board
/Memory Interface/~MCE1: U13.6 (~CE); also elsewhere on the board
/Memory Interface/~MCE2: U15.6 (~CE); also elsewhere on the board
/Memory Interface/~MCE3: U17.6 (~CE); also elsewhere on the board
/Memory Interface/~MCE4: U12.6 (~CE); also elsewhere on the board
/Memory Interface/~MCE5: U14.6 (~CE); also elsewhere on the board
/Memory Interface/~MCE6: U16.6 (~CE); also elsewhere on the board
/Memory Interface/~MCE7: U18.6 (~CE); also elsewhere on the board
/Memory Interface/~MOE0: U11.41 (~OE); also elsewhere on the board
/Memory Interface/~MOE1: U13.41 (~OE); also elsewhere on the board
/Memory Interface/~MOE2: U15.41 (~OE); also elsewhere on the board
/Memory Interface/~MOE3: U17.41 (~OE); also elsewhere on the board
/Memory Interface/~MOE4: U12.41 (~OE); also elsewhere on the board
/Memory Interface/~MOE5: U14.41 (~OE); also elsewhere on the board
/Memory Interface/~MOE6: U16.41 (~OE); also elsewhere on the board
/Memory Interface/~MOE7: U18.41 (~OE); also elsewhere on the board
/Memory Interface/~MWE: U11.17 (~WE), U12.17 (~WE), U13.17 (~WE), U14.17 (~WE), U15.17 (~WE), U16.17 (~WE), U17.17 (~WE), U18.17 (~WE), U19.17 (~WE); also elsewhere on the board
/Memory Interface/~OLCE: U19.6 (~CE); also elsewhere on the board
/Memory Interface/~OLOE: U19.41 (~OE); also elsewhere on the board
GND: U11.12 (GND), U11.34 (GND), U11.39 (~BLE), U11.40 (~BHE), U12.12 (GND), U12.34 (GND), U12.39 (~BLE), U12.40 (~BHE), U13.12 (GND), U13.34 (GND), U13.39 (~BLE), U13.40 (~BHE), U14.12 (GND), U14.34 (GND), U14.39 (~BLE), U14.40 (~BHE), U15.12 (GND), U15.34 (GND), U15.39 (~BLE), U15.40 (~BHE), U16.12 (GND), U16.34 (GND), U16.39 (~BLE), U16.40 (~BHE), U17.12 (GND), U17.34 (GND), U17.39 (~BLE), U17.40 (~BHE), U18.12 (GND), U18.34 (GND), U18.39 (~BLE), U18.40 (~BHE), U19.12 (GND), U19.34 (GND), U19.39 (~BLE), U19.40 (~BHE); also elsewhere on the board

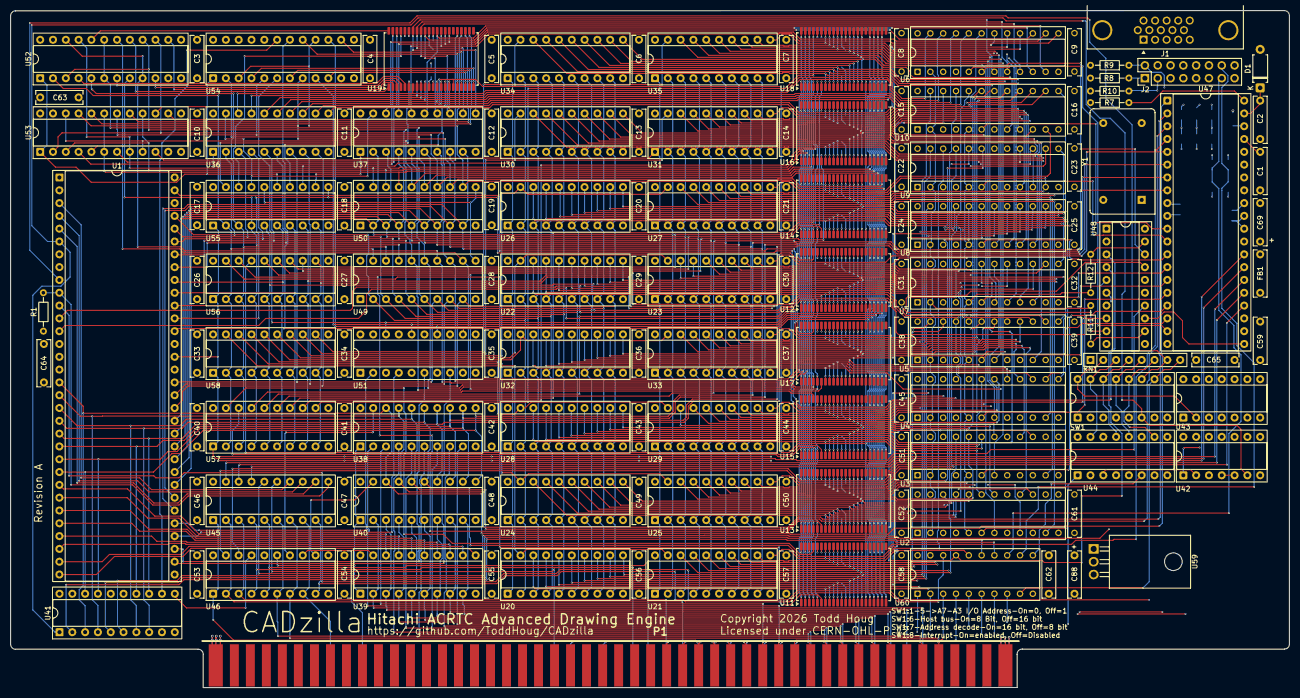
[picture p30: board cadzilla.kicad_pcb from above]

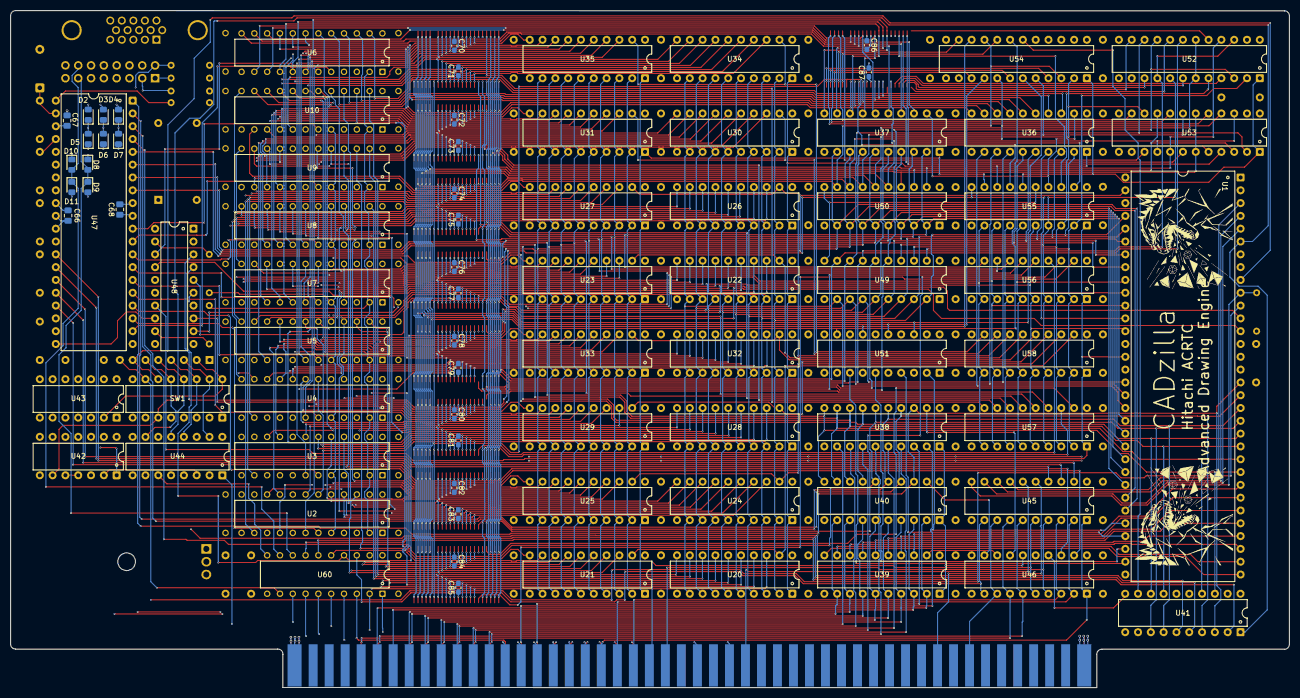
[picture p31: board cadzilla.kicad_pcb from below]

Board: 6 copper layers, 253.6 x 134.2 mm, 172 parts (31 on the bottom side), 361 nets.
