ToddHoug/cadzilla/(commit log)

2026-09-21 Initial project scaffold: schematics, pld, software/firstdraw, docs, tools, tests
2026-09-21 Add altairsim CP/M dev bench and first software project: hello
    Sets up the 8080/CP/M 2.2 build-and-run workflow on altairsim, driven via
    its MCP server: a machine definition based on the real cadzilla board
    (HD63484 ACRTC + Bt453 RAMDAC) with CP/M boot support layered on top, a
    pristine/working disk split to protect against in-place mutation, and a
    README documenting the workflow along with several gotchas found while
    building it (CP/M's console-input uppercasing, the real board's 2MHz
    clock racing the MCP run tool, binary R/W transfer behavior).
    Also adds software/hello, a minimal CP/M program that prints a welcome
    message, as the first working example of the new toolchain.
    Co-Authored-By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
2026-09-21 Add new-cadzilla-project skill; document session-resume disk gotcha
    The skill scaffolds a new software/<name>/ project (directories, an
    uppercase CR/LF-terminated starter .ASM stub via a bundled script) and
    drives the altairsim MCP tools through a first assemble/load/run so a new
    project starts from a toolchain that's already proven to work.
    Building and testing it against the real repo surfaced a real gotcha:
    resuming a session after a prior turn cleanly UNMOUNTed the disk leaves
    CP/M looking alive at A> while every disk access silently fails, and
    remounting mid-session then trips CP/M's defensive read-only flag until a
    warm boot clears it. Documented the fix in tools/altairsim/README.md a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
2026-09-21 Fill in software/firstdraw; support long names and existing scaffolds
    Adds FIRSTDRW.ASM as firstdraw's starter program, built via the
    new-cadzilla-project skill and verified end-to-end (assembled, loaded,
    run, output confirmed) on altairsim.
    Running the skill against firstdraw surfaced two real gaps in
    new_project.sh: it had no way to give a CP/M-side name shorter than an
    8-character-plus project name (firstdraw is 9 characters, over CP/M's
    8.3 limit), and it refused to run against a directory that already
    existed as an empty scaffold rather than filling it in. Added a
    --cpm-name override and made the script safe to run against an existing
    src/include/build layout, while still refusing to o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
2026-09-23 Add board user reference manual and update README with board spec
    Document the I/O address map (single base address, Base+0..7), MODE
    register bit definitions, SW1 configuration DIP switch, frame buffer,
    and HD63484 feature support in docs/cadzilla-manual.pdf and README.md,
    both fronted by the CADzilla logo.
2026-09-23 Rename manual title to "CADzilla User Reference Manual"
    Drop "Board" from the title in the PDF manual and README references.
2026-09-24 Reset the shared altairsim disk when starting or switching projects
    The working CP/M disk is one shared image that every project's ASM/LOAD
    writes onto, with no reclamation -- free space kept shrinking as more
    projects built on it (down to 120k from the pristine 174k after hello,
    firstdraw, and drawdemo). Adds tools/altairsim/scripts/reset_disk.sh to
    restore it from the pristine master, and wires it into both
    tools/altairsim/README.md and the new-cadzilla-project skill so a new
    project (or switching back to a different existing one) starts from a
    full disk instead of accumulating leftovers, while continuing work on
    the same project within a session still doesn't need a reset.
    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
2026-09-24 Write firstdraw: first-light init and test pattern
    Initializes the board for 640x480 at 8 bpp (MODE register, ACRTC
    registers, Bt453 palette of 8 hues x 32 levels) and draws a border,
    corner markers, palette grid, starburst, line grid and nested
    rectangles to verify the picture visually.
2026-09-24 Add drawdemo: one screen per ACRTC drawing command
    Steps through every graphic drawing command the altairsim HD63484
    model executes (DOT, ALINE, RLINE, ARCT, RRCT, APLL, RPLL, APLG,
    RPLG, AFRCT, RFRCT, with AMOVE/RMOVE placing them), pausing for a
    key between screens. Board setup follows software/firstdraw.
2026-09-24 Move to 8MB CP/M disk images and per-project altairsim work dirs
    Replaces the pristine CP/M disk with an 8MB virtual hard disk pair
    (CPM22-8MB-56K-DEV.DSK on drive 0, BLANK-8MB.DSK on drive 1), a big
    capacity jump from the old ~330KB 8" floppy image. Verified the new
    config end-to-end (boot, ASM/LOAD/run, W pull-back) -- the one real
    behavior change is the console prompt, now "A0>" (logical-unit
    numbering) instead of a plain "A>", which every `until` match in the
    docs and skill needed updating for.
    Also gives every software/<project>/ its own work/ (gitignored,
    persistent, private copy of the pristine machine + disks), replacing
    the single shared tools/altairsim/work/ that every project's b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
2026-09-24 Clean HELLO files out of the pristine CP/M disk and guard it
    The pristine CPM22-8MB-56K-DEV.DSK committed in 5702a62 carried
    HELLO.ASM/.PRN/.HEX/.COM, written into it by booting a machine with the
    pristine disk mounted. This commits the cleaned image (those directory
    entries deleted) and adds guards so it can't happen again:
    - Pristine files are kept read-only on the host; altairsim then mounts
    them WRITE-PROTECTED, so CP/M can't write to them even if pointed there.
    The stray executable bit on the two disk images is dropped too.
    - sync_pristine.sh re-applies chmod a-w to pristine on every run (git
    doesn't track write permission), makes the work/ copies writable again
    (cp carries the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
2026-09-24 Start altairsim on the built-in cadzilla machine; drop tools/altairsim/work
    The MCP server used to be registered against tools/altairsim/work/, a
    full CP/M machine with disks mounted, only so it had something to load
    at startup. A server outliving its session then held those disks open.
    It is now registered as `altairsim -m cadzilla --mcp`: the built-in board
    machine with no disks and no boot PROM, so nothing can be written until a
    project's own software/<name>/work/cadzilla.toml is CONFIG LOADed. The
    bootstrap directory and its .gitignore entry are gone.
    altairsim's built-in cadzilla machine now carries the front panel, a
    flat-out CPU, the host bridge, an empty DCDD and 56K of RAM, so the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
2026-09-24 Add M80/L80 toolchain with czgfx graphics library disk and gfxdemo
    ASM.COM has no INCLUDE, macros or linker, so every graphics program
    carried its own copy of the board setup and drawing code. New graphics
    work now uses Microsoft M80/L80 (already on the pristine CP/M disk):
    - software/czgfx: shared graphics-primitive library -- CZGFX.INC
    (equates, EXTRNs, G... drawing macros) plus relocatable modules
    (CZCORE, CZPAL, CZINIT, CZDRAW, CZPOLY) for 640x480 and 1024x768.
    CZBUILD.SUB builds them onto a library disk (libdisk/CZGFX.DSK,
    gitignored) and link-checks the published copy with CZCHK.
    - Consumers mount the library disk read-only as B:, INCLUDE
    B:CZGFX.INC and link with SUBMIT B:C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
2026-09-24 Add design philosophy to README and manual preface
    Explain why CADzilla exists: a hand-designed, period-accurate S-100
    graphics board built for the enjoyment of the process, with AI used
    only to build the software toolchain around it, not the hardware.
2026-09-25 Build czgfx as a LIB80 library; add LIB80/CREF80 to the pristine disk
    LIB80.COM and CREF80.COM (from MASM-80.ZIP, validated on a separate test
    disk first; its M80/L80 are byte-identical to ours) are now on the
    pristine CPM22-8MB-56K-DEV.DSK. The image was staged and tested on
    copies, never mounted in place: 70 sectors changed (2 directory + 68
    file records), all well-formed.
    czgfx now ships as one library:
    - CZBUILD.SUB combines the five modules with LIB80 into CZGFX.REL (in
    single-pass search order), checks it with LIB80 /U, and publishes only
    CZGFX.REL, CZGFX.INC and CZLINK.SUB to the library disk.
    - CZLINK.SUB is now just L80 $1,B:CZGFX/S,$1/N$2/E.
    Fix library pruning: M80 emits eve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
2026-09-25 Make display resolution explicit and per-project in the tool flow
    altairsim's cadzilla board now defaults to 1024x768 (was 640x480) and
    takes 640x480, 800x600 or 1024x768 via cad0's `mode` strap. The pristine
    machine never set it, so every project silently inherited the new strap
    while its code still programmed 640x480 timing -- and the board doesn't
    reject a mismatch, it just shows the picture in the wrong place.
    - pristine cadzilla.toml states cad0 mode = "1024x768" explicitly
    - sync_pristine.sh appends a project's tracked software/<project>/
    machine.toml overlay (board tables only) to its work/cadzilla.toml,
    so a project's resolution survives resyncs and fresh clones
    - new-cadzilla-p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
2026-09-25 Port firstdraw, drawdemo and gfxdemo to 1024x768
    All three programmed 640x480 timing; they now program 1024x768 and each
    pins that in a tracked machine.toml overlay (cad0 mode) so a future
    change to the pristine default can't re-strap them.
    - gfxdemo: GINIT CZM1K; layouts scaled x1.6 (exactly 1024/640 and
    768/480), spoke and sine tables regenerated, dot band widened
    - drawdemo: 1024x768 register table, ORG and CLR; every screen scaled
    x1.6, curves regenerated from their formulas; the RLINE spiral is 146
    segments so it clears the top edge
    - firstdraw: re-laid out rather than scaled, keeping its pixel-exact
    details (8x8 corner markers, 300-pixel figures, 25-pixel line grid)
    Verified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
2026-09-25 Add ACRTC modes, curves, PAINT, PTN and copy to czgfx; extend gfxdemo
    altairsim's HD63484 model now executes every ACRTC command and honours
    the operation, color and area modes and a live pattern pointer. czgfx
    now drives all of it:
    - drawing mode: every drawing command carries CZDM (AREA COL OPM);
    GMODE/GOPM/GCMODE/GAMODE, GBCOL (CL0), GCCMP, GAREA/GAFULL, GGETCP
    - pattern RAM: GPAT/GTILE tables, GLDPAT, GPSCAN/GPPTR scan window
    and pointer, GLSTYL line styles, GPTN (pattern as a picture)
    - curves: GCIRC, GELLIP (true semi-axes, a:b scaled at run time),
    GARC/GRARC, GEARC/GREARC
    - GPAINT/GFLOOD and GCOPY in eight orientations
    - four new modules (CZMODE, CZPAT, CZCURV, CZFILL); CZBUILD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
2026-09-26 Add a real-time work machine, cadzilla-real.toml, to every project
    work/cadzilla.toml runs flat out: the 8080 at host speed and every ACRTC
    command done at once. That suits building, but not a timing-sensitive
    program. pristine/cadzilla-real.toml is a delta on the cadzilla.toml beside
    it that sets cpu0 clock_hz = 2000000 and cad0 draw_rate = "real", so a
    project's disks, library disk and resolution carry over. sync_pristine.sh
    copies it into every work/, on a full sync and with --machine-only.
    Needs an altairsim with cad0's draw_rate strap.
2026-09-26 cadzilla-real.toml: say plainly why an older altairsim refuses the file
    An altairsim without cad0's draw_rate strap refuses the file because cad0 has
    no draw_rate property; say that, rather than calling it "a cadzilla property".
2026-09-26 drawdemo: add screens 12-21 for the rest of the ACRTC; speed up 1 and 10
    the operation, color and area modes. drawdemo gains ten screens:
    CRCL, ELPS, AARC/RARC, AEARC/REARC, PAINT, PTN, AGCPY/RGCPY, the eight
    operation modes, the color modes with line styles and pattern zoom,
    and the area modes (clip, hole, stop, stop inside).
    - Screens 12-21 are FIFO scripts: tables of ACRTC command words, one
    commented DW chunk per command, sent as they are by a new RUNSCR.
    - The drawing parameters (pattern RAM, scan, CL0/CL1, CCMP, EDG, area)
    are reset before every screen so no screen leaks into the next.
    - Screen 1 draws 5000 ran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
2026-09-29 czgfx: add a pixel read and run-time pattern scan/reset routines
    Three routines for programs that choose their parameters at run time,
    written for CZBASIC so it needs no board knowledge of its own:
    - CZRDOT (CZMODE; macro GRDOT x,y): read the pixel at X = HL, Y = DE
    into A, carry set if it is off the screen. It points RWP at the word
    (rows*m*256 + (X AND NOT 1)*8, a raster being 16*m words) and reads
    it with RD through the read-FIFO routine CZGCP already used. Works in
    all three modes. The RD opcode is OPRD in CZGFX.INC.
    - CZPSCN (CZPAT): the pattern scan window, zoom and pointer from a
    6-byte table, the run-time form of the GPSCAN macro.
    - CZPDEF (CZINIT; macro GPDEF): the patter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
2026-09-29 Add CZBASIC: an MBASIC 5.21-compatible BASIC with CADzilla graphics
    software/czbasic is a BASIC interpreter for CP/M 2.2 in 8080 assembly
    (M80/L80, 25 modules). It runs MBASIC 5.21 programs and adds CZ...
    statements for the board: CZINIT, CZLINE, CZRECT, CZCIRCLE, CZARC,
    CZPOLY, CZPAINT, CZCOPY, CZPAL, CZTEXT (8x8 font, scaled and turned)
    and the rest, and the functions CZPOINT, CZXMAX/CZYMAX, CZXPOS/CZYPOS.
    All board access goes through czgfx.
    - Language: integer/single/double in MBF, strings, arrays, DEF FN,
    PRINT USING, sequential and random files, LOAD/SAVE/MERGE, CHAIN
    with COMMON, EDIT/AUTO/RENUM, ON ERROR/RESUME. Programs are stored
    in MBASIC's tokenized form, so binary SAVE fi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
2026-10-01 pld: add CUPL templates for the eight GAL16V8s
    One template per GAL (U45, U46, U48, U55-U58, U60) with the CUPL
    header, the device mode each part needs, and PIN declarations taken
    from the KiCad schematic netlist. Each pin comment names the net and
    where it goes. The equation sections are TODO stubs only; no logic yet.
    Modes:
    - U45, U60: G16V8MA (complex). U45 drives the open-collector S-100
    RDY and ~SIXTN lines, which need .OE; U60 uses pins 14-17 as inputs.
    - U48: G16V8MS (registered), clocked by CXCLK on pin 1. PCLK is a
    combinatorial copy of CXCLK taken from pin 2.
    - U46, U55-U58: G16V8AS (simple), combinatorial only.
    The U55-U58 headers describe how the 1 bpp overlay (U19) shares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
2026-10-01 docs: add component datasheets
    Reference datasheets for the board's parts: the HD63484 ACRTC (user
    manual, datasheet, electrical specification), the Bt453 RAMDAC, the
    GAL16V8, the CY62136ESL SRAM, the 74F676 shift register, and the
    74ALS573/857, 74F245 and 74LS04/85/86/240/374 logic. The ACRTC, Bt453
    and LS85/86 sheets are markdown transcriptions; the rest are vendor PDFs.
2026-10-01 pld: write the GAL16V8 equations; fix the README SW1-6 description
    Equations for all eight GALs replace the template TODO stubs (Revision
    02), with JEDEC fuse maps in pld/jed/ and test vectors in pld/src/*.si.
    - U45 (complex): S-100 decode for the ACRTC (+0/+2, RS = A1) and Bt453
    (+4..+7). ACRTC CS is taken from status for the whole cycle, R/W =
    !sOUT, and a write CS waits for the R/W pin. RDY waits for ~DTACK.
    ~SIXTN is asserted only for 16-bit transfers to +2. Both
    open-collector enables use the CRT_CS pin feedback, because a
    complex-mode output enable is a single product term.
    - U46: host buffer enables (U38/U39/U40) and direction, MODE write at
    +1, and the Bt453 register sel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
2026-10-01 czbasic: add a bootable demo disk
    demodisk/CZBDEMO.DSK boots CP/M 2.2 and holds CZBASIC.COM, the CADzilla
    demos (CZDEMO plus STARBRST, XORBAND, SHAPES and PALANIM from demos/), the
    MBASIC sample programs (STARTRK, STARINS, LUNAR, TICTAK), PIP, STAT and a
    CZBASIC.TXT readme. demodisk/cadzilla.toml boots it as the only drive.
2026-10-01 pld: U48 re-syncs the interleaved display slot on DISP1 only
    Drop ~DRAW from U48 (Revision 03); the schematic no longer connects it.
    SLOT is re-synced at the start of every line by the first
    DISP1-active cycle, which always finds BLANK still set. The phase
    cannot drift within a line because U48 generates 2CLK itself, so ~DRAW
    added nothing. Pins 8 and 9 are now unconnected, pin 17 is commented as
    the SLOT net, and BLANK is back to 7 of its 8 product terms.
    The U48 vectors drop the ~DRAW scenarios; all 714 pass against the
    compiled product terms.
2026-10-02 pld: decode display fetches in U48; gate SRAM display reads with FETCH
    The original HD63484 manual scan (Fig 2.1(d)) shows that ~AS pulses only
    in display (S/W) and refresh-address (R) cycles, and R cycles only occur
    while ~HSYNC is low. Idle drawing-possible slots and porch cycles have
    no ~AS. ~DISP1 lags the fetches by one memory cycle (single) or two
    (interleaved), so sampling it at each load put BLANK one 16-pixel word
    late: the first word of every line was blanked, and a stale word was
    shown after the last fetch.
    U48 (Revision 04) now takes ~AS, ~DRAW and ~HSYNC (pins 8, 9, 4) and
    decodes each fetch itself:
    - FETCH (pin 17) is set by ~AS and cleared in the data half if ~DRAW or
    ~HSYN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
2026-10-02 docs: correct the HD63484 Fig 2.1(d) and 2.3(b) descriptions from the scan
    The transcribed figure descriptions said ~AS pulses every memory cycle.
    The original manual scan shows ~AS pulses only in display (S/W) and
    refresh-address (R) cycles. Idle drawing-possible slots and porch
    cycles have no ~AS, and ~DISP1 lags the display fetches (one memory
    cycle in single access, two in interleaved/superimposed).
2026-10-05 schematics: add the Revision A KiCad project and fab outputs
    Revision A as sent out for fabrication: the KiCad project, PCB, root
    schematic and its seven hierarchical sheets, the symbol/footprint lib
    tables, the BOM (cadzilla.csv), the plotted gerbers and drill files in
    gerbers/, and the fab package as submitted in fab/cadzilla-revA.zip.
2026-10-05 czgfx: add the 1bpp overlay and text with 8x8/9x11 fonts; CZBASIC text on czgfx
    The overlay (altairsim's cadzilla model, feat/cadzilla-overlay):
    - CZOVL.MAC: GOVON/GOVOFF show and hide it, GOVPAL sets overlay color 2,
    GOVL/GFRAME switch every drawing macro between the overlay and the
    frame. Both first wait for the ACRTC, then switch CCR GBM (1/8 bpp)
    and send the ORG for that plane.
    - CZINIT sets up the upper screen (DN 0) as a never-displayed CHR screen,
    one bit per pixel with the frame's X,Y (MWR0, per-mode overlay ORG in
    each descriptor). It keeps a MODE shadow (CZMREG) and clears the
    overlay (CZOCLS, GOVCLS); after GINIT the overlay is hidden and white.
    Text:
    - CZTXT.MAC dra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
2026-10-05 czgfx: versioned releases, pinned per project in a self-contained work/
    M80 projects used to mount the one shared library build disk
    (software/czgfx/libdisk/) by relative path. So every czgfx change reached
    every project at once, and each work/ depended on a disk outside it. Now
    each project builds against a czgfx release it chooses, from its own copy:
    - CZGFX.INC defines CZVERS (0100H = 1.0). CZCHK references it.
    - software/czgfx/tools/release.sh snapshots the built library disk as
    releases/CZGFXLIB-<major>.<minor>.DSK: tracked, read-only, never
    overwritten, and refused if the build disk is older than its sources.
    Release 1.0 is the current library (overlay and text).
    - software/<pro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
2026-10-06 docs: add the czgfx user guide (docs/czgfx-guide.pdf)
    A 28-page guide to the czgfx graphics library, made the same way as the
    other manuals in docs/ (ReportLab, same cover and styles).
    - Chapters: getting started, conventions, display setup, drawing,
    curves, the drawing modes, the pattern RAM, PAINT and copy, the
    overlay, text, reading back, and library versions.
    - Appendices: every macro, the routines by module (with measured sizes),
    the equates, building and extending the library, and the limits.
    - software/czgfx/tools/mkguide.py generates it. The palette chart comes
    from czgfx's palette tables and the font charts from tools/mkfont.py,
    so they match what the board draws.
    - docs/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
2026-10-06 testpat: add the board bring-up test pattern program
    An M80/czgfx menu of pixel-exact test screens for bringing up a Rev A
    board: single-pixel border, vertical lines at a 16-pixel pitch at each of
    the 16 shift-register offsets (one at a time and as a 16-band staircase),
    bit-plane bars, per-position bank ID, the same line tests on the overlay
    registered against the frame, solid fields, ramps, checkerboards and a
    geometry grid. Patterns size themselves from the current mode, and M
    re-inits the board at 640x480, 800x600 or 1024x768.
    Console messages name the chips each offset exercises (SRAM bank and
    byte, 74F245 buffer, 74F676 input), taken from the schematic netlist.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
2026-10-07 z88dk: add a host cross-assembler toolchain for the 8080, 8085 and Z80
    A third toolchain beside DRI ASM.COM and M80/L80. z88dk's z80asm (the
    snap) assembles on the host, takes Intel and Zilog mnemonics alike (even
    mixed in one file), and targets the 8080, 8085 or Z80. altairsim only
    copies the finished .COM onto the project's CP/M disk with R and runs it.
    - tools/z88dk/z88build.sh software/<name> builds src/*.Z88 (the module
    with the ORG is the main one) into build/<NAME>.COM, plus .MAP, .LIS
    and a DR-style .SYM of the program labels for SYMBOLS LOAD.
    - It reads the CPU from the cpu0 block in the project's machine.toml.
    The same block replaces pristine's 8080 card in work/cadzilla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
2026-10-07 zcc: add a C toolchain for the 8080, 8085 and Z80 (z88dk)
    A fourth toolchain beside DRI ASM, M80/L80 and z88dk's z80asm. z88dk's
    zcc (the snap; sccz80 + the classic CP/M C library) compiles C on the
    host into build/<NAME>.COM, which altairsim only R's onto the project's
    disk and runs.
    - tools/z88dk/zccbuild.sh software/<name> builds src/*.c (the file with
    main() names the .COM) plus any src/*.Z88 assembly modules, which
    z80asm assembles for the same CPU and the C code links with.
    - The CPU is the same machine.toml cpu0 block as for z88dk projects;
    it picks zcc's C library (-clib=8080 / 8085 / default for the Z80).
    - Outputs are uppercase: .COM, .MAP, per-module .LIS (C source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
2026-10-07 cz88gfx: port the czgfx graphics library to z88dk's z80asm
    czgfx stays the all-period-tools library (M80/LIB80/L80 inside CP/M).
    cz88gfx is an independent port of it for the z88dk host flow: the same
    8080 routines, names, register conventions and macros, built on the
    host into a z80asm library that links into an 8080, 8085 or Z80
    program. The two share no files.
    - software/cz88gfx/src: the 14 modules as .Z88 (Intel mnemonics kept).
    Each assembles to the same bytes as czgfx 1.0's M80 module, checked
    against the M80 .PRN listings. The one source change is CZTXL's
    Intel JP (jump if plus), which z80asm needs as JP P,NLA1.
    - CZ88GFX.INC: czgfx's equates, an EXTERN for every library symbol,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
2026-10-07 cz88gfx 1.1: C bindings for zcc, and cgfxdemo (z88demo in C)
    A zcc (C) program can now draw on the board. The bindings sit inside
    cz88gfx rather than reimplementing it in C: sccz80 widens every port
    test to 16 bits (a FIFO poll is 9 instructions and 2 library calls per
    pass against 3 in assembly), so each C function is instead a few
    instructions of assembly that jump into the library's own routine. A
    C program therefore draws exactly what a .Z88 one does, at the same
    speed.
    - software/cz88gfx/src/cz88gfx.h: the C API. cz_ + each macro's verb
    (cz_init, cz_line, cz_box, cz_circle, cz_arc, cz_paint, cz_copy,
    cz_text, cz_ovl, cz_wait, ...), CZ_ constants (CZ_RED + CZ_BRIGHT,
    CZ_OM_EOR, CZ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
2026-10-07 docs: add the cz88gfx user guide (docs/cz88gfx-guide.pdf)
    A 34-page guide to cz88gfx, for both of its languages, made the same
    way as the other manuals in docs/ (ReportLab, the czgfx guide's cover
    and styles). The C functions are stubs over the same routines, so it
    is one guide rather than two: each chapter describes a feature once
    and shows the assembly (z80asm) and C (zcc) forms side by side, with
    separate sections where the languages differ (3.2 z80asm's macro
    rules and traps, 3.3 C's types and calling conventions).
    - Chapters: introduction (one library, two languages; why C calls the
    library rather than the ports), getting started, conventions,
    display setup, drawing, curves, the dr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
2026-10-09 rmac: add a DRI RMAC + LINK-80 toolchain, with rhello and its skill
    The pristine CPM22SYS.DSK now carries DRI's relocating assembler package
    from the CP/M 3 distribution: RMAC 1.1, LINK 1.31, LIB 1.1 and XREF 1.3.
    They run unchanged on our CP/M 2.2. LINK's [OP] option writes a .PRL, the
    format of a GSX-80 device driver, which L80 can't make.
    The tools came from yazecpm3.zip, the set that includes the patched RMAC.
    The image was staged and tested on copies, never mounted in place:
    - 408 sectors changed: 2 directory sectors plus the tools' 406 records;
    - the tools R/W round-trip byte-exact, and check_dsk reports ok.
    Verified on the 8080 machine:
    - two-module .COM links;
    - [OP] .PRL output: t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
2026-10-09 ddcz: start the CADzilla GSX-80 driver (phase 0 spike)
    software/ddcz is an RMAC + LINK project that builds DDCZ1K.PRL, a GSX-80
    GIOS (screen driver) for the board at 1024x768. LINK links the driver
    against the pinned czgfx 1.0 release, mounted read-only as B:
    (attach_libdisk.sh):
    LINK DDCZ1K=DDCZ,DM1K,B:CZGFX[S,OP]
    LINK searches the LIB80-built library and loads only the modules used.
    The PRL is 1882 bytes, and the entry is its first byte (DDCZ, on its own
    stack).
    The spike implements:
    - Open, Close, Clear and Update Workstation (the full intout/ptsout answer
    and the GSX default palette);
    - polyline, polyline colour index and the writing mode;
    - every other opcode as a no-op.
    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
2026-10-09 ddcz: phase 1 -- every output function a GSX CRT driver needs
    The CADzilla GSX-80 driver is now seven RMAC modules. DDCZ1K.PRL is
    13837 bytes: 9.3 KB of code and 4.5 KB of data, czgfx included. Modules:
    - DDCZ: the entry, the dispatch, the workstation functions, the writing
    mode, and the state and helpers the others share.
    - DDATTR: the attribute setters, each returning the value it selected.
    USEPAT manages the ACRTC pattern RAM, which lines, fills and text all
    share.
    - DDPRIM: polyline (5 linetypes); polymarker (5 types, spokes drawn to
    the centre so XOR is exact); text (CZF8/CZF11, scale 1-16, positioned
    by the baseline, up vector to the nearest 45 degrees, opaque in replace
    mo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
2026-10-09 ddcz phase 2: three display modes, a 62K CP/M, real GSX applications
    The driver now builds as three PRLs from one source:
    - DDCZ1K, DDCZ800 and DDCZ640, which differ only in their mode modules
    DM1K/DM800/DM640;
    - ASSIGN.SYS lists them as workstations 01-03;
    - each is verified full-screen with GSXTEST on a board strapped to its
    mode.
    A 62K CP/M on the pristine disk:
    - GDOS loads its driver out of the application's TPA. On the 56K system,
    DR Graph needs a driver of 6.2 KB or less and DEMOGRAF about 8 KB
    (measured with dummy PRLs listed first in ASSIGN.SYS).
    - So CPM22SYS.DSK is now a 62K CP/M 2.2, built on a copy with the disk's
    own MOVCPM8M 62 * and SYSGEN: CCP C600, BDOS CE06, BIO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
2026-10-09 ddcz: keyboard input (locator, valuator, choice, string), DR Draw cached
    The driver now does every GSX input function: a new module, DDINP.ASM,
    handles opcodes 28-31 and 33 from the CP/M console through BIOS
    CONST/CONIN.
    - Locator: in request mode the overlay crosshair moves with the ANSI
    arrows (8 pixels) or ^E ^X ^S ^D (1 pixel) until a terminator key.
    - Valuator, choice (keys 1-9) and string (echoed in the text
    attributes).
    - Each device class has its own input mode, request or sample.
    Open Workstation now reports an input/output workstation with one device
    of each class.
    Input pushed DR Graph's GRAPHC.OVL out of memory, so the driver was cut
    from 12.4 KB to 11.2 KB:
    - fill patterns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
2026-10-09 ddcz: record why DR Draw doesn't run yet; cache its GSX-80 1.1
    DR Draw was tried on a CP/M 3 for this machine (a non-banked CP/M 3 for
    the FDC+ 8MB drives, 47K TPA). It needs more than CP/M Plus:
    - a Z80 (it uses LDIR);
    - about 61K of TPA. Its variables sit at fixed addresses up to B8A2H, and
    GSX-80 plus this driver put the top of the TPA at 8D00H.
    So it needs a banked CP/M 3 and a driver of about 7K. The ddcz README
    explains this, and DR Draw is set aside for now.
    fetch_upstream.sh now keeps DR Draw's own GSX.SYS (GSX-80 1.1), which its
    GSX loader needs. DR Graph still gets GSX-80 1.0.
2026-10-11 schematics: track cadzilla.xls
2026-10-11 README, CLAUDE.md: describe the 1bpp overlay and 2.2 MB of video memory
    The intros mentioned only the 2 MB frame buffer. The board also has a
    256 KB 1-bit-per-pixel overlay (U19), mapped pixel for pixel onto the
    frame buffer and shown over it in the Bt453's overlay color, for text,
    cursors, grids and annotations. That makes about 2.2 MB of video memory
    in total. CLAUDE.md also records how the overlay is drawn (a CHR screen
    that is never displayed) and the OLEN and OLSEL control bits.
2026-10-11 README: add the overlay to "Frame buffer and feature support"
    The section listed only the 2 MB frame buffer. It now gives the 2.2 MB
    total, and adds the 256 KB 1bpp overlay (U19): how it is mapped and
    displayed, and how OLEN and OLSEL control it. "Cursors not supported"
    now says that it is the ACRTC's own hardware cursor that isn't
    supported, and that a cursor can be drawn in the overlay instead.
2026-10-12 Add licensing: CERN-OHL-P-2.0 hardware, GPL-3.0-or-later software
    - LICENSES/: the CERN-OHL-P-2.0 and GPL-3.0 texts
    - LICENSE: which paths are under which license, the third-party
    material (datasheets, CP/M tools on the disk images) excluded from
    both, and the standard CERN and FSF notices
    - schematics/NOTICE: CERN-OHL-P notice for the KiCad files
    - SPDX-License-Identifier and copyright headers in every source file
    (frozen releases, KiCad, .jed, .SUB and .BAS left as they are);
    both mkfont.py generators and new_project.sh's templates emit them
    - README.md, software/README.md, CLAUDE.md: license sections and the
    header convention
    Every build output is unchanged by the headers.
    Co-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
2026-10-23 software/zcc/dxfview: an AutoCAD Release 10 DXF viewer
    DXFVIEW reads an AutoCAD R10 DXF file under CP/M and draws it at
    1024x768 in AutoCAD's 256 colors, with zoom and pan from the keyboard.
    It is C for the 8080 (zcc), drawing with cz88gfx 1.1.
    - What it draws: LINE, POINT, CIRCLE, ARC, TRACE, SOLID, 3DFACE, TEXT,
    ATTRIB, POLYLINE with bulges, and nested INSERT/MINSERT/DIMENSION
    blocks, with AutoCAD's off/frozen layer and BYLAYER/BYBLOCK rules.
    - Views: it opens a drawing in its saved *ACTIVE VPORT view (3D,
    perspective), and V gives the plan view.
    - Display list: as in AutoCAD's display-list drivers, a regen does
    all the floating point once. It turns the drawing into 16-bit
    integ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
2026-10-24 docs/design: add memory-cycle timing analysis
    Worst-case budget for display and drawing cycles at 2CLK = 8 MHz
    (and 8.125 MHz for 1024x768): ACRTC edge references checked against
    the Fig T-7/T-8 scans, part timing from docs/datasheets, margins for
    every setup/hold path, and the points to verify on hardware.
2026-10-24 docs/design: add +5V power estimate
    Per-part supply current from the datasheets (about 3.6 A typical,
    4.5 A worst case), U59 LM1084 dissipation against the S-100 +8V
    input voltage, the assumptions behind the gaps, and what to measure
    on hardware.
2026-10-24 docs: compare 74F245 replacements in the power estimate
    Add a replacement study for the 21 74F245 buffers to
    docs/design/power-estimate.md: the drawing-read timing limits a
    replacement must meet, read margin, disabled supply current, drive
    and era for nine '245 families, board current and U59 dissipation
    per option, and a ranking (74ABT245B first, and substantially cheaper
    than the 74BCT245).
    Add the TI datasheets the comparison is drawn from to docs/datasheets.
2026-10-24 tools: one-step setup and a per-project build.sh
    A fresh clone needed every project's work/ made by hand and every build
    typed at the altairsim console. Now:
    - tools/setup.sh checks the dependencies (bash, python3, coreutils,
    altairsim with cad0's draw_rate, z88dk optional) and builds every
    project, skipping the z88dk/zcc ones without z88dk.
    - tools/build.sh builds one project: it creates or refreshes work/
    (sync_pristine.sh, attach_libdisk.sh; --clean re-syncs), does the
    host build for z88dk/zcc, then the CP/M side, leaving the program on
    the project's A: so `altairsim cadzilla.toml` in work/ runs it.
    - tools/altairsim/scripts/cpmsession.py drives `altairsim --mcp`
    headlessly w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
2026-10-26 software/z88dk/czdiag: add a low-level board diagnostic
    CZDIAG tests the board from the bottom up, each layer only with what
    the layers under it have shown to work: the Bt453 (address register,
    palette RAM, overlay colors, decode), the MODE register, the ACRTC's
    control registers through AR, its FIFOs and command interface
    (WPR/RPR, WPTN/RPTN, every SR flag, CER), the clock and display time
    base (RCR, and the pixel clock measured against the CPU clock), and
    frame-buffer and overlay memory through RWP + WT/RD and DWT/DRD,
    naming the failing bank and chip.
    It is standalone (no czgfx/cz88gfx), every wait times out, it never
    sets MODE AMODE or the CCR interrupt enables, and it warns before the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
2026-10-26 tools/demodisk.py: every program on one bootable demo disk
    tools/demodisk.py gathers the programs of every project with a
    machine.toml (not the hello examples or the libraries' link checks)
    onto a copy of pristine's CP/M 2.2 system disk, demodisk/CADZILLA.DSK,
    with a machine that boots it (Z80 by default, 1024x768) and a
    README.TXT listing them. It first rebuilds any project whose program is
    missing or out of date, brings dxfview's drawings, CZBASIC's demos and
    the GSX-80 runtime with the ddcz drivers, and GENGRAFs the GSX clients.
    The disk is made in demodisk/.build/ and moved into place only once its
    sectors check out. demodisk/ is gitignored; skill cadzilla-demo-disk.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
2026-10-28 software/m80/czgfx: 1.1, WPTN counts words; move every project to it
    On the real HD63484, WPTN's count n is in words, even on the 8-bit bus.
    The czdiag bring-up of two boards found this, checking it with RPTN. It
    matches the manual's own WPTN-2 example, but not WPTN-1's "bytes" note.
    czgfx 1.0 sent byte counts, so on the real board GINIT's n = 32 took the
    16 words after the pattern (PRC, CL0, CL1, CCMP, EDG, MASK) as pattern
    data.
    - CZINIT.MAC: GINIT's pattern fill sends n = 16, with a note on WPTN-1.
    - CZPAT.MAC: CZLPAT no longer doubles n, and CZLSTY sends n = 1.
    - CZTXT.MAC: a glyph's n is the cell height, no longer doubled.
    - CZGFX.INC: CZVERS 0101H. The release is releases/CZGFXLIB-1.1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
2026-10-28 software/z88dk/cz88gfx: 1.2, WPTN counts words; move its projects to it
    On the real HD63484, WPTN's count n is in words, even on the 8-bit bus,
    as the czdiag bring-up of two boards measured (the manual's WPTN-1 says
    bytes). cz88gfx, like czgfx 1.0, sent byte counts, so on a real board
    GINIT's n = 32 swallowed the 16 words after the pattern (PRC, CL0, CL1,
    CCMP, EDG, MASK) as pattern data. czgfx 1.1 has the same fix.
    - CZINIT.Z88: GINIT's pattern fill sends n = 16.
    - CZPAT.Z88: CZLPAT no longer doubles n, and CZLSTY sends n = 1.
    - CZTXT.Z88: a glyph's n is the cell's rows, no longer doubled.
    - The C bindings only jump into CZLPAT/CZLSTY and the check programs
    send no WPTN of their own, so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
2026-10-28 drawdemo: WPTN counts words, not bytes
    On the real HD63484 WPTN's n is the number of pattern words, on the
    8-bit bus too: n = 2 for one word leaves the command waiting and it
    swallows the next command's opcode as pattern data. The manual's own
    WPTN-2 example agrees (n = 2 for two words); only WPTN-1's "words x 2"
    note is wrong. altairsim now behaves like the chip, so drawdemo's
    pattern and line-style screens got command errors.
    All 17 WPTN counts are halved: the seven 16-word pattern loads, the
    nine one-word line styles and DPINIT. A note at DPINIT says why.
    Verified: assembles clean, and DRAWDEMO.HEX is byte-identical to
    altairsim's verified copy; all 21 screens draw with CER clear on the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
2026-10-28 pld: fix four ACRTC decode races (U45 rev 03, U46 rev 05)
    Found bringing up two real boards with czdiag in an Altair 8800c (2 MHz
    8080); altairsim models none of them. Each needs a small board rework,
    noted in the .pld headers (the schematic doesn't show them yet):
    - RS followed the next opcode fetch's A1 while CS was still low (CS
    ends on the slow IODEC path), so an AR write could become a data
    write. U45 rev 03 holds RS and R/W while CS is low; RS moves to pin
    16 (feedback) and ~SIXTN to pin 12.
    - Stale sINP/sOUT in T1 of the next cycle plus a fetch at xx70/xx72 made
    a spurious ACRTC access: the BIOS console output (OUT 11H at E06E)
    wrote every character into AR. U46 rev 03 adds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
2026-10-28 czdiag: follow the real HD63484 and document the board fixes
    - WPTN's n counts words on the 8-bit bus (the chip and the manual's
    WPTN-2 example; WPTN-1's "x 2" is wrong): the mode load, the pattern
    RAM test and the FIFO flag test.
    - RPR returns all 16 bits of Pr06, Pr0C and Pr0D: drop the masks for
    the bits Figure 5.25 calls always 0.
    - STR=0 doesn't hold drawing on the real chip: report it neutrally.
    - A pixel clock over 65.535 MHz no longer matches the 65 MHz oscillator.
    - README: what the real boards showed, the four decode faults and the
    PLD revisions that fix them, results on altairsim and on board A.
    altairsim (word-counting build): 28 PASS / 1 FAIL (RCR isn't modeled).
    Boards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
2026-10-28 czbasic: demo disk on 62K CP/M with the czgfx 1.1 build
    The demo machine boots the 62K system now, and CZBDEMO.DSK carries the
    current CZBASIC.COM, linked with czgfx 1.1 (WPTN in words).
2026-10-28 drawdemo: keep ELPS/EARC in range and finish PAINT on the real chip
    Two faults found running drawdemo on board B (Altair 8800c, 2 MHz
    8080); altairsim models neither.
    - Screens 13 and 15 hung: the real HD63484 never ends an ELPS or
    elliptical arc whose a, b are too long for dX (manual ELPS-3:
    la + ldX <= 13 and lb + ldX <= 13). The screens sent a or b = 8191
    with dX up to 480. They are redesigned around exact small-integer
    axis ratios inside the rule: 13 a globe, a flat and a tall family and
    a 4:3 ellipse; 15 a dome of AEARCs and a REARC bouncing ball.
    - Screen 16 hung in PAINT: the chip keeps four pending seeds and hands
    more to the host through the read FIFO (X, Y, PP), stoppi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
2026-10-28 czgfx 1.2, 1.3: keep ELPS in range, finish PAINT on the real chip
    1.2: the real HD63484 never ends ELPS/AEARC/REARC when the bit lengths
    break la+ldX <= 13 or lb+ldX <= 13 (manual ELPS-3), and 1.1 broke it
    for all but small ellipses. CZELPS now sends ELPS only when the fitted
    ratio keeps dY within a pixel, and otherwise draws an RPLG polygon
    (64/128/256 sides) within a pixel of the curve. CZARC halves a and b
    to fit the arc's size and refuses (carry set) an arc whose X semi-axis
    could reach 4096. New equate OPRPLG.
    1.3: PAINT keeps only four seeds on the chip and hands the rest to the
    host through the read FIFO, then stalls until they are read, so a
    complex fill hung the board. CZPANT/CZFLO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
2026-10-29 cz88gfx 1.3: keep ELPS in range, finish PAINT on the real chip
    Port czgfx 1.3's two real-HD63484 hang fixes:
    - CZELPS keeps ELPS's parameter limit (ELPS-3) or draws an RPLG
    polygon; CZARC fits an elliptical arc to it or refuses it (CY).
    - CZPANT/CZFLOD drain PAINT's overflow seeds from the read FIFO onto
    a 32-entry stack and PAINT again from each (CY if seeds were dropped).
    CZCURV, CZFILL and CZMODE are byte-for-byte czgfx 1.3's. In C,
    cz_paint, cz_flood, their _cp forms and cz_earc_sq/cz_rearc_sq now
    return 0/1. Release 1.3 and regenerate the guide (revision 1.1).
    Add czptest (z88dk, 8080), the board check for both fixes; it passed
    on board B. Move z88demo and cgfxdemo to 1.3 (still pi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
2026-11-01 czgfx 1.4: survive AREA stop modes, PAINT only in CMSEL, GINIT waits
    Found on the real board (B, and A for the final builds):
    - After a command cut short by AMSTOP/AMSTPI the HD63484 sets no ARD
    and ignores every following command and read-back until it is
    aborted. A drawing command sent in a stop mode now sets a flag
    (CZSTM); the next command start waits and aborts (CZSTA, via CZCMD,
    CZXY, CZWPR, CZPUTC and the overlay switch). CZRDY always aborts
    before a read-back (GGETCP, GRDOT, the CP reads in PAINT and AEARC).
    CZABT keeps the pixel depth (CZCCR shadow) instead of forcing 8 bpp.
    - PAINT/FLOOD refuse any color mode but CMSEL (the chip never ends a
    fill whose painted pixels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
2026-11-01 cz88gfx 1.4: survive AREA stops, fill only in CMSEL, settle after GINIT
    Three more real-HD63484 findings, all verified on board B (and A):
    - After a command cut short by AMSTOP/AMSTPI the chip ignores every
    command and RPR until a CCR ABT, and sets no ARD. Commands carrying
    the drawing mode set a flag (CZMARK); every routine that sends a
    command word starts with CZSYNC (cz_sync in C), which waits and
    aborts. CZABT now returns to the CCR in force (CZCCR shadow kept by
    CZINIT/CZOVL/CZFRM), so an abort on the overlay stays 1 bpp.
    - PAINT/FLOOD in CMPRAM (and presumably CMCL1/CMCL0) never end: the
    chip re-seeds its own fill. CZPANT/CZFLOD refuse any color mode but
    CMSEL (CY, nothin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
2026-11-01 cz88gfx guide for 1.4; z88demo and cgfxdemo pin 1.4
2026-11-01 czptest: add CAP case, dense combs against the PAINT seed stack and cap
    Five combs of 50 to 450 one-pixel pockets are PAINTed from one strip.
    On a release build the 32-seed stack drops seeds after about 35 pockets
    (CY); on a dev build with PCAP lowered to 256 the 350- and 450-pocket
    combs hit the cap and abort, and a line drawn afterwards must read back.
2026-11-01 Add autodemo: free-running z88dk demo of seven animated screens
    Attract-mode demo for the 8080 using cz88gfx 1.4: bouncing vectors
    (random paths reflecting off the screen edges, a cascade of lines),
    bouncing circles morphing into ellipses, a palette-cycling tunnel,
    string art, rotating polygons, a radar sweep and confetti. Each screen
    runs a fixed step count tuned to 2.8-3.2 s under cadzilla-real.toml.
    Any key pauses; ESC, ^C or Q quits. No overlay, PAINT or AREA stop
    modes. Lookup tables come from tools/mktables.py.
    Listed in CLAUDE.md and README.md; demodisk.py describes AUTODEMO.COM.
2026-11-01 autodemo: stop the real-board hangs; stream the tunnel palette, align the library
    On board A, AUTODEMO hung after about three cycles, and a rebuild that
    only added bytes hung in GINIT instead. Two changes, the second one
    the real fix as far as a 17-cycle run on the board shows:
    - Screen 3 loads its 32 palette entries with one address write and 96
    data bytes (as CZPALD does) instead of a CZPALS per entry, and does a
    GWAIT before the first palette write.
    - The program ends with a pad that puts the cz88gfx library at a base
    of 2 mod 4. With that, every IN from the ACRTC is followed by an
    opcode fetch with the right A1, which clears the polling loops that
    hung (CZPUTW in the old build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
2026-11-01 autodemo: add tools/timedemo.py to time the screens on the real Altair
    Types AUTODEMO on the serial console, timestamps each screen banner and
    prints per-screen and per-cycle durations, for comparing with altairsim
    under cadzilla-real.toml (measured 21.01 s a cycle on board A against
    21.34 s in the simulator, 2.8-3.2 s a screen).
2026-11-01 cz88gfx 1.5: ACRTC port accesses independent of the link base
    Move every IN/OUT to the ACRTC (CZWREG, CZPUTW, CZWAIT, CZRDW, and a new
    CZRSR for CZFILL's PAINT poll) into one module, CZPORT, in an own
    4-aligned section (code_home, which the z88dk C startup lays out before
    the BSS). NOPs and dead space put each access where the next opcode fetch
    has the right A1 (70H: 0, 72H: 1), whatever the linker's base.
    tools/chkalign.py, run by tools/build.sh, fails the library build if any
    access outside CZPORT exists, breaks the rule, or lands unaligned in the
    check programs or in stubs linked behind 0-3 bytes of padding.
    Pictures are identical to 1.4 in the emulator; not yet tested on the board.
    Co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
2026-11-01 autodemo: use cz88gfx 1.5, drop the alignment pad and chkalign.py
    cz88gfx 1.5 keeps every ACRTC IN/OUT at a fixed alignment itself (CZPORT,
    4-aligned section), so the pad at the end of AUTODEMO.Z88 that put the 1.4
    library at a base of 2 mod 4 and autodemo's own tools/chkalign.py are not
    needed; the library's tools/chkalign.py replaces the latter.
    Board A: AUTODEMO with the 1.5 library and the pad ran 9+ cycles without a
    hang. This pad-less build is not yet board-tested.
2026-11-01 z88demo, cgfxdemo, czptest: move to cz88gfx 1.5
    Verified in altairsim only: z88demo's and cgfxdemo's ten screens (frame,
    palette and overlay) and czptest's console output are identical to the
    1.4 builds'. chkalign.py passes on each program's map.
2026-11-02 rockfall: a vector space rock shooter for the 8080 (z88dk, cz88gfx 1.5)
    A new z88dk project, 1024x768, 8080. Fly a small ship (W thrust, A/D
    turn, space fire, up to 8 shots in flight) through drifting rocks: a
    large rock splits into two medium ones, a medium one into three small
    ones. A raider crosses the screen and fires at the ship, aimed to 1/128
    of a turn and, from wave 2, leading a coasting ship. Five ships, a
    bonus ship every 10,000 points; a lost ship comes back in the middle at
    once, protected for 3 s or until nothing is near.
    Rocks never run out: at least MINBIG big rocks stay in play, topped up
    from each wave's quota, and the next wave starts when the quota is
    spent. Waves bring m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
2026-11-04 Display timing as measured on the real HD63484: czdiag, firstdraw, drawdemo
    Scope measurements on board B (64 MHz Y1, czdiag peek/poke) showed two
    places where the chip differs from the manual:
    - A front porch, HC+1 - HSW - (HDS+1) - (HDW+1), shorter than 5 memory
    cycles is stretched to 5. The old 1024x768 table asked for 2, so the
    line ran 87 cycles (45.977 kHz) instead of 84.
    - Single access makes HDW+2 display fetches, the first one cycle before
    ~DISP1, and U48 shows every fetch. HDW=63 showed 1040 px, with the
    next line's first word at the right edge. So HDW = words - 2.
    New tables (all verified by scope, 1024x768 also on a monitor):
    1024x768 HSR 5306H HDR 083EH (64 MHz, not VE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
2026-11-04 czgfx 1.5: measured display timing, interleaved 640x480; move its projects to it
    Every mode's table follows the real chip (front porch >= 5 memory
    cycles, HDW = visible fetches - 2): 1024x768 HSR 5306H HDR 083EH from
    64 MHz, 800x600 HSR 4107H HDR 0430H. CZM640 is now interleaved access,
    as intended from the start, for drawing speed: MODE 07H (AMODE=1) and
    OMR ACM=10, HSR 630CH HDR 034DH in 8-pixel cycles (timing verified by
    scope with the chip interleaved and AMODE=0; it needs the 25.175 MHz
    oscillator). CZINIT takes OMR's ACM from the descriptor's MODE AMODE
    bit, and starts the display itself instead of from RPOST. New equate
    MDAMOD.
    gfxdemo, czbasic, testpat and ddcz pin 1.5 and build.
    C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
2026-11-04 cz88gfx 1.6: measured display timing, interleaved 640x480; move its projects to it
    Ported from czgfx 1.5: 1024x768 HSR 5306H HDR 083EH (64 MHz), 800x600
    HSR 4107H HDR 0430H, and CZM640 interleaved (MODE 07H, OMR ACM=10, HSR
    630CH HDR 034DH; needs the 25.175 MHz oscillator). CZINIT sets OMR's
    ACM from the descriptor's AMODE bit through CZWREG, so every ACRTC
    access stays in CZPORT and the alignment check passes. New equate
    MDAMOD; the C bindings are unchanged.
    autodemo, czptest, rockfall, z88demo and cgfxdemo pin 1.6 and build.
    dxfview stays on 1.2 for now.
2026-11-05 dxfview: move to cz88gfx 1.6 (measured display timing)
    On cz88gfx 1.2 its picture wrapped by one word on the real board. 1.6
    is 1.2 KB bigger, which left too little heap for the tables, so
    DXFVIEW stopped with "not enough memory". The layer table goes from 96
    to 64, the block table from 160 to 96, and the stack from 2.5 KB to
    2.25 KB (SHUTTLE uses under 2 KB); the sample drawings use at most 8
    layers and 11 blocks. TEST, SHUTTLE and COLUMBIA all open and draw in
    altairsim from the 8080 demo disk.
2026-11-05 video-timing-test: 640x480 interleaved verified on a monitor
    Board B with the 25.175 MHz oscillator, TESTPAT (czgfx 1.5) M 6: the
    border, the overlay bands and all four checkerboards are correct, and the
    overlay is registered pixel for pixel in interleaved access.
2026-11-13 pld: U48 rev 05, ~BLANK one PCLK later
    Rev 04 changed ~BLANK on the same edge as PLOAD, and the Bt453 showed it
    one pixel ahead of the data: the leftmost pixel of every line was the
    74F676 serial-in zeros and the rightmost was blanked. ~BLANK now changes
    on the edge that ends PLOAD. Checked on board B with TESTPAT's border at
    640x480 and 1024x768.
    On revision 1 boards this is a race: the Bt453 latches ~BLANK on the PCLK
    edge that changes it, and it works because the heavily loaded PCLK arrives
    after ~BLANK. Revision 2 boards will clock the Bt453 from the oscillator
    through a single inverter. memory-timing.md has both.
